amussab/Digital-Twin-Senior-Proj/AI-engine/DESIGN.md

# AI-engine — design contract

Owner: ICS (Jaddoua). Coordinator-authored 2026-10-04. This file is the interface that the
ml-engineer, data-engineer, backend-engineer and digital-twin-engineer agents build against.
Change it deliberately and note the change at the bottom.

`AI-test/` is the earlier synthetic-only testbench. Reuse its code freely (dsp, payload, models,
rul, export). `AI-engine/` is the production engine. It is trained on real public run-to-failure
and seeded-fault data, then fine-tuned on rig data once that exists.

## 1. What it must achieve (from `Project architecture/overview/Specifications.md`)

| Spec | Target | Model / part |
|---|---|---|
| S7 (ICS1) | RUL MAPE ≤15% on held-out degradation window | N-HiTS (+ TFT-selected threshold) |
| S8 (ICS2) | Classification <200 ms/window | TFT |
| IS1 | Sensor→classify+RUL→dashboard <500 ms (ICS leg measured here) | engine + backend |
| IS3 | macro-F1 ≥85% over {healthy, outer_race, inner_race, ball, cage}; stage error ≤1; fault caught by stage 3 | TFT + staging |
| IS2 | Physics-AI RUL residual ≤5% stage 1→3 | needs a physics RUL (digital twin) |
| C4 / C5 | Local only; no cloud | engine is offline; backend binds to LAN |

## 2. Package layout

```
AI-engine/
  aiengine/
    config.py          constants mirrored from team docs + spec targets
    dsp.py             COE Components 3–7 (from AI-test), plus bearing_features(x, y, rpm, cfg) → 16
    geometry.py        bearing geometries per dataset → characteristic orders
    datasets/          one adapter per dataset → window table (schema §3), cached to parquet
      xjtu_sy.py  ims.py  mafaulda.py  synthetic_rig.py  common.py
    features.py        per-bearing engineered inputs (C#-portable), baselines
    labels.py          onset detection, ground-truth health stages, observable class, RUL labels
    splits.py          frozen bearing-level train/val/test splits → splits.json
    models.py          N-HiTS, TFT builders
    train.py           pretrain + finetune entry points
    rul.py             HI forecast → RUL; class-conditioned thresholds
    evaluate.py        spec scoring → reports/*.json + *.md (provenance on the face)
    export.py          ONNX + model_contract.json + golden test vectors
    engine.py          HybridEngine: runtime inference on 32-feature rig windows (reference impl)
  app.py               CLI: data | train | finetune | evaluate | export | demo | selftest
  models/              committed ONNX + model_contract.json + golden vectors (small)
  reports/             tracked evidence reports
  notebooks/           PPR evidence notebook
  data/                gitignored (raw/ + cache/)
```

## 3. Window table schema (every dataset adapter returns exactly this)

One row = one 20-revolution window of ONE bearing.

| column | type | meaning |
|---|---|---|
| dataset | str | `xjtu_sy`, `ims`, `mafaulda`, `synthetic_rig`, `rig` |
| unit_id | str | globally unique sequence key = one bearing in one run/record, e.g. `xjtu_sy:Bearing2_3`, `ims:test1:B3`, `mafaulda:overhang/cage_fault/20g/41.5:overhang` |
| bearing_key | str | physical bearing identity used for splitting (several units can share one: all MaFaulDa records of one fault-type+position+severity share an identity group, see §5) |
| window_index | int | 0..n-1, consecutive within unit, time-ordered |
| t_hours | float | machine time of this window since run start (NaN for non-time-series records) |
| rpm | float | measured shaft speed for the window |
| fault_class | str | ground truth for the unit: healthy / outer_race / inner_race / ball / cage / mixed / unknown |
| run_to_failure | bool | true only for units that end in failure |
| life_hours | float | total life of the unit (NaN if not run-to-failure) |
| rul_hours | float | life_hours − t_hours (NaN if not run-to-failure) |
| severity | str | seeded-fault severity tag (MaFaulDa mass, etc.), else "" |
| x_bp_rms … x_bpfi_mag | float32 ×8 | COE C7 features of axis X (order: bp_rms, bp_kurtosis, bp_crest, env_rms, ftf_mag, bsf_mag, bpfo_mag, bpfi_mag) |
| y_bp_rms … y_bpfi_mag | float32 ×8 | same, axis Y |
| fs_hz | float | source sample rate |
| band_hz | str | band-pass actually used (e.g. "2000-8000") |
| orders | str | JSON of the FTF/BSF/BPFO/BPFI orders used for this bearing |

Mapping to the rig payload: bearing 1 = features[0:16] (X = 0–7, Y = 8–15), bearing 2 =
features[16:32].

Windowing: cut each raw record into consecutive non-overlapping 20-rev windows using the record's
rpm. For snapshot-style run-to-failure data (XJTU-SY, IMS), keep **the first 20-rev window of
each snapshot** (one window per time step, rig-equivalent). Seeded-fault records (MaFaulDa) keep
all their windows.

## 4. Engineered model inputs (per bearing, C#-portable)

Baseline = per-unit healthy reference:
- **Run-to-failure units:** median of the first 24 windows.
- **MaFaulDa:** median over the speed-matched `normal` record at the same bearing position
  (nearest rpm). This is the commissioning baseline of that machine at that speed.
- **Rig:** the commissioning capture (spec M5).

Inputs are those of AI-test's `features.py`, re-expressed per bearing. `plane_asymmetry` is
replaced by `axis_asymmetry` (X vs Y envelope ratio). The ml-engineer may add or remove inputs
if validation supports it, but every input must stay arithmetic on (window, baseline).

## 5. Splits (frozen before any test scoring)

- Run-to-failure bearings (XJTU-SY 15, IMS test1 B1–B4): split by bearing, stratified by
  operating condition. Test bearings are listed in `splits.json`. Because N is small, also run
  leave-one-bearing-out cross-validation on train+val bearings for model selection only.
- MaFaulDa: split by **(position, fault type, severity) groups × speed blocks**, so test speeds
  are never seen for that group. Records at neighbouring speeds are near-duplicates, so a random
  record split leaks.
- IMS test1 is also the **fine-tuning demonstration domain**: pretrain without it, fine-tune on
  its train portion, test on its held-out portion. This is the "new machine" rehearsal for the
  team's rig.

## 6. Labels

- **Onset** (first predicting time): HI exceeds μ+3·max(σ, 0.01) of the 24 onset-baseline windows
  (HI windows 6–29, i.e. after a 6-window run-in skip) for 12 consecutive windows; onset = the
  first window of that run. The detector runs causally, so the same rule works at runtime.
  (Was μ+3σ, σ floor 0.02, 3 consecutive, no skip; changed 2026-10-04, see change log.)
- **Ground-truth health stage (1–6) for run-to-failure units:** stage 1 before onset. The
  degradation interval [t_onset, T_fail] is split into 5 equal-time parts → stages 2–6.
  `[CLAUDE-SYNTHESIS]` A defined labelling, documented as such.
- **Observable class:** `healthy` until onset, then the unit's fault_class (same detectability
  policy as AI-test). `mixed` / `unknown` units are excluded from classification but kept for RUL.

## 7. S7 metric — pre-registered (written before any test result exists)

- **Degradation window** = [t_onset, T_fail − 0.1·(T_fail − t_onset)]. The last 10% is excluded
  because RUL_true → 0 makes per-window percentage error unbounded there.
- **MAPE** = mean over held-out test bearings of (mean over that bearing's degradation-window
  windows of |RUL_pred − RUL_true| / RUL_true). Hours. Bearing-averaged, so long-lived bearings
  don't dominate.
- Also reported, never substituted: RMSE (h), PHM-2012 score, percent-of-life error, and MAPE
  over the full degradation window.

## 8. Runtime contract (engine.py, mirrored by C# via ONNX)

Input per rig window: `rpm` (f32), `features[32]` (f32), `t20_ms`, plus the stored per-bearing
baselines. HybridEngine keeps a rolling buffer per bearing. TFT needs `tft_encoder_length`
windows; N-HiTS needs `nhits_encoder_length` RUL-cadence steps. Before the buffers fill, it
returns `warming_up`.

Output per window per bearing:
```json
{ "bearing": 1, "fault_class": "outer_race", "class_probs": {...}, "confidence": 0.93,
  "health_index": 0.41, "health_stage": 3, "rul_hours": 12.4, "rul_interval_hours": [9.1, 16.0],
  "top_features": [["bpfo_share", 0.31], ...], "latency_ms": {"features": .., "tft": .., "nhits": ..} }
```
The backend maps the worse of the two bearings onto `DashboardSnapshot`.

`model_contract.json` carries: input names/order, encoder lengths, class labels in
output-channel order, feature constants, thresholds, and golden input→output vectors for C#
parity tests.

## Change log
- 2026-10-04: initial contract (coordinator).
- 2026-10-04 (ml-engineer, coordinator decision 1): `splits.py::_split_xjtu` policy v2, frozen in
  `splits.json` before any real-data model was trained or scored. One test bearing per operating
  condition; outer_race, inner_race and cage each get ≥1 test AND ≥1 training bearing; mixed and
  <60-window bearings not test-eligible; seeded draw among all valid assignments. Result:
  test = Bearing1_4 (cage), Bearing2_5 (outer), Bearing3_4 (inner); val = 1_3, 2_2, 3_5;
  train = the other 9. IMS: B1/B2/B3 ft_train, B4 ft_test (unchanged).
- 2026-10-04 (ml-engineer, coordinator decision 3): §6 onset rule tuned on XJTU-SY **train+val
  bearings only** (12 bearings; test bearings and IMS never looked at for this). Grid: σ floor
  {0.01…0.08} × consecutive {3,5,8,12} × run-in skip {0,6,12} windows. Pre-declared selection rule:
  (1) fewest false onsets, a false onset being a bearing whose post-onset windows fall back under
  the threshold more than 10% of the time; (2) fewest bearings with no onset; (3) earliest mean
  onset (fraction of life). Winner: σ floor 0.01, 12 consecutive, 6-window skip (0 false onsets,
  mean onset at 0.64 of life, mean post-onset reversion 0.8%). The old rule (0.02 / 3 / 0) had 1
  false onset (Bearing3_2, 19% reversion). Applied unchanged to every dataset.
  **Effect on IMS (reported, not tuned):** IMS test1 onsets still fire at window ~170 (~171 h) on
  B3 and B4. The HI of all four IMS bearings, including the healthy B1, steps up to a new plateau
  around that point, so this is a machine-level level shift after the 24-window baseline, not a
  bearing-level run-in that a per-bearing σ floor or a few-window skip can remove. Next lever:
  take the baseline after the run-in/settling period (the rig's commissioning capture, spec M5,
  is exactly that), or recalibrate the onset rule on the new machine's own ft_train data as part
  of fine-tuning (not done here: coordinator decision 3 forbids per-dataset retuning).
- 2026-10-05 (ml-engineer): TFT selected on XJTU-SY VAL bearings (`select tft`, grid encoder {6,12} ×
  class-weight power {0.25,0.5}; the original run used encoder 6 / power 1.0): encoder 12, power 0.25,
  val macro-F1 0.773 (`reports/model_selection_tft_20261004T210533Z.json`). Val holds only outer_race +
  healthy, so this choice is weakly informed for cage/inner. Ball: its only bearing (IMS B4) is the IMS
  fine-tune test bearing, so no training data has ball and the TFT has 4 output channels (cage,
  healthy, inner_race, outer_race). IS3 primary macro-F1 = the classes with train AND test support;
  the 5-class figure (ball F1 = 0) is reported alongside. `train.tft_predict` maps target labels the
  model has no channel for to a placeholder (the target is not an input; truth is merged afterwards).
- 2026-10-05 (ml-engineer, IS3 v2 with MaFaulDa): **MaFaulDa splits frozen in `splits.json` (section
  `mafaulda`, created 2026-10-05T00:41:52Z) before any MaFaulDa model was trained or scored.** Policy =
  `splits.py::_split_mafaulda` unchanged: one identity group per (position, fault, severity) (26 groups:
  2 healthy positions + 3 faults × 4 severities × 2 positions); within a group the records are sorted by
  rpm and cut into 5 contiguous speed blocks; block `(g + offset) % 5` → test, block `+2` → val, the other
  three → train (seeded offset), so test speeds of a group are never seen for that group and every speed
  range appears in test across groups. Result: 701 train / 235 val / 233 test units (5,922 / 1,907 / 1,911
  windows). XJTU-SY and IMS sections byte-identical to before (checked; pre-change copy in
  `checkpoints/real_v2/splits_before_mafaulda.json`). Residual risk, stated: the same speed can appear in
  training for a *different severity* of the same fault/position (groups are per severity, per §5).
  Baselines: the speed-matched `normal` record at the same position (`features.make_mafaulda_provider`,
  verified in use via `default_provider`); normal records never baseline themselves.
- 2026-10-05 (ml-engineer, IS3 v2): **labels.** MaFaulDa seeded faults are observable from window 0
  (the defect is physically present for the whole record, no run-in): `observable_class = fault_class` on
  every window (labels.py non-RTF branch). **Training (v2):** one joint TFT on XJTU-SY train + IMS
  ft_train + MaFaulDa train (IMS ft_train joins pretraining here, so the IMS test bearing B4 is scored by
  this same model; no separate TFT fine-tune). Early stopping and selection on VALIDATION only (XJTU-SY
  val 1_3/2_2/3_5 + MaFaulDa val blocks). Grid encoder {4, 6} (min 2) × class-weight power {0, 0.25,
  0.5, 1}; pre-declared rule in `aiengine/v2.py`. Dataset identity is not an input. Inner race comes only
  from XJTU-SY/IMS and has no validation support, so per-source confusion matrices are reported. N-HiTS and
  the RUL calibration are reused unchanged from run `real`; S7 is re-reported because the TFT class picks
  the RUL threshold. **v2 is the second look at the XJTU-SY/IMS test bearings** (v1 reports kept).
- 2026-10-05 (ml-engineer, IS3 v2 outcome): grid winner on VALIDATION = encoder 4 (min 2), class-weight
  power 0.5, **plus the causal onset gate on run-to-failure (continuous-monitoring) units** (pooled val
  macro-F1 0.917 vs 0.875 flat; `reports/model_selection_tft_v2_20261005T011306Z.json`). The gate is a
  decision rule on a flat 5-class TFT, carried in the contract as `classes.decision.type =
  "rtf_onset_gate"` (engine.py + `train.tft_predict` via a `<ckpt>.decision.json` sidecar): before onset
  confirmation p(healthy)=1; after it, fault probabilities renormalised, p(healthy)=0. Short seeded-fault
  records use the plain softmax. (A first aggregation had a bug, `p_fault_gate` counted as a class; fixed
  and re-scored from the saved val predictions before any test scoring.) Test scored once as `real_v2`:
  IS3a 5-class 0.581 (MaFaulDa 0.848, XJTU-SY 0.450, IMS 0.679): FAIL. Main failure is a source shortcut
  validation could not see: IMS B4 ball → inner_race (IMS B3 inner race is the only IMS-domain fault in
  training). Next lever (needs a fresh, untouched test set to claim anything): domain-balanced training
  or per-dataset baseline normalisation of the order-band shares.
- 2026-10-24 (ml-engineer, UP2 contract v3, [SYNTHETIC]): `aiengine/synth_v3` generator (2 bearings x biaxial, payload
  level; magnitudes calibrated to XJTU-SY end-of-life envelope ratio; knobs narrowed on VALIDATION, first-draft ranges kept
  as the `synth_v3_hard` robustness set). Splits by run frozen in `splits.json` section `synth_v3` (155/35/50 runs) +
  480 training-only runs (`synth_v3_train2`). Deployed v3 heads = gradient-boosted trees behind an in-graph window
  aggregator (`up2_window.py`), exported into the existing TFT/N-HiTS ONNX slots (`models/model_contract_v3.json`,
  `rul.method = direct_v3`); TFT + N-HiTS retrained on the same runs (`models/model_contract_v3_nn.json`). S7 uses the
  section 7 pre-registered window (detected onset); the true-onset variant is reported alongside. Single test pass
  20261024T025531Z (GBM) / NN index in `reports/up2_preds/`. Re-score: `python -m aiengine.up2_eval`.
