amussab/Digital-Twin-Senior-Proj/AI-engine/reports/up2d_is2_20261024T225605Z.md

# IS2 wording v2 check -- [SYNTHETIC] synth_v3_test4 + [SIMULATION] FE twin

**Provenance: synthetic generator runs (aiengine/synth_v3) and a simulated FE twin with ASSUMED geometry; not a measurement of the team rig.**

- generated 2026-10-24T22:55:49+00:00, commit `355831c` (dirty=True), seed 20261004
- command: `python -m aiengine.up2d_eval`; predictions `up2d_is2_test4_20261024T225236Z.index.json` (made once, 2026-10-24T22:53:44+00:00)
- set: test4 (100 FRESH runs, hash `8fa18243ff54183b`), registered in splits.json before any IS2-v2 choice; thresholds frozen from validation in `reports/up2d_is2_select_20261024T225211Z.json` and committed before this set was scored

## Spec text

**v2 (verdict):** IS2 Physics-AI RUL agreement (wording v2). For the faulted bearing of every run-to-failure run, over every window in true health stages 1-3 after the AI warm-up, the disagreement e = |RUL_physics - RUL_AI| / L_ref between the FE-twin physics RUL and the deployed AI RUL, expressed as a fraction of the bearing's reference (rated) life L_ref at its duty speed, shall satisfy: (a) median over bearings of each bearing's median e <= 0.18 (18 % of L_ref), and (b) 95th percentile over bearings of each bearing's 95th-percentile e <= 0.63 (63 % of L_ref).

**v1 (kept, superseded):** "Physics-AI residual: max relative error between the FE-identified physics RUL and the AI RUL <=5%, health stage 1->3"

## Verdict

| reading | AI | value | target | verdict |
|---|---|---|---|---|
| IS2 v2 (a) median of bearing medians | v3b | 16.3 % of L_ref | <= 18.0 % | PASS |
| IS2 v2 (b) p95 of bearing p95s | v3b | 49.2 % of L_ref | <= 63.0 % | PASS |
| **IS2 v2 overall** | v3b (deployed) | | | **PASS** |
| IS2 v1 literal: max per-window rel. to RUL_AI | v3b | 233.4 % | <= 5 % | **FAIL** |
| IS2 v2 (a) median of bearing medians | v3c | 18.3 % of L_ref | <= 18.0 % | FAIL |
| IS2 v2 (b) p95 of bearing p95s | v3c | 47.8 % of L_ref | <= 63.0 % | PASS |
| **IS2 v2 overall** | v3c (research) | | | **FAIL** |
| IS2 v1 literal: max per-window rel. to RUL_AI | v3c | 216.1 % | <= 5 % | **FAIL** |

n = 15863 windows, 80 bearings; physics value = rated-life prior on 97.4 % of windows. Window-level e (v3b): median 15.8 %, p95 39.8 %, max 76.6 %; worst bearing p95 65.5 %.

Context, same pass (v3b): S7 12.39 %, macro-F1 0.9608, stage max 1, caught 80/80.

By stage (v3b): stage 1: median 16.1 %, p95 38.1 %, stage 2: median 13.0 %, p95 34.0 %, stage 3: median 18.5 %, p95 45.5 %

By rpm (v3b): 1750 rpm: 38 bearings, MED 13.7 %, P95 52.0 %, 3600 rpm: 42 bearings, MED 17.2 %, P95 45.2 %

## Why the thresholds (validation only)

| set | v3b MED | v3b P95 | perfect-AI floor MED | floor P95 | v3c MED | v3c P95 |
|---|---|---|---|---|---|---|
| val4 | 15.3 % | 47.7 % | 15.3 % | 45.7 % | 17.4 % | 49.4 % |
| val2 | 15.6 % | 53.6 % | 15.5 % | 57.1 % | 16.3 % | 52.8 % |

Rule: ceil to 0.01 of 1.1 x max over validation sets of max(v3b value, perfect-AI floor) -> T_MED = 0.18, T_P95 = 0.63. The perfect-AI floor is the disagreement the TRUE RUL itself has with the physics RUL on the same windows: on validation a tighter threshold would fail an exact AI, i.e. it would test the physics prior, not the AI.

## Negative controls (deliberately wrong AI RULs; all must FAIL)

| control | MED | P95 | verdict test4 |
|---|---|---|---|
| AI x 1.5 (optimistic bias) | 21.6 % | 91.2 % | FAIL |
| AI x 0.6 (pessimistic bias) | 29.4 % | 60.3 % | FAIL |
| AI + 0.3 L_ref | 23.0 % | 79.1 % | FAIL |
| AI time-reversed within bearing | 17.8 % | 66.2 % | FAIL |
| AI = 0.5 L_ref constant | 18.5 % | 42.7 % | FAIL |
| AI = truth x lognormal(0, 0.5) noise | 25.7 % | 172.4 % | FAIL |

Perfect-AI floor on this set (RUL_AI := RUL_true): MED 18.1 %, P95 48.5 % -> FAIL.
**Disclosure: an exact AI would FAIL clause (a) on this set.** The median clause therefore does not reward accuracy: it rewards agreement with the twin's (mostly prior) RUL, and its threshold sits inside the set-to-set variation of the physics floor (validation 15.3-15.5 %, this set 18.1 %). The deployed AI passes because its RUL is closer to the physics prior than the truth is, not because it is more accurate than truth. Clause (b) and the controls are the parts with discriminating power.

Residual as a flag of a bad AI estimate (|AI - truth| > 0.20 L_ref), v3b: AUROC 0.550 (share bad 35.2 %). Weak: in stages 1-3 the physics RUL carries little information beyond the rated life, so the residual catches gross bias/inversion (controls) better than ordinary AI error.

## Sweep (same windows, v3b; NOT the spec metric)

| normaliser | window max | window p95 | window median | bearing-median median | bearing-p95 p95 | worst bearing p95 |
|---|---|---|---|---|---|---|
| RUL_AI (v1) | 233.4 % | 78.7 % | 27.5 % | 30.5 % | 143.0 % | 209.5 % |
| L_ref (v2) | 76.6 % | 39.8 % | 15.8 % | 16.3 % | 49.2 % | 65.5 % |
| RUL_true | 242.3 % | 67.8 % | 23.1 % | n/a | n/a | n/a |

v1 literal history (up2c_spec_check_20261024T175404Z.json, synth_v3_test3): max v3b 244.6 %, v3c 245.6 %, ablation 243.4 %.

## Limitations (state alongside the number)

1. **Circularity.** The twin's stiffness trajectory K(t) = K0 (1 - 0.25 damage) is derived from the same synthetic damage that drives the accelerometer features and the RUL label; agreement here is agreement of two estimators of one latent variable on generated data, not evidence about real bearings.
2. **The physics value is mostly the prior.** In stages 1-3 K drops by <= ~5 % against ~6 % (1750 rpm) / ~25 % (3600 rpm) per-window identification noise, so the twin's RUL is the rated-life prior max(L_ref - age, 0.1 L_ref) on 97.4 % of windows. IS2 v2 therefore checks that the AI stays within the physically plausible envelope of the twin (no gross bias, no inverted trend), not that the twin independently confirms the AI's accuracy; accuracy is S7 / IS3.
3. **3600 rpm identification gate.** K is weakly observable above the bearing mode; the gate rejects most 3600 rpm windows, so at 3600 rpm the physics RUL is the prior almost everywhere.
4. **L_ref is synthetic.** L_ref = median TRAIN-run life per speed (72.9 h at 1750, 46.5 h at 3600 rpm); on the rig it becomes the ISO 281 L10 (or L50) at the duty point, and the thresholds must be re-derived on rig validation data.
5. **v3c is research.** It consumes RUL_physics as an input, so its residual measures consistency, not independent validation.
6. Thresholds were set from the deployed v3b on validation; the median clause separates v3b from an uninformative constant AI by a small margin (see controls).
