amussab/Digital-Twin-Senior-Proj/AI-engine/reports/up2_residual_20261024T173626Z.md

# IS2 physics-AI RUL residual  (2026-10-24T17:36:26+00:00)

**[SIMULATION] + [SYNTHETIC].**  Not a measurement on the rig.  Spec text (quoted): "Physics-AI residual: max relative error between the FE-identified physics RUL and the AI RUL <=5%, health stage 1->3"

## Verdict

| Reading | Value | Target | Verdict |
|---|---|---|---|
| IS2 literal: max per-window residual, stages 1-3, nominal, tuned filter | 302.1 % | <= 5 % | **FAIL** |
| p95 residual (alternative reading) | 90.8 % | <= 5 % | FAIL |
| median / mean residual | 39.0 % / 43.6 % | - | - |
| share of windows with residual <= 5 % | 5.3 % | - | - |
| physics coverage (stage 1-3 windows with a physics RUL) | 57.6 % | - | - |

Metric: `residual = |RUL_physics - RUL_AI| / RUL_AI` per window, hours, faulted bearing of each run-to-failure `test2` run, TRUE stage in {1,2,3}, windows where both RULs exist (n = 9478 windows, 40 runs).  AI predictions: `up2_v3b_gbm_20261024T114647Z.index.json` ([SYNTHETIC] synth_v3, predictions tag 20261024T114647Z).

### ALTERNATIVE reading (NOT the spec metric): accuracy of each estimator against the TRUE RUL

| Quantity (same windows) | median | mean | p95 | max |
|---|---|---|---|---|
| AI RUL vs TRUE RUL: |AI-truth|/truth | 15.9 % | 19.8 % | 51.2 % | 118.1 % |
| physics RUL vs TRUE RUL: |phys-truth|/truth (physics accuracy) | 44.6 % | 49.2 % | 99.5 % | 287.7 % |
| AI-vs-truth FLOOR on the residual: |truth-AI|/AI (residual if physics were perfect) | 16.7 % | 25.8 % | 94.4 % | 175.7 % |

Structural cause: the residual cannot be smaller than the AI's own error unless the physics RUL copies the AI. A <= 5 % physics-AI residual needs BOTH estimators within a few percent of the true RUL, much tighter than S7 (<= 15 % MAPE).

### Limitations to state alongside the number

1. **Circularity.** The stiffness trajectory K(t) fed to the FE twin is derived from the same synthetic damage curve that drives the generator's features and RUL label.  Agreement here is agreement of two estimators of one latent variable, not evidence about real bearings.
2. **Floor set by the AI.** The AI RUL has its own error vs truth, so even a perfect physics RUL gives a residual of 16.7 % median / 175.7 % max (row 'perfect physics' below).  A <= 5 % IS2 would need the AI to be within ~5 % of truth, which S7 (MAPE 15 %) does not require.
3. **Stage 1 has no trend.** Before onset K is constant; the trend-based physics RUL is (correctly) silent there.  Coverage by stage is in the JSON.
4. **3600 rpm.** K is weakly observable above the bearing mode (twin README); the identification gate drops most such windows, so 3600 rpm runs contribute little or no physics RUL (coverage by rpm below).
5. Identification and FE model are the twin's initial, replaceable version with ASSUMED geometry (`twin/params.py`).

## Sweep (test runs scored once per row; tuned filter unless stated)

| Setting | What changed | coverage | n | max | p95 | median | mean | <=5 % share | phys-vs-truth median |
|---|---|---|---|---|---|---|---|---|---|
| nominal | documented sensor model +/-5 % amp, +/-0.05 rad; exact FE plant; K drop linear in damage | 57.6 % | 9478 | 302.1 % | 90.8 % | 39.0 % | 43.6 % | 5.3 % | 44.6 % |
| nominal, STOCK filter | twin as committed (fit 200, no EMA, gate 0.15) | 15.5 % | 2552 | 2439.7 % | 1103.1 % | 444.6 % | 484.3 % | 0.1 % | 392.3 % |
| perfect physics (RUL_physics := truth) | lower bound of the residual given this AI | 100.0 % | 9478 | 175.7 % | 94.4 % | 16.7 % | 25.8 % | 16.8 % | 0 |

## Nominal, by stage and rpm (residual vs AI)

| group | n | max | p95 | median | mean | <=5 % share |
|---|---|---|---|---|---|---|
| stage 1 | 4320 | 116.2 % | 87.9 % | 45.0 % | 46.2 % | 4.1 % |
| stage 2 | 2586 | 201.3 % | 87.1 % | 34.6 % | 38.2 % | 5.6 % |
| stage 3 | 2572 | 302.1 % | 120.2 % | 35.1 % | 44.8 % | 6.9 % |
| 1750 rpm | 9478 | 302.1 % | 90.8 % | 39.0 % | 43.6 % | 5.3 % |

Coverage by rpm: 1750 rpm 99.2 %, 3600 rpm 0.0 %.  Coverage by stage: stage 1 49.1 %, stage 2 67.2 %, stage 3 67.4 %.

AI vs truth on the same windows: median 15.9 %, mean 19.8 %; physics vs truth: median 44.6 %, mean 49.2 %.

## Filter tuned on VALIDATION runs only (objective: physics vs TRUTH RUL, stages 2-3)

Chosen: {'fit_points': 200, 'ema_alpha': 0.3, 'max_rel_std': 0.15, 'model': 'law', 'weighted': True, 'sig_gate': False, 'law_a': 0.3, 'law_p': 3.0}.  Stock: {'fit_points': 200, 'ema_alpha': 1.0, 'max_rel_std': 0.15, 'model': 'exp', 'weighted': False, 'sig_gate': True, 'law_a': 0.3, 'law_p': 2.5}.  Best 8 of 80 grid points by mean APE (plus the stock row):

| fit_points | ema_alpha | gate | model(a,p) | weighted | sig_gate | coverage(st2-3) | mean APE vs truth | median APE vs truth |
|---|---|---|---|---|---|---|---|---|
| 200 | 0.3 | 0.15 | law(0.3,3.0) | True | False | 80.4 % | 40.3 % | 33.7 % |
| 200 | 1.0 | 0.15 | law(0.3,3.0) | True | False | 80.4 % | 41.8 % | 34.9 % |
| 120 | 0.3 | 0.15 | law(0.3,2.0) | True | False | 80.4 % | 42.0 % | 34.9 % |
| 200 | 0.3 | 0.15 | law(0.3,2.5) | True | False | 80.4 % | 42.3 % | 33.4 % |
| 120 | 0.3 | 0.15 | law(0.3,2.5) | True | False | 80.4 % | 42.9 % | 37.5 % |
| 120 | 1.0 | 0.15 | law(0.3,2.0) | True | False | 80.4 % | 43.6 % | 36.5 % |
| 200 | 1.0 | 0.15 | law(0.3,2.5) | True | False | 80.4 % | 43.9 % | 34.8 % |
| 120 | 0.3 | 0.15 | law(0.3,3.0) | True | False | 80.4 % | 44.4 % | 39.6 % |
| 200 | 1.0 | 0.15 | exp(0.3,2.5) | False | True | 30.8 % | 409.9 % | 325.2 % |

## C# port impact

Needed in `src/DigitalTwin.Twin` (identification and `fit_rul` unchanged): a new RUL estimator replacing `fit_rul`: degradation-law grid posterior `law_rul` in aiengine/up2_residual.py (assumed damage law D(u)=0.3u+0.7u^3.0, onset grid 24 x RUL grid 32 (0.25..300.0 h, geometric), Gaussian likelihood with the identifier's rel_std, posterior median; ~40 lines of C#, no new dependencies).  Identification, gating logic and golden K vectors unchanged; a causal RUL smoothing stage after `PhysicsTwin` output: when a raw RUL exists and state exists, `prior = max(ema - (t_h - t_prev), 0); ema = prior + 0.3*(raw - prior)`, else `ema = raw`; `t_prev = t_h` on every raw RUL; None stays None.  Identification, fit_rul, gating logic and the golden vectors are otherwise unchanged.  `twin_golden.json` stays valid for K identification; the RUL golden must be regenerated if constants change.

## Provenance

- command: `python -m aiengine.up2_residual --preds-index up2_v3b_gbm_20261024T114647Z.index.json`; commit b92acf8 (aiengine dirty: False); seed 20261004
- data: [SYNTHETIC] aiengine/synth_v3 generator (physics-informed, not measured), table_hash efa1da17b3c222cc; split `test2`: 80 faulted-bearing units
- predictions: `up2_v3b_gbm_20261024T114647Z.index.json` ([SYNTHETIC] synth_v3, predictions tag 20261024T114647Z); test predictions were made once by the ML agent, this script only reads them
- all numbers: [SIMULATION] physics twin driven by a [SYNTHETIC] damage-derived stiffness trajectory
