amussab/Digital-Twin-Senior-Proj/AI-engine/reports/coe_adapt_20261024T213622Z.md

# COE domain gap: deployed v3b classifier vs COE-adapted classifier

Generated 2026-10-24T21:36:40+00:00 | commit e7b04d1 (dirty) | seed 20261004 | command `python -m aiengine.coe_adapt_eval`

**ALL DATA [SIMULATION]/[SYNTHETIC].** Test windows = raw samples from the COE rig simulator (aiengine/coe_dataset.py DualFaultRigSource; invented amplitudes, not rig-calibrated) through the real causal CoePipeline (C1-C9). Training data = synth_v3 [SYNTHETIC] + COE-train [SIMULATION]. Nothing here validates anything on real hardware; it only shows the models now accept the features the COE pipeline produces.

Dataset synth_coe: 420 runs, 29400 rig windows (58800 bearing-windows), split BY RUN in splits.json section `synth_coe` (registered before any fit), test scored once (2026-10-24T21:33:07+00:00). Each run: 30 healthy (commissioning) windows then 40 with defect(s) on bearing 1, bearing 2, both or neither; severities [0.15, 0.3, 0.5, 0.75, 1.0]; rpm 1750/3600 + off-nominal 1738/3624 (+-1 % band) + 2400/3000 (range policy).

Selected on COE-val: **mix_w0.6** + cross-bearing gate (signal family, tau 0.6); COE-val macro-F1 0.8948, synth_v3-val macro-F1 0.9658.

## COE-test (scored once)

| Metric | v3b as deployed | base_plus_gate | selected_nogate | selected |
|---|---|---|---|---|
| macro-F1 (5 classes) | 0.5842 | 0.7250 | 0.7769 | 0.8745 |
| accuracy | 0.6547 | 0.8378 | 0.7928 | 0.8940 |
| bearing-2 false-fault rate (B2 healthy, B1 faulted) | 82.1 % | 4.4 % | 53.0 % | 0.6 % |
| bearing-1 false-fault rate (B1 healthy, B2 faulted) | 74.7 % | 2.6 % | 39.5 % | 0.0 % |
| false-fault rate, both bearings healthy | 0.1 % | 0.0 % | 0.0 % | 0.0 % |
| missed-fault rate (faulted -> healthy) | 2.2 % | 13.9 % | 15.4 % | 22.8 % |
| wrong fault class (faulted -> other fault) | 28.6 % | 19.5 % | 3.8 % | 0.2 % |
| F1 healthy | 0.7592 | 0.9361 | 0.8167 | 0.9114 |
| F1 outer_race | 0.7199 | 0.8968 | 0.7568 | 0.8160 |
| F1 inner_race | 0.6874 | 0.8682 | 0.7563 | 0.9094 |
| F1 ball | 0.5130 | 0.6779 | 0.7629 | 0.9079 |
| F1 cage | 0.2417 | 0.2457 | 0.7920 | 0.8280 |

Columns: `base_plus_gate` = deployed trees + the selected gate; `selected_nogate` = selected candidate before the gate (ablation). Rates are per bearing-window; the transition window of each run is excluded.

## Per-bearing role confusion (COE-test)

**base**

| bearing | role | pred healthy | pred correct fault | pred other fault |
|---|---|---|---|---|
| B1 | faulted | 31 | 1428 | 608 |
| B1 | healthy_partner_faulted | 346 | 0 | 1019 |
| B1 | healthy_partner_healthy | 1337 | 0 | 1 |
| B2 | faulted | 64 | 1595 | 642 |
| B2 | healthy_partner_faulted | 203 | 0 | 928 |
| B2 | healthy_partner_healthy | 1337 | 0 | 1 |

**selected**

| bearing | role | pred healthy | pred correct fault | pred other fault |
|---|---|---|---|---|
| B1 | faulted | 495 | 1567 | 5 |
| B1 | healthy_partner_faulted | 1365 | 0 | 0 |
| B1 | healthy_partner_healthy | 1338 | 0 | 0 |
| B2 | faulted | 502 | 1797 | 2 |
| B2 | healthy_partner_faulted | 1124 | 0 | 7 |
| B2 | healthy_partner_healthy | 1338 | 0 | 0 |

## Slices (COE-test)

| slice | v3b | selected |
|---|---|---|
| macro-F1 @ 1738.0 rpm | 0.6683 | 0.8061 |
| macro-F1 @ 1750.0 rpm | 0.5545 | 0.8907 |
| macro-F1 @ 2400.0 rpm | 0.5757 | 0.7855 |
| macro-F1 @ 3000.0 rpm | 0.5075 | 0.7594 |
| macro-F1 @ 3600.0 rpm | 0.5677 | 0.8998 |
| macro-F1 @ 3624.0 rpm | 0.4006 | 0.7156 |
| fault recall @ severity (-0.001, 0.1] | 0.467 | 0.011 |
| fault recall @ severity (0.1, 0.2] | 0.836 | 0.474 |
| fault recall @ severity (0.2, 0.4] | 0.711 | 0.679 |
| fault recall @ severity (0.4, 0.6] | 0.628 | 0.937 |
| fault recall @ severity (0.6, 0.85] | 0.659 | 0.914 |
| fault recall @ severity (0.85, 1.0] | 0.636 | 1.000 |

## RUL / stage heads (unchanged v3b N-HiTS slot) on COE windows: diagnostic only

- raw_features: healthy-bearing raw stage >= 2 rate 100.0 % (5172 windows); faulted-bearing raw stage histogram {'2': 350, '3': 817, '4': 1154, '5': 1376, '6': 671}.
- COE runs are constant/ramp severity over 40 contiguous windows, not run-to-failure: there is no RUL or stage truth, so only the healthy-bearing false-stage rate is a meaningful check. RUL hours additionally depend on the window cadence (see aiengine/coe/README.md, 'COE time base').

## Validation grid (COE-val; selection only)

| candidate | gate | synth_v3-val F1 | eligible | COE-val F1 | COE-val B2 false-fault |
|---|---|---|---|---|---|
| base | off | 0.9633 | True | 0.5659 | 87.5 % |
| base | family tau 0.3 | 0.9701 | True | 0.6789 | 36.0 % |
| base | family tau 0.45 | 0.9687 | True | 0.7364 | 1.8 % |
| base | family tau 0.6 | 0.9666 | True | 0.7395 | 1.4 % |
| base | family tau 0.75 | 0.9646 | True | 0.7404 | 1.1 % |
| base | env tau 0.3 | 0.9701 | True | 0.7159 | 9.7 % |
| base | env tau 0.45 | 0.9691 | True | 0.7353 | 0.0 % |
| base | env tau 0.6 | 0.9672 | True | 0.7169 | 0.0 % |
| base | env tau 0.75 | 0.9653 | True | 0.7127 | 0.0 % |
| affine | off | 0.7494 | False | 0.6159 | 85.5 % |
| affine | family tau 0.3 | 0.7865 | False | 0.734 | 37.3 % |
| affine | family tau 0.45 | 0.7914 | False | 0.7886 | 3.2 % |
| affine | family tau 0.6 | 0.7954 | False | 0.7913 | 2.7 % |
| affine | family tau 0.75 | 0.7989 | False | 0.7891 | 2.4 % |
| affine | env tau 0.3 | 0.7851 | False | 0.7749 | 9.7 % |
| affine | env tau 0.45 | 0.7892 | False | 0.7891 | 0.0 % |
| affine | env tau 0.6 | 0.7928 | False | 0.7776 | 0.0 % |
| affine | env tau 0.75 | 0.7958 | False | 0.7726 | 0.0 % |
| quantile | off | 0.7711 | False | 0.6778 | 75.0 % |
| quantile | family tau 0.3 | 0.7713 | False | 0.7851 | 32.6 % |
| quantile | family tau 0.45 | 0.7713 | False | 0.8345 | 0.9 % |
| quantile | family tau 0.6 | 0.7713 | False | 0.8363 | 0.2 % |
| quantile | family tau 0.75 | 0.7713 | False | 0.8336 | 0.2 % |
| quantile | env tau 0.3 | 0.7709 | False | 0.8133 | 9.5 % |
| quantile | env tau 0.45 | 0.7709 | False | 0.8315 | 0.0 % |
| quantile | env tau 0.6 | 0.7707 | False | 0.8122 | 0.0 % |
| quantile | env tau 0.75 | 0.7709 | False | 0.7996 | 0.0 % |
| mix_w0.3 | off | 0.9608 | True | 0.7646 | 61.5 % |
| mix_w0.3 | family tau 0.3 | 0.9707 | True | 0.8424 | 29.1 % |
| mix_w0.3 | family tau 0.45 | 0.9693 | True | 0.8921 | 0.2 % |
| mix_w0.3 | family tau 0.6 | 0.9673 | True | 0.8906 | 0.0 % |
| mix_w0.3 | family tau 0.75 | 0.9654 | True | 0.8877 | 0.0 % |
| mix_w0.3 | env tau 0.3 | 0.9706 | True | 0.8698 | 9.4 % |
| mix_w0.3 | env tau 0.45 | 0.9694 | True | 0.8842 | 0.0 % |
| mix_w0.3 | env tau 0.6 | 0.9676 | True | 0.8605 | 0.0 % |
| mix_w0.3 | env tau 0.75 | 0.966 | True | 0.8369 | 0.0 % |
| mix_w0.6 | off | 0.9579 | True | 0.7691 | 63.2 % |
| mix_w0.6 | family tau 0.3 | 0.9692 | True | 0.8484 | 27.6 % |
| mix_w0.6 | family tau 0.45 | 0.9678 | True | 0.8954 | 0.3 % |
| mix_w0.6 | family tau 0.6 | 0.9658 | True | 0.8948 | 0.2 % |
| mix_w0.6 | family tau 0.75 | 0.964 | True | 0.8918 | 0.0 % |
| mix_w0.6 | env tau 0.3 | 0.9693 | True | 0.8728 | 9.5 % |
| mix_w0.6 | env tau 0.45 | 0.9681 | True | 0.8848 | 0.0 % |
| mix_w0.6 | env tau 0.6 | 0.9666 | True | 0.8616 | 0.0 % |
| mix_w0.6 | env tau 0.75 | 0.9651 | True | 0.8392 | 0.0 % |

## Deployed artefact

```
{
 "candidate": "mix_w0.6",
 "tensor_names_unchanged": true,
 "host_side_change": "cross_bearing_gate (see block)"
}
```

## Caveats

- [SIMULATION] the simulator's transmission (off-plane gain 0.25-0.45 of the partner's impacts), resonance, noise and amplitudes are invented; the real rig's transmission path and noise floor are unknown until hardware data exists. Re-fit the calibration / gate threshold on commissioning + seeded-fault data from the rig.
- A per-bearing classifier cannot separate 'small own defect' from 'partner defect transmitted' from its own 16 features; the gate uses the partner bearing of the same window for that.
- RUL/stage heads were not re-fitted: COE simulator runs are not run-to-failure (no truth for RUL). The diagnostic above shows the unchanged v3b stage head is NOT usable on COE-pipeline features: healthy COE bearings get raw z around -0.1 (synth_v3 healthy target -0.2, stage cut -0.25), i.e. stage >= 2 on every healthy window. Fix = COE run-to-failure trajectories (simulator severity driven by the synth_v3 damage curve) and a COE-refitted z/RUL head, or a z_cut recalibrated on commissioning data; not done here.
- Missed faults rise with the gate (22.8 % on test): mostly the lowest severities (ramp starts, severity <= 0.2), where the defect is weaker than the threshold and, in both-faulted runs, the weaker of two same-family defects is suppressed by design.
