amussab/Digital-Twin-Senior-Proj/AI-engine/reports/up2c_spec_check_20261024T175404Z.md

# UP2 v3c (physics-informed RUL) spec check -- [SYNTHETIC] synth_v3_test3 + [SIMULATION] FE twin

**Provenance: synthetic generator runs (aiengine/synth_v3) and a simulated FE twin with ASSUMED geometry; not a measurement of the team rig.** Displacements come from the twin with K(t) tied to the generator damage, so physics and accelerometer features share one latent damage variable (circularity: the physics benefit is an upper bound until rig data exists).

- generated 2026-10-24T17:53:00+00:00, commit `b71f165` (dirty=True), seed 20261004
- command: `python -m aiengine.up2c_eval`; predictions `up2_v3c_gbm_20261024T174757Z.index.json` (made once, 2026-10-24T17:50:03+00:00)
- test3: 100 FRESH runs, 77198 bearing-windows, hash `e22c12ff3405fbc8`; registered in splits.json before any v3c fit; selection on synth_v3_val2 only

## Spec table

| spec | model | target | measured | verdict | provenance |
|---|---|---|---|---|---|
| S7 / ICS1 | v3c physics-informed (candidate) | <= 15.00 | 10.51 % | **PASS** | [SYNTHETIC] synth_v3_test3 FRESH (1st look) |
| IS3a | v3c physics-informed (candidate) | >= 0.85 | 0.9615  | **PASS** | [SYNTHETIC] synth_v3_test3 FRESH (1st look) |
| IS3b | v3c physics-informed (candidate) | <= 1 | 1 stages | **PASS** | [SYNTHETIC] synth_v3_test3 FRESH (1st look) |
| IS3c | v3c physics-informed (candidate) | == 80 | 80 /80 | **PASS** | [SYNTHETIC] synth_v3_test3 FRESH (1st look) |
| IS2 literal max | v3c physics-informed (candidate) [CONSISTENCY: AI consumes physics] | <= 0.05 | 2.46 (fraction) | **FAIL** | [SYNTHETIC] synth_v3_test3 FRESH (1st look) + [SIMULATION] twin |
| S7 / ICS1 | v3c without physics (ablation) | <= 15.00 | 10.88 % | **PASS** | [SYNTHETIC] synth_v3_test3 FRESH (1st look) |
| IS3a | v3c without physics (ablation) | >= 0.85 | 0.9615  | **PASS** | [SYNTHETIC] synth_v3_test3 FRESH (1st look) |
| IS3b | v3c without physics (ablation) | <= 1 | 1 stages | **PASS** | [SYNTHETIC] synth_v3_test3 FRESH (1st look) |
| IS3c | v3c without physics (ablation) | == 80 | 80 /80 | **PASS** | [SYNTHETIC] synth_v3_test3 FRESH (1st look) |
| IS2 literal max | v3c without physics (ablation) [INDEPENDENT] | <= 0.05 | 2.43 (fraction) | **FAIL** | [SYNTHETIC] synth_v3_test3 FRESH (1st look) + [SIMULATION] twin |
| S7 / ICS1 | v3b frozen (deployed) | <= 15.00 | 10.75 % | **PASS** | [SYNTHETIC] synth_v3_test3 FRESH (1st look) |
| IS3a | v3b frozen (deployed) | >= 0.85 | 0.9615  | **PASS** | [SYNTHETIC] synth_v3_test3 FRESH (1st look) |
| IS3b | v3b frozen (deployed) | <= 1 | 1 stages | **PASS** | [SYNTHETIC] synth_v3_test3 FRESH (1st look) |
| IS3c | v3b frozen (deployed) | == 80 | 80 /80 | **PASS** | [SYNTHETIC] synth_v3_test3 FRESH (1st look) |
| IS2 literal max | v3b frozen (deployed) [INDEPENDENT] | <= 0.05 | 2.45 (fraction) | **FAIL** | [SYNTHETIC] synth_v3_test3 FRESH (1st look) + [SIMULATION] twin |
| IS2 ablation (Sept-3 reading) | v3c vs ablation | >= 0.15 | 0.03433 (relative S7 gain) | **FAIL** | [SYNTHETIC] synth_v3_test3 FRESH (1st look) + [SIMULATION] twin |
| S8 / ICS2 | v3c_cls_onnx (= v3b classifier) | < 200.00 | 0.3366 ms p95 | **PASS** | [MEASURED] live on this host (synthetic inputs) |
| RUL head | v3c_rul_onnx | < 200.00 | 1.11 ms p95 | **PASS** | [MEASURED] live on this host (synthetic inputs) |
| IS1 (ICS leg) | v3c_engine_rig_window | < 500.00 | 305.68 ms p95 | **PASS** | [MEASURED] live on this host (synthetic inputs) |

## IS2

Spec text: "Physics-AI residual: max relative error between the FE-identified physics RUL and the AI RUL <=5%, health stage 1->3"

Definition: |RUL_phys - RUL_AI| / RUL_AI per window; faulted bearings of test3 run-to-failure runs; true stage 1..3; window_index >= 24; RUL_true > 0.

| AI | reading | max (verdict) | p95 | median | mean | share <= 5 % | coverage | physics = prior | n |
|---|---|---|---|---|---|---|---|---|---|
| v3c | consistency (AI consumes physics) | 245.6 % (FAIL) | 77.9 % | 33.4 % | 35.8 % | 9.0 % | 100.0 % | 96.7 % | 16505 |
| ablation | independent | 243.4 % (FAIL) | 79.3 % | 29.5 % | 33.5 % | 9.5 % | 100.0 % | 96.7 % | 16505 |
| v3b | independent | 244.6 % (FAIL) | 78.5 % | 29.3 % | 33.4 % | 9.7 % | 100.0 % | 96.7 % | 16505 |
| v3 GBM (history) | independent, trend-only twin, old test | 143.2 % (FAIL) | 79.0 % | 49.6 % | - | - | 5.8 % | 0 % | - |

By stage / physics source (v3c):

```
{
 "by_stage": {
  "1": {
   "n": 8836,
   "max": 1.205539084979457,
   "p95": 0.7695384582024233,
   "median": 0.3500913033956065,
   "mean": 0.3598579988168416,
   "share_le_5pct": 0.10129017655047533
  },
  "2": {
   "n": 3849,
   "max": 1.2267127161917,
   "p95": 0.6183965201937182,
   "median": 0.23840804315463207,
   "mean": 0.26834055819615976,
   "share_le_5pct": 0.11431540659911665
  },
  "3": {
   "n": 3820,
   "max": 2.455952490551631,
   "p95": 0.8869173295215761,
   "median": 0.4166098677266207,
   "mean": 0.44206330873520344,
   "share_le_5pct": 0.039790575916230364
  }
 },
 "by_source": {
  "trend": {
   "n": 549,
   "max": 0.9228811052519615,
   "p95": 0.8603989468226323,
   "median": 0.5005409642372217,
   "mean": 0.498784606051697,
   "share_le_5pct": 0.023679417122040074
  },
  "prior": {
   "n": 15956,
   "max": 2.455952490551631,
   "p95": 0.7715709493610725,
   "median": 0.3265754976286095,
   "mean": 0.3526821995919232,
   "share_le_5pct": 0.0923790423665079
  }
 },
 "by_rpm": {
  "1750": {
   "n": 9716,
   "max": 2.455952490551631,
   "p95": 0.7630950883403033,
   "median": 0.2924230869049601,
   "mean": 0.33027473647530453,
   "share_le_5pct": 0.10601070399341293
  },
  "3600": {
   "n": 6789,
   "max": 1.8948371060671232,
   "p95": 0.8046591214660579,
   "median": 0.390368383450766,
   "mean": 0.3965651179580277,
   "share_le_5pct": 0.0673147738989542
  }
 }
}
```

Physics RUL vs truth (same windows): median 27.6 %; AI (v3c) vs truth: median 22.2 %.

**What each reading means for the safety argument.** The independent reading (ablation/v3b vs physics) is a genuine cross-check: two estimators built from different sensors (accelerometers vs proximity probes) must agree, so a large residual flags a problem in one of them. With the physics-informed AI (v3c) the residual measures how closely an AI that READS the physics RUL tracks it: a small value shows consistency, not independent validation, and cannot catch an error shared by both (e.g. a wrong stiffness model). The literal number is reported for both; neither is substituted for the other.

## Ablation (report 2026-09-03 framing)

```
{
 "S7_v3c": 10.50749449692432,
 "S7_ablation": 10.881049909291399,
 "S7_v3b": 10.752683577531048,
 "relative_improvement_vs_ablation": 0.03433082427533922,
 "relative_improvement_vs_v3b": 0.02280259423973739,
 "verdict": "FAIL",
 "target": ">= 15 % relative MAPE improvement"
}
```

## v3b history (fresh test2, scored earlier)

```
{
 "S7": 12.643877995038089,
 "F1": 0.958726372837725,
 "stage_max": 1,
 "caught": "80/80",
 "source": "up2_spec_check_20261024T114947Z.json"
}
```

## Per-model detail

- **v3c**: S7 10.51 % (80 bearings), true-onset 13.16 %, %-of-life 5.54 pts, per rpm {'1750': 10.181075755529468, '3600': 10.817990372885275}; macro-F1 0.9615; stage max 1 (within1 1.0000); caught 80/80
- **ablation**: S7 10.88 % (80 bearings), true-onset 13.36 %, %-of-life 5.57 pts, per rpm {'1750': 11.140376281174497, '3600': 10.634373604329427}; macro-F1 0.9615; stage max 1 (within1 1.0000); caught 80/80
- **v3b**: S7 10.75 % (80 bearings), true-onset 13.30 %, %-of-life 5.53 pts, per rpm {'1750': 10.9999476003322, '3600': 10.51748121437873}; macro-F1 0.9615; stage max 1 (within1 1.0000); caught 80/80

## Latency (live, this host, 1 thread)

```
{
 "v3c_cls_onnx (= v3b classifier)": {
  "p50_ms": 0.23270000019692816,
  "p95_ms": 0.3366249948157929,
  "max_ms": 0.694800000928808,
  "n": 300,
  "threads": 1,
  "batch": 1
 },
 "v3c_rul_onnx": {
  "p50_ms": 0.73079999856418,
  "p95_ms": 1.1144150066684233,
  "max_ms": 2.847499999916181,
  "n": 300,
  "threads": 1,
  "batch": 1
 },
 "v3c_engine_rig_window": {
  "p50_ms": 248.56780000118306,
  "p95_ms": 305.6836499963538,
  "max_ms": 324.5099999985541,
  "n": 131,
  "note": "one RIG window = physics update (stock twin identify; reference replay is O(n), C# keeps incremental state) + both bearings' features+cls+RUL+post-process"
 }
}
```
