amussab/Digital-Twin-Senior-Proj/AI-engine/reports/up2_spec_check_20261024T114947Z.md

# UP2 spec check (contracts v3b deployed, v3 history) -- [SYNTHETIC] synth_v3 data

**Provenance: every synth_v3 number below is [SYNTHETIC]: physics-informed generated data (aiengine/synth_v3), NOT a measurement of the team rig or of any public dataset.** The public-data (PPR v2) rows are [MEASURED on XJTU-SY / IMS / MaFaulDa], carried from their stored report.

- generated: 2026-10-24T11:49:27+00:00  commit `de29ad0` (dirty=False)  seed 20261004
- command: `python -m aiengine.up2_train `
- data: 240 runs, table hash `66031b7aa779ee8c`, split by run (splits.json section synth_v3): {'test': 50, 'train': 635, 'val': 35}
- predictions re-scored from: up2_v3_gbm_20261024T025531Z.index.json (deployed GBM heads), up2_v3_nn_20261024T074314Z.index.json (TFT + N-HiTS)
- scored windows: window_index >= 24 (every head warm: classifier needs its encoder history)

## Spec table

| spec | what | target | measured | verdict | model | provenance |
|---|---|---|---|---|---|---|
| S7 / ICS1 | RUL MAPE, absolute hours (spec metric, DESIGN.md s7 pre-registered window) | <= 15.00 | 12.64 % | **PASS** | v3b (deployed) | [SYNTHETIC] synth_v3_test2 FRESH runs (1st look) |
| S7-strict | STRICTER variant (synthetic only): same MAPE from the TRUE onset | <= 15.00 | 14.72 % | **PASS** | v3b (deployed) | [SYNTHETIC] synth_v3_test2 FRESH runs (1st look) |
| S7-alt | ALTERNATIVE (not the spec metric): percent-of-life error | <= 15.00 | 5.81 pts | **PASS** | v3b (deployed) | [SYNTHETIC] synth_v3_test2 FRESH runs (1st look) |
| IS3a | macro-F1 over {healthy, OD, ID, BD, CF} | >= 0.85 | 0.9587  | **PASS** | v3b (deployed) | [SYNTHETIC] synth_v3_test2 FRESH runs (1st look) |
| IS3b | health-stage error, literal max over all scored windows | <= 1 | 1 stages | **PASS** | v3b (deployed) | [SYNTHETIC] synth_v3_test2 FRESH runs (1st look) |
| IS3c | every injected fault caught by stage 3 (bearings) | == 80 | 80 /80 | **PASS** | v3b (deployed) | [SYNTHETIC] synth_v3_test2 FRESH runs (1st look) |
| S7 / ICS1 | RUL MAPE, absolute hours (spec metric, DESIGN.md s7 pre-registered window) | <= 15.00 | 14.73 % | **PASS** | v3b (deployed) | [SYNTHETIC] synth_v3 old test runs (2nd look) |
| S7-strict | STRICTER variant (synthetic only): same MAPE from the TRUE onset | <= 15.00 | 17.44 % | **FAIL** | v3b (deployed) | [SYNTHETIC] synth_v3 old test runs (2nd look) |
| S7-alt | ALTERNATIVE (not the spec metric): percent-of-life error | <= 15.00 | 5.85 pts | **PASS** | v3b (deployed) | [SYNTHETIC] synth_v3 old test runs (2nd look) |
| IS3a | macro-F1 over {healthy, OD, ID, BD, CF} | >= 0.85 | 0.9613  | **PASS** | v3b (deployed) | [SYNTHETIC] synth_v3 old test runs (2nd look) |
| IS3b | health-stage error, literal max over all scored windows | <= 1 | 1 stages | **PASS** | v3b (deployed) | [SYNTHETIC] synth_v3 old test runs (2nd look) |
| IS3c | every injected fault caught by stage 3 (bearings) | == 40 | 40 /40 | **PASS** | v3b (deployed) | [SYNTHETIC] synth_v3 old test runs (2nd look) |
| S7 / ICS1 | RUL MAPE, absolute hours (spec metric, DESIGN.md s7 pre-registered window) | <= 15.00 | 15.53 % | **FAIL** | v3 GBM (history, superseded) | [SYNTHETIC] synth_v3 test runs |
| S7-strict | STRICTER variant (synthetic only): same MAPE from the TRUE onset | <= 15.00 | 18.18 % | **FAIL** | v3 GBM (history, superseded) | [SYNTHETIC] synth_v3 test runs |
| S7-alt | ALTERNATIVE (not the spec metric): percent-of-life error | <= 15.00 | 6.18 pts | **PASS** | v3 GBM (history, superseded) | [SYNTHETIC] synth_v3 test runs |
| IS3a | macro-F1 over {healthy, OD, ID, BD, CF} | >= 0.85 | 0.9613  | **PASS** | v3 GBM (history, superseded) | [SYNTHETIC] synth_v3 test runs |
| IS3b | health-stage error, literal max over all scored windows | <= 1 | 2 stages | **FAIL** | v3 GBM (history, superseded) | [SYNTHETIC] synth_v3 test runs |
| IS3c | every injected fault caught by stage 3 (bearings) | == 40 | 40 /40 | **PASS** | v3 GBM (history, superseded) | [SYNTHETIC] synth_v3 test runs |
| S7 / ICS1 | RUL MAPE, absolute hours (spec metric, DESIGN.md s7 pre-registered window) | <= 15.00 | 46.94 % | **FAIL** | TFT + N-HiTS (synth_v3) | [SYNTHETIC] synth_v3 test runs |
| S7-strict | STRICTER variant (synthetic only): same MAPE from the TRUE onset | <= 15.00 | 60.34 % | **FAIL** | TFT + N-HiTS (synth_v3) | [SYNTHETIC] synth_v3 test runs |
| S7-alt | ALTERNATIVE (not the spec metric): percent-of-life error | <= 15.00 | 20.20 pts | **FAIL** | TFT + N-HiTS (synth_v3) | [SYNTHETIC] synth_v3 test runs |
| IS3a | macro-F1 over {healthy, OD, ID, BD, CF} | >= 0.85 | 0.9241  | **PASS** | TFT + N-HiTS (synth_v3) | [SYNTHETIC] synth_v3 test runs |
| IS3b | health-stage error, literal max over all scored windows | <= 1 | 3 stages | **FAIL** | TFT + N-HiTS (synth_v3) | [SYNTHETIC] synth_v3 test runs |
| IS3c | every injected fault caught by stage 3 (bearings) | == 40 | 40 /40 | **PASS** | TFT + N-HiTS (synth_v3) | [SYNTHETIC] synth_v3 test runs |
| S8 / ICS2 | classification latency per window, p95 (1 thread, batch 1) | < 200.00 | 0.04022 ms | **PASS** | v3b classifier ONNX (deployed) | [MEASURED] live on this host (synthetic inputs) |
| S8 / ICS2 | classification latency per window, p95 (1 thread, batch 1) | < 200.00 | 0.04041 ms | **PASS** | v3 GBM classifier ONNX | [MEASURED] live on this host (synthetic inputs) |
| S8 / ICS2 | classification latency per window, p95 (1 thread, batch 1) | < 200.00 | 1.54 ms | **PASS** | TFT ONNX (synth_v3) | [MEASURED] live on this host (synthetic inputs) |
| IS1 (ICS leg) | ICS host leg per bearing-window, p95 | < 500.00 | 0.549 ms | **PASS (leg only)** | v3b engine step (features+cls+RUL+post-process, deployed) | [MEASURED] live on this host |
| IS1 (ICS leg) | ICS host leg per bearing-window, p95 | < 500.00 | 0.478 ms | **PASS (leg only)** | v3 engine step (features+cls+RUL) | [MEASURED] live on this host |
| IS1 (ICS leg) | ICS host leg per bearing-window, p95 | < 500.00 | 2.11 ms | **PASS (leg only)** | TFT+N-HiTS engine step | [MEASURED] live on this host |

## Metric definitions

```
UP2 spec metrics (pure functions over prediction frames). Definitions are stated in every report.

S7 / ICS1 (spec metric, absolute hours) = the DESIGN.md section 7 PRE-REGISTERED definition (2026-10-04, also
  used for the PPR v2 public-data number): degradation window = [t_onset, T_fail - 0.1 (T_fail - t_onset)], t_onset =
  the CAUSAL detected onset (labels.detect_onset on the HI: the first predicting time), and
    MAPE = mean over test run-to-failure bearings of [mean over that bearing's degradation-window windows of
           |RUL_pred_h - RUL_true_h| / RUL_true_h] * 100      (bearing-averaged)
  Alternatives, reported alongside, never substituted:
    STRICTER, synthetic-only: same formula with the generator's TRUE onset (includes the first ~15 % of the
      degradation interval where the defect is not yet detectable, so the life prior dominates)
    percent-of-life error = mean |RUL_pred_h - RUL_true_h| / life_h * 100 (points), true-onset window
    MAPE over the full detected degradation interval (no 10 % tail exclusion)
  Disclosure: the first v3 code used the true-onset variant as primary; after the validation run it was set back to
  the pre-registered section 7 definition (before any test score), and both are reported.
IS3a macro-F1 over {healthy, outer_race, inner_race, ball, cage}, every scored window of every test bearing.
IS3b stage error = |stage_pred - stage_true| over every scored window of the test run-to-failure bearings
     (stage_true = generator truth); literal max reported, plus fraction within +/-1.
IS3c caught by stage 3: first window where the predicted class equals the bearing's fault for 3
     consecutive windows; caught_by_stage3 = true stage at that window <= 3.
```

## Test sets (v3b)

v3b (DEPLOYED) = v3 classifier unchanged + v3b RUL/z heads + causal post-process, all chosen on validation runs only. `test2` = synth_v3_test2, 100 FRESH runs (new seed, same generator), registered in splits.json before any v3b fit and predicted exactly once (up2_v3b_gbm_20261024T114647Z.index.json); this command only re-scores those saved predictions. `test` = the 50 synth_v3 test runs: already scored once for v3, so the v3b number on it is a SECOND LOOK (disclosed); test2 is the primary verdict.

## Test detail: DEPLOYED v3b on FRESH synth_v3_test2 (100 runs, first and only look) -- primary verdict

Per-class F1: healthy 0.984, outer_race 0.963, inner_race 0.958, ball 0.956, cage 0.932; accuracy 0.976; windows 73476 on 200 bearings

Confusion (rows true, cols pred; order healthy, outer_race, inner_race, ball, cage):

```
  53754      79     129     159     196
    177    3786       7       0       0
    247      24    4609       0       0
    317       0       0    5198       0
    438       0       0       0    4356
```

Stage error histogram {'0': 17208, '1': 10747} (n=27955); within +/-1 1.0000; MAE 0.384; windows with error >= 2: 0 on 0 bearings
Caught by stage 3: 80/80; caught-at-stage histogram {'1': 1, '2': 79}; per class {'ball': '20/20', 'cage': '20/20', 'inner_race': '20/20', 'outer_race': '20/20'}; never caught 0
RUL: S7 12.64 % over 80 bearings / 17216 windows; per-bearing median 11.19, p90 19.47, max 26.43, share of bearings <= 15 %: 0.75; RMSE 8.54 h; full-interval MAPE 14.36 %; true-onset (stricter) MAPE 14.72 %; per rpm {'1750': 12.403106348698719, '3600': 12.884649641377456}; per class {'ball': 12.086842834804267, 'cage': 11.563432480741639, 'inner_race': 12.827122641134746, 'outer_race': 14.098114023471695}

RUL error vs true elapsed fraction of the degradation interval:

| u | MAPE % | median APE % | bias % | n |
|---|---|---|---|---|
| 0.0-0.1 | 25.39 | 20.23 | -3.66 | 1943 |
| 0.1-0.2 | 18.26 | 15.97 | -1.06 | 1903 |
| 0.2-0.3 | 12.53 | 10.69 | -4.13 | 1919 |
| 0.3-0.4 | 10.57 | 9.89 | -3.80 | 1899 |
| 0.4-0.5 | 12.06 | 11.06 | -3.12 | 1898 |
| 0.5-0.6 | 11.18 | 9.69 | -3.63 | 1933 |
| 0.6-0.7 | 11.44 | 10.13 | -3.91 | 1905 |
| 0.7-0.8 | 15.42 | 14.25 | -2.01 | 1901 |
| 0.8-0.9 | 15.67 | 13.77 | +2.89 | 1909 |

## Test detail: DEPLOYED v3b on the old synth_v3 test (50 runs, SECOND look, disclosed)

Per-class F1: healthy 0.985, outer_race 0.973, inner_race 0.964, ball 0.954, cage 0.931; accuracy 0.977; windows 39892 on 100 bearings

Confusion (rows true, cols pred; order healthy, outer_race, inner_race, ball, cage):

```
  29519      38      29      87     124
    102    2513       1       0       0
    142       1    2298       0       0
    111       0       0    2057       0
    263       0       0       0    2607
```

Stage error histogram {'0': 8975, '1': 5813} (n=14788); within +/-1 1.0000; MAE 0.393; windows with error >= 2: 0 on 0 bearings
Caught by stage 3: 40/40; caught-at-stage histogram {'2': 40}; per class {'ball': '10/10', 'cage': '10/10', 'inner_race': '10/10', 'outer_race': '10/10'}; never caught 0
RUL: S7 14.73 % over 40 bearings / 9073 windows; per-bearing median 11.88, p90 22.26, max 49.62, share of bearings <= 15 %: 0.72; RMSE 8.52 h; full-interval MAPE 17.27 %; true-onset (stricter) MAPE 17.44 %; per rpm {'1750': 12.162501872162517, '3600': 18.57211042682853}; per class {'ball': 17.891346201786767, 'cage': 14.185455361170767, 'inner_race': 14.49790676452642, 'outer_race': 12.330672848631725}

RUL error vs true elapsed fraction of the degradation interval:

| u | MAPE % | median APE % | bias % | n |
|---|---|---|---|---|
| 0.0-0.1 | 28.23 | 23.40 | -1.37 | 1022 |
| 0.1-0.2 | 18.38 | 12.71 | +0.43 | 1005 |
| 0.2-0.3 | 11.53 | 9.46 | -2.38 | 1009 |
| 0.3-0.4 | 11.57 | 10.07 | -3.03 | 1005 |
| 0.4-0.5 | 10.76 | 10.09 | -3.82 | 995 |
| 0.5-0.6 | 10.91 | 9.28 | -3.38 | 1018 |
| 0.6-0.7 | 12.96 | 11.98 | -2.04 | 1008 |
| 0.7-0.8 | 17.25 | 15.40 | -3.04 | 1000 |
| 0.8-0.9 | 19.07 | 15.79 | +1.50 | 1008 |

## Test detail: DEPLOYED v3 heads: xgb classifier + lgbm RUL/lgbm stage (gradient-boosted trees)

Per-class F1: healthy 0.985, outer_race 0.973, inner_race 0.964, ball 0.954, cage 0.931; accuracy 0.977; windows 39892 on 100 bearings

Confusion (rows true, cols pred; order healthy, outer_race, inner_race, ball, cage):

```
  29519      38      29      87     124
    102    2513       1       0       0
    142       1    2298       0       0
    111       0       0    2057       0
    263       0       0       0    2607
```

Stage error histogram {'0': 12588, '1': 2182, '2': 18} (n=14788); within +/-1 0.9988; MAE 0.150; windows with error >= 2: 18 on 2 bearings
Caught by stage 3: 40/40; caught-at-stage histogram {'2': 40}; per class {'ball': '10/10', 'cage': '10/10', 'inner_race': '10/10', 'outer_race': '10/10'}; never caught 0
RUL: S7 15.53 % over 40 bearings / 9073 windows; per-bearing median 11.94, p90 24.23, max 52.57, share of bearings <= 15 %: 0.65; RMSE 9.35 h; full-interval MAPE 17.95 %; true-onset (stricter) MAPE 18.18 %; per rpm {'1750': 13.75161172090471, '3600': 18.18993013824578}; per class {'ball': 15.804550288952623, 'cage': 16.299557824770073, 'inner_race': 15.368053635289021, 'outer_race': 14.635594602352839}

RUL error vs true elapsed fraction of the degradation interval:

| u | MAPE % | median APE % | bias % | n |
|---|---|---|---|---|
| 0.0-0.1 | 28.84 | 23.78 | -5.36 | 1022 |
| 0.1-0.2 | 19.57 | 14.69 | -2.46 | 1005 |
| 0.2-0.3 | 12.06 | 8.94 | -2.13 | 1009 |
| 0.3-0.4 | 12.14 | 10.81 | -1.93 | 1005 |
| 0.4-0.5 | 11.92 | 10.50 | -1.91 | 995 |
| 0.5-0.6 | 11.62 | 9.53 | -1.23 | 1018 |
| 0.6-0.7 | 13.94 | 12.56 | -0.05 | 1008 |
| 0.7-0.8 | 18.01 | 15.94 | -2.12 | 1000 |
| 0.8-0.9 | 19.63 | 16.31 | +4.29 | 1008 |

## Test detail: TFT (class) + N-HiTS (HI forecast -> RUL, rul.py) -- spec-named models, trained on the same runs

Per-class F1: healthy 0.975, outer_race 0.945, inner_race 0.907, ball 0.893, cage 0.900; accuracy 0.959; windows 39892 on 100 bearings

Confusion (rows true, cols pred; order healthy, outer_race, inner_race, ball, cage):

```
  28949      91     151     293     313
     94    2510       3       0       9
    153      89    2158      30      11
    147       0       0    2014       7
    232       5       4       5    2624
```

Stage error histogram {'0': 9024, '1': 5302, '2': 458, '3': 4} (n=14788); within +/-1 0.9688; MAE 0.421; windows with error >= 2: 462 on 31 bearings
Caught by stage 3: 40/40; caught-at-stage histogram {'1': 3, '2': 35, '3': 2}; per class {'ball': '10/10', 'cage': '10/10', 'inner_race': '10/10', 'outer_race': '10/10'}; never caught 0
RUL: S7 46.94 % over 40 bearings / 9073 windows; per-bearing median 45.71, p90 56.67, max 63.38, share of bearings <= 15 %: 0.00; RMSE 26.95 h; full-interval MAPE 64.43 %; true-onset (stricter) MAPE 60.34 %; per rpm {'1750': 48.16177334391015, '3600': 45.09531947674816}; per class {'ball': 49.51660410262322, 'cage': 46.853132515956275, 'inner_race': 47.70141910688077, 'outer_race': 43.669611462721164}

RUL error vs true elapsed fraction of the degradation interval:

| u | MAPE % | median APE % | bias % | n |
|---|---|---|---|---|
| 0.0-0.1 | 119.77 | 56.64 | +79.13 | 1022 |
| 0.1-0.2 | 53.36 | 53.08 | -35.80 | 1005 |
| 0.2-0.3 | 47.86 | 50.12 | -45.27 | 1009 |
| 0.3-0.4 | 39.29 | 40.55 | -37.17 | 1005 |
| 0.4-0.5 | 29.01 | 29.17 | -24.78 | 995 |
| 0.5-0.6 | 20.41 | 16.90 | -4.80 | 1018 |
| 0.6-0.7 | 27.90 | 18.51 | +20.93 | 1008 |
| 0.7-0.8 | 55.29 | 44.90 | +54.57 | 1000 |
| 0.8-0.9 | 95.50 | 89.63 | +95.36 | 1008 |

## Robustness (fresh runs never used for fitting or selection; informational, no verdict)

| set | knobs changed | model | macro-F1 | stage max | within+/-1 | caught by st.3 | S7 MAPE % | %-of-life pts |
|---|---|---|---|---|---|---|---|---|
| synth_v3_noise15 | {'noise_scale': 1.5} | gbm | 0.803 | 2 | 0.9985 | 48/48 | 14.34 | 7.37 |
| synth_v3_noise15 | {'noise_scale': 1.5} | nn | 0.773 | 3 | 0.9045 | 48/48 | 49.33 | 23.23 |
| synth_v3_noise15 | {'noise_scale': 1.5} | v3b | 0.803 | 1 | 1.0000 | 48/48 | 14.26 | 7.02 |
| synth_v3_rpm3000 | {'rpm_modes': (3000.0,)} | gbm | 0.958 | 2 | 0.9994 | 48/48 | 13.10 | 5.72 |
| synth_v3_rpm3000 | {'rpm_modes': (3000.0,)} | nn | 0.920 | 2 | 0.9668 | 48/48 | 48.09 | 20.57 |
| synth_v3_rpm3000 | {'rpm_modes': (3000.0,)} | v3b | 0.958 | 1 | 1.0000 | 48/48 | 12.49 | 5.77 |
| synth_v3_hard | {'signature': 0.75, 'life_sigma': 0.45, 'transmission': (0.08, 0.16), 'shape_a': (0.25, 0.35), 'shape_p': (2.0, 3.0), 'eol_sev': (0.75, 1.25)} | gbm | 0.948 | 2 | 0.9988 | 48/48 | 24.15 | 9.65 |
| synth_v3_hard | {'signature': 0.75, 'life_sigma': 0.45, 'transmission': (0.08, 0.16), 'shape_a': (0.25, 0.35), 'shape_p': (2.0, 3.0), 'eol_sev': (0.75, 1.25)} | nn | 0.898 | 3 | 0.9588 | 48/48 | 48.79 | 22.18 |
| synth_v3_hard | {'signature': 0.75, 'life_sigma': 0.45, 'transmission': (0.08, 0.16), 'shape_a': (0.25, 0.35), 'shape_p': (2.0, 3.0), 'eol_sev': (0.75, 1.25)} | v3b | 0.948 | 1 | 1.0000 | 48/48 | 21.06 | 8.91 |

## Latency (live, this host, ONNX Runtime, 1 thread, batch 1)

```
{
 "v3_cls_onnx": {
  "p50_ms": 0.03480000304989517,
  "p95_ms": 0.040409995199297555,
  "max_ms": 0.05860000237589702,
  "n": 300,
  "threads": 1,
  "batch": 1
 },
 "v3_rul_onnx": {
  "p50_ms": 0.08494999929098412,
  "p95_ms": 0.09680500224931166,
  "max_ms": 0.14340000052470714,
  "n": 300,
  "threads": 1,
  "batch": 1
 },
 "v3_engine_step": {
  "p50_ms": 0.447,
  "p95_ms": 0.478,
  "max_ms": 0.591,
  "mean_ms": 0.4493194444444445,
  "n": 216,
  "note": "per bearing-window, features+TFT+N-HiTS+RUL via ONNX Runtime"
 },
 "v3b_cls_onnx": {
  "p50_ms": 0.034150001738453284,
  "p95_ms": 0.040220000300905674,
  "max_ms": 0.06240000220714137,
  "n": 300,
  "threads": 1,
  "batch": 1
 },
 "v3b_rul_onnx": {
  "p50_ms": 0.15350000103353523,
  "p95_ms": 0.1646199951210292,
  "max_ms": 0.19109999993816018,
  "n": 300,
  "threads": 1,
  "batch": 1
 },
 "v3b_engine_step": {
  "p50_ms": 0.508,
  "p95_ms": 0.549,
  "max_ms": 0.896,
  "mean_ms": 0.5159675925925926,
  "n": 216,
  "note": "per bearing-window, features+TFT+N-HiTS+RUL via ONNX Runtime"
 },
 "v3_nn_tft_onnx": {
  "p50_ms": 1.5000000021245796,
  "p95_ms": 1.5409449970320566,
  "max_ms": 1.975800005311612,
  "n": 300,
  "threads": 1,
  "batch": 1
 },
 "v3_nn_engine_step": {
  "p50_ms": 2.035,
  "p95_ms": 2.1058,
  "max_ms": 2.25,
  "mean_ms": 2.0422488479262673,
  "n": 217,
  "note": "per bearing-window, features+TFT+N-HiTS+RUL via ONNX Runtime"
 },
 "host": "Intel64 Family 6 Model 183 Stepping 1, GenuineIntel / Windows 10",
 "unit": "synth_v3:run0171:B1"
}
```

## Previous public-data results (PPR v2) -- [MEASURED on XJTU-SY / IMS / MaFaulDa], stored report

```
{
 "source": "spec_check_20261005T012112Z_real_v2.json",
 "provenance": "[MEASURED on XJTU-SY / IMS / MaFaulDa public bearing data]",
 "verdicts": [
  {
   "spec": "S7",
   "requirement": "RUL MAPE on held-out degradation window (N-HiTS)",
   "op": "<=",
   "target": 15.0,
   "measured": 281.8054261284695,
   "unit": "%",
   "status": "FAIL"
  },
  {
   "spec": "S8",
   "requirement": "TFT classification latency per window, p95 single-window",
   "op": "<",
   "target": 200.0,
   "measured": 11.142779999954655,
   "unit": "ms",
   "status": "PASS"
  },
  {
   "spec": "IS3a",
   "requirement": "macro-F1 over the testable classes (train AND test support; primary)",
   "op": ">=",
   "target": 0.85,
   "measured": 0.5811592376693763,
   "unit": "",
   "status": "FAIL"
  },
  {
   "spec": "IS3a-5",
   "requirement": "macro-F1 over all 5 classes (a class with no output channel scores F1 0)",
   "op": ">=",
   "target": 0.85,
   "measured": 0.5811592376693763,
   "unit": "",
   "status": "FAIL"
  },
  {
   "spec": "IS3b",
   "requirement": "stage error <= 1, literal reading: MAX abs stage error over test windows",
   "op": "<=",
   "target": 1,
   "measured": 4.0,
   "unit": "",
   "status": "FAIL"
  },
  {
   "spec": "IS3c",
   "requirement": "run-to-failure faults caught (3 consecutive correct) by stage 3",
   "op": ">=",
   "target": 1.0,
   "measured": 0.25,
   "unit": "",
   "status": "FAIL"
  },
  {
   "spec": "IS1 (ICS leg)",
   "requirement": "features + TFT + N-HiTS + RUL per window, p95",
   "op": "<",
   "target": 500.0,
   "measured": 14.4168,
   "unit": "ms",
   "status": "PASS"
  }
 ]
}
```

## Generator difficulty knobs

```
{
 "noise_scale": 1.0,
 "life_ref_h": 50.0,
 "life_sigma": 0.35,
 "life_clip_windows": [
  80,
  720
 ],
 "healthy_windows": [
  60,
  200
 ],
 "healthy_run_windows": [
  250,
  700
 ],
 "shape_a": [
  0.28,
  0.32
 ],
 "shape_p": [
  2.3,
  2.7
 ],
 "eol_sev": [
  0.85,
  1.15
 ],
 "transmission": [
  0.04,
  0.1
 ],
 "leak": 0.12,
 "signature": 1.0,
 "drift_sigma": 0.04,
 "transient_rate": 0.004,
 "rpm_modes": [
  1750.0,
  3600.0
 ],
 "rpm_jitter": 0.002
}
```
