amussab/Digital-Twin-Senior-Proj/AI-engine/reports/up2_residual_20261024T072601Z.md

# IS2 physics-AI RUL residual  (2026-10-24T07:26:01+00:00)

**[SIMULATION] + [SYNTHETIC].**  Not a measurement on the rig.  Spec text (quoted): "Physics-AI residual: max relative error between the FE-identified physics RUL and the AI RUL <=5%, health stage 1->3"

## Verdict

| Reading | Value | Target | Verdict |
|---|---|---|---|
| IS2 literal: max per-window residual, stages 1-3, nominal, tuned filter | 143.2 % | <= 5 % | **FAIL** |
| p95 residual (alternative reading) | 79.0 % | <= 5 % | FAIL |
| median / mean residual | 49.6 % / 48.4 % | - | - |
| share of windows with residual <= 5 % | 1.4 % | - | - |
| physics coverage (stage 1-3 windows with a physics RUL) | 5.8 % | - | - |

Metric: `residual = |RUL_physics - RUL_AI| / RUL_AI` per window, hours, faulted bearing of each run-to-failure `test` run, TRUE stage in {1,2,3}, windows where both RULs exist (n = 508 windows, 24 runs).  AI predictions: `up2_v3_gbm_20261024T025531Z.index.json` ([SYNTHETIC] synth_v3, predictions tag 20261024T025531Z).

### Limitations to state alongside the number

1. **Circularity.** The stiffness trajectory K(t) fed to the FE twin is derived from the same synthetic damage curve that drives the generator's features and RUL label.  Agreement here is agreement of two estimators of one latent variable, not evidence about real bearings.
2. **Floor set by the AI.** The AI RUL has its own error vs truth, so even a perfect physics RUL gives a residual of 15.0 % median / 130.7 % max (row 'perfect physics' below).  A <= 5 % IS2 would need the AI to be within ~5 % of truth, which S7 (MAPE 15 %) does not require.
3. **Stage 1 has no trend.** Before onset K is constant; the trend-based physics RUL is (correctly) silent there.  Coverage by stage is in the JSON.
4. **3600 rpm.** K is weakly observable above the bearing mode (twin README); the identification gate drops most such windows, so 3600 rpm runs contribute little or no physics RUL (coverage by rpm below).
5. Identification and FE model are the twin's initial, replaceable version with ASSUMED geometry (`twin/params.py`).

## Sweep (test runs scored once per row; tuned filter unless stated)

| Setting | What changed | coverage | n | max | p95 | median | mean | <=5 % share | phys-vs-truth median |
|---|---|---|---|---|---|---|---|---|---|
| nominal | documented sensor model +/-5 % amp, +/-0.05 rad; exact FE plant; K drop linear in damage | 5.8 % | 508 | 143.2 % | 79.0 % | 49.6 % | 48.4 % | 1.4 % | 55.3 % |
| noise10 | identification input noise doubled (+/-10 % amp, +/-0.10 rad) | 4.8 % | 415 | 98.2 % | 91.6 % | 78.7 % | 76.5 % | 0.0 % | 80.8 % |
| noise15 | identification input noise tripled (+/-15 % amp, +/-0.15 rad) | 4.3 % | 377 | 99.2 % | 96.3 % | 88.7 % | 86.7 % | 0.0 % | 89.9 % |
| curve_m0.7 | stiffness curve mismatch: K drop = 0.25*d^0.7 (earlier, faster drop) | 7.6 % | 665 | 138.5 % | 80.2 % | 50.2 % | 48.7 % | 1.4 % | 53.0 % |
| curve_m1.5 | stiffness curve mismatch: K drop = 0.25*d^1.5 (later, steeper drop) | 4.6 % | 405 | 195.7 % | 77.8 % | 50.7 % | 49.0 % | 3.0 % | 55.2 % |
| plant_mismatch | plant shaft E +5 % and disk mass +5 % vs the twin's assumed values (FE model-form error) | 5.9 % | 519 | 154.5 % | 79.2 % | 49.7 % | 48.4 % | 1.7 % | 55.5 % |
| hard_combo | noise10 + curve_m1.5 + plant_mismatch together | 4.2 % | 369 | 98.2 % | 91.2 % | 79.5 % | 77.0 % | 0.0 % | 81.6 % |
| nominal, STOCK filter | twin as committed (fit 200, no EMA, gate 0.15) | 14.7 % | 1280 | 4124.4 % | 1159.0 % | 485.9 % | 546.9 % | 0.7 % | 445.8 % |
| perfect physics (RUL_physics := truth) | lower bound of the residual given this AI | 100.0 % | 508 | 130.7 % | 78.5 % | 15.0 % | 24.0 % | 19.3 % | 0 |

## Nominal, by stage and rpm (residual vs AI)

| group | n | max | p95 | median | mean | <=5 % share |
|---|---|---|---|---|---|---|
| stage 1 | 180 | 95.3 % | 88.9 % | 61.7 % | 56.5 % | 0.0 % |
| stage 2 | 105 | 79.8 % | 77.7 % | 49.5 % | 48.2 % | 0.0 % |
| stage 3 | 223 | 143.2 % | 75.9 % | 42.9 % | 42.0 % | 3.1 % |
| 1750 rpm | 508 | 143.2 % | 79.0 % | 49.6 % | 48.4 % | 1.4 % |

Coverage by rpm: 1750 rpm 8.2 %, 3600 rpm 0.0 %.  Coverage by stage: stage 1 3.8 %, stage 2 5.2 %, stage 3 11.1 %.

AI vs truth on the same windows: median 14.0 %, mean 19.2 %; physics vs truth: median 55.3 %, mean 52.7 %.

## Filter tuned on VALIDATION runs only (objective: physics vs TRUTH RUL, stages 2-3)

Chosen: fit_points=32, ema_alpha=1.0, max_rel_std=0.15.  Stock: fit_points=200, ema_alpha=1.0, max_rel_std=0.15.  Best 8 of 30 grid points:

| fit_points | ema_alpha | gate | coverage(st2-3) | mean APE vs truth | median APE vs truth |
|---|---|---|---|---|---|
| 32 | 1.0 | 0.15 | 4.4 % | 47.9 % | 53.6 % |
| 32 | 0.3 | 0.15 | 4.4 % | 53.7 % | 55.5 % |
| 32 | 1.0 | 0.3 | 7.1 % | 59.5 % | 66.7 % |
| 32 | 0.3 | 0.3 | 7.1 % | 65.0 % | 71.1 % |
| 32 | 0.1 | 0.15 | 4.4 % | 66.6 % | 69.6 % |
| 32 | 0.1 | 0.3 | 7.1 % | 74.3 % | 77.5 % |
| 64 | 0.3 | 0.3 | 10.9 % | 77.7 % | 60.5 % |
| 64 | 0.1 | 0.3 | 10.9 % | 77.9 % | 57.1 % |

## C# port impact

Needed in `src/DigitalTwin.Twin` (identification and `fit_rul` unchanged): `RotorParams.rul_fit_points` 200 -> 32 (one constant).  `twin_golden.json` stays valid for K identification; the RUL golden must be regenerated if constants change.

## Provenance

- command: `python -m aiengine.up2_residual`; commit 1e85b84 (aiengine dirty: True); seed 20261004
- data: [SYNTHETIC] aiengine/synth_v3 generator (physics-informed, not measured), table_hash 66031b7aa779ee8c; split `test`: 40 faulted-bearing units
- predictions: `up2_v3_gbm_20261024T025531Z.index.json` ([SYNTHETIC] synth_v3, predictions tag 20261024T025531Z); test predictions were made once by the ML agent, this script only reads them
- all numbers: [SIMULATION] physics twin driven by a [SYNTHETIC] damage-derived stiffness trajectory
