amussab/Digital-Twin-Senior-Proj/AI-engine/reports/up2_spec_check_20261024T074451Z.md

# UP2 spec check (contracts v3b deployed, v3 history) -- [SYNTHETIC] synth_v3 data

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

- generated: 2026-10-24T07:44:38+00:00  commit `1e85b84` (dirty=True)  seed 20261004
- command: `python -m aiengine.up2_train `
- data: 240 runs, table hash `66031b7aa779ee8c`, split by run (splits.json section synth_v3): {'test': 50, 'train': 635, 'val': 35}
- predictions re-scored from: up2_v3_gbm_20261024T025531Z.index.json (deployed GBM heads), up2_v3_nn_20261024T074314Z.index.json (TFT + N-HiTS)
- scored windows: window_index >= 24 (every head warm: classifier needs its encoder history)

## Spec table

| spec | what | target | measured | verdict | model | provenance |
|---|---|---|---|---|---|---|
| S7 / ICS1 | RUL MAPE, absolute hours (spec metric, DESIGN.md s7 pre-registered window) | <= 15.00 | 15.53 % | **FAIL** | v3 GBM (history, superseded) | [SYNTHETIC] synth_v3 test runs |
| S7-strict | STRICTER variant (synthetic only): same MAPE from the TRUE onset | <= 15.00 | 18.18 % | **FAIL** | v3 GBM (history, superseded) | [SYNTHETIC] synth_v3 test runs |
| S7-alt | ALTERNATIVE (not the spec metric): percent-of-life error | <= 15.00 | 6.18 pts | **PASS** | v3 GBM (history, superseded) | [SYNTHETIC] synth_v3 test runs |
| IS3a | macro-F1 over {healthy, OD, ID, BD, CF} | >= 0.85 | 0.9613  | **PASS** | v3 GBM (history, superseded) | [SYNTHETIC] synth_v3 test runs |
| IS3b | health-stage error, literal max over all scored windows | <= 1 | 2 stages | **FAIL** | v3 GBM (history, superseded) | [SYNTHETIC] synth_v3 test runs |
| IS3c | every injected fault caught by stage 3 (bearings) | == 40 | 40 /40 | **PASS** | v3 GBM (history, superseded) | [SYNTHETIC] synth_v3 test runs |
| S7 / ICS1 | RUL MAPE, absolute hours (spec metric, DESIGN.md s7 pre-registered window) | <= 15.00 | 46.94 % | **FAIL** | TFT + N-HiTS (synth_v3) | [SYNTHETIC] synth_v3 test runs |
| S7-strict | STRICTER variant (synthetic only): same MAPE from the TRUE onset | <= 15.00 | 60.34 % | **FAIL** | TFT + N-HiTS (synth_v3) | [SYNTHETIC] synth_v3 test runs |
| S7-alt | ALTERNATIVE (not the spec metric): percent-of-life error | <= 15.00 | 20.20 pts | **FAIL** | TFT + N-HiTS (synth_v3) | [SYNTHETIC] synth_v3 test runs |
| IS3a | macro-F1 over {healthy, OD, ID, BD, CF} | >= 0.85 | 0.9241  | **PASS** | TFT + N-HiTS (synth_v3) | [SYNTHETIC] synth_v3 test runs |
| IS3b | health-stage error, literal max over all scored windows | <= 1 | 3 stages | **FAIL** | TFT + N-HiTS (synth_v3) | [SYNTHETIC] synth_v3 test runs |
| IS3c | every injected fault caught by stage 3 (bearings) | == 40 | 40 /40 | **PASS** | TFT + N-HiTS (synth_v3) | [SYNTHETIC] synth_v3 test runs |
| S8 / ICS2 | classification latency per window, p95 (1 thread, batch 1) | < 200.00 | 0.03902 ms | **PASS** | v3 GBM classifier ONNX | [MEASURED] live on this host (synthetic inputs) |
| S8 / ICS2 | classification latency per window, p95 (1 thread, batch 1) | < 200.00 | 1.58 ms | **PASS** | TFT ONNX (synth_v3) | [MEASURED] live on this host (synthetic inputs) |
| IS1 (ICS leg) | ICS host leg per bearing-window, p95 | < 500.00 | 0.466 ms | **PASS (leg only)** | v3 engine step (features+cls+RUL) | [MEASURED] live on this host |
| IS1 (ICS leg) | ICS host leg per bearing-window, p95 | < 500.00 | 2.05 ms | **PASS (leg only)** | TFT+N-HiTS engine step | [MEASURED] live on this host |

## Metric definitions

```
UP2 spec metrics (pure functions over prediction frames). Definitions are stated in every report.

S7 / ICS1 (spec metric, absolute hours) = the DESIGN.md section 7 PRE-REGISTERED definition (2026-10-04, also
  used for the PPR v2 public-data number): degradation window = [t_onset, T_fail - 0.1 (T_fail - t_onset)], t_onset =
  the CAUSAL detected onset (labels.detect_onset on the HI: the first predicting time), and
    MAPE = mean over test run-to-failure bearings of [mean over that bearing's degradation-window windows of
           |RUL_pred_h - RUL_true_h| / RUL_true_h] * 100      (bearing-averaged)
  Alternatives, reported alongside, never substituted:
    STRICTER, synthetic-only: same formula with the generator's TRUE onset (includes the first ~15 % of the
      degradation interval where the defect is not yet detectable, so the life prior dominates)
    percent-of-life error = mean |RUL_pred_h - RUL_true_h| / life_h * 100 (points), true-onset window
    MAPE over the full detected degradation interval (no 10 % tail exclusion)
  Disclosure: the first v3 code used the true-onset variant as primary; after the validation run it was set back to
  the pre-registered section 7 definition (before any test score), and both are reported.
IS3a macro-F1 over {healthy, outer_race, inner_race, ball, cage}, every scored window of every test bearing.
IS3b stage error = |stage_pred - stage_true| over every scored window of the test run-to-failure bearings
     (stage_true = generator truth); literal max reported, plus fraction within +/-1.
IS3c caught by stage 3: first window where the predicted class equals the bearing's fault for 3
     consecutive windows; caught_by_stage3 = true stage at that window <= 3.
```

## Test detail: DEPLOYED v3 heads: xgb classifier + lgbm RUL/lgbm stage (gradient-boosted trees)

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

Confusion (rows true, cols pred; order healthy, outer_race, inner_race, ball, cage):

```
  29519      38      29      87     124
    102    2513       1       0       0
    142       1    2298       0       0
    111       0       0    2057       0
    263       0       0       0    2607
```

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

RUL error vs true elapsed fraction of the degradation interval:

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

Confusion (rows true, cols pred; order healthy, outer_race, inner_race, ball, cage):

```
  28949      91     151     293     313
     94    2510       3       0       9
    153      89    2158      30      11
    147       0       0    2014       7
    232       5       4       5    2624
```

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

RUL error vs true elapsed fraction of the degradation interval:

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

## Robustness (fresh runs never used for fitting or selection; informational, no verdict)

| set | knobs changed | model | macro-F1 | stage max | within+/-1 | caught by st.3 | S7 MAPE % | %-of-life pts |
|---|---|---|---|---|---|---|---|---|
| synth_v3_noise15 | {'noise_scale': 1.5} | gbm | 0.803 | 2 | 0.9985 | 48/48 | 14.34 | 7.37 |
| synth_v3_noise15 | {'noise_scale': 1.5} | nn | 0.773 | 3 | 0.9045 | 48/48 | 49.33 | 23.23 |
| synth_v3_rpm3000 | {'rpm_modes': (3000.0,)} | gbm | 0.958 | 2 | 0.9994 | 48/48 | 13.10 | 5.72 |
| synth_v3_rpm3000 | {'rpm_modes': (3000.0,)} | nn | 0.920 | 2 | 0.9668 | 48/48 | 48.09 | 20.57 |
| synth_v3_hard | {'signature': 0.75, 'life_sigma': 0.45, 'transmission': (0.08, 0.16), 'shape_a': (0.25, 0.35), 'shape_p': (2.0, 3.0), 'eol_sev': (0.75, 1.25)} | gbm | 0.948 | 2 | 0.9988 | 48/48 | 24.15 | 9.65 |
| synth_v3_hard | {'signature': 0.75, 'life_sigma': 0.45, 'transmission': (0.08, 0.16), 'shape_a': (0.25, 0.35), 'shape_p': (2.0, 3.0), 'eol_sev': (0.75, 1.25)} | nn | 0.898 | 3 | 0.9588 | 48/48 | 48.79 | 22.18 |

## Latency (live, this host, ONNX Runtime, 1 thread, batch 1)

```
{
 "v3_cls_onnx": {
  "p50_ms": 0.033799999073380604,
  "p95_ms": 0.03902499884134159,
  "max_ms": 0.06470000153058209,
  "n": 300,
  "threads": 1,
  "batch": 1
 },
 "v3_rul_onnx": {
  "p50_ms": 0.08454999988316558,
  "p95_ms": 0.0989999973171507,
  "max_ms": 0.11819999781437218,
  "n": 300,
  "threads": 1,
  "batch": 1
 },
 "v3_engine_step": {
  "p50_ms": 0.438,
  "p95_ms": 0.466,
  "max_ms": 0.764,
  "mean_ms": 0.44196296296296295,
  "n": 216,
  "note": "per bearing-window, features+TFT+N-HiTS+RUL via ONNX Runtime"
 },
 "v3_nn_tft_onnx": {
  "p50_ms": 1.4866500005155103,
  "p95_ms": 1.578199997493357,
  "max_ms": 1.8409999975119717,
  "n": 300,
  "threads": 1,
  "batch": 1
 },
 "v3_nn_engine_step": {
  "p50_ms": 1.995,
  "p95_ms": 2.0496,
  "max_ms": 2.454,
  "mean_ms": 2.0051382488479264,
  "n": 217,
  "note": "per bearing-window, features+TFT+N-HiTS+RUL via ONNX Runtime"
 },
 "host": "Intel64 Family 6 Model 183 Stepping 1, GenuineIntel / Windows 10",
 "unit": "synth_v3:run0171:B1"
}
```

## Previous public-data results (PPR v2) -- [MEASURED on XJTU-SY / IMS / MaFaulDa], stored report

```
{
 "source": "spec_check_20261005T012112Z_real_v2.json",
 "provenance": "[MEASURED on XJTU-SY / IMS / MaFaulDa public bearing data]",
 "verdicts": [
  {
   "spec": "S7",
   "requirement": "RUL MAPE on held-out degradation window (N-HiTS)",
   "op": "<=",
   "target": 15.0,
   "measured": 281.8054261284695,
   "unit": "%",
   "status": "FAIL"
  },
  {
   "spec": "S8",
   "requirement": "TFT classification latency per window, p95 single-window",
   "op": "<",
   "target": 200.0,
   "measured": 11.142779999954655,
   "unit": "ms",
   "status": "PASS"
  },
  {
   "spec": "IS3a",
   "requirement": "macro-F1 over the testable classes (train AND test support; primary)",
   "op": ">=",
   "target": 0.85,
   "measured": 0.5811592376693763,
   "unit": "",
   "status": "FAIL"
  },
  {
   "spec": "IS3a-5",
   "requirement": "macro-F1 over all 5 classes (a class with no output channel scores F1 0)",
   "op": ">=",
   "target": 0.85,
   "measured": 0.5811592376693763,
   "unit": "",
   "status": "FAIL"
  },
  {
   "spec": "IS3b",
   "requirement": "stage error <= 1, literal reading: MAX abs stage error over test windows",
   "op": "<=",
   "target": 1,
   "measured": 4.0,
   "unit": "",
   "status": "FAIL"
  },
  {
   "spec": "IS3c",
   "requirement": "run-to-failure faults caught (3 consecutive correct) by stage 3",
   "op": ">=",
   "target": 1.0,
   "measured": 0.25,
   "unit": "",
   "status": "FAIL"
  },
  {
   "spec": "IS1 (ICS leg)",
   "requirement": "features + TFT + N-HiTS + RUL per window, p95",
   "op": "<",
   "target": 500.0,
   "measured": 14.4168,
   "unit": "ms",
   "status": "PASS"
  }
 ]
}
```

## Generator difficulty knobs

```
{
 "noise_scale": 1.0,
 "life_ref_h": 50.0,
 "life_sigma": 0.35,
 "life_clip_windows": [
  80,
  720
 ],
 "healthy_windows": [
  60,
  200
 ],
 "healthy_run_windows": [
  250,
  700
 ],
 "shape_a": [
  0.28,
  0.32
 ],
 "shape_p": [
  2.3,
  2.7
 ],
 "eol_sev": [
  0.85,
  1.15
 ],
 "transmission": [
  0.04,
  0.1
 ],
 "leak": 0.12,
 "signature": 1.0,
 "drift_sigma": 0.04,
 "transient_rate": 0.004,
 "rpm_modes": [
  1750.0,
  3600.0
 ],
 "rpm_jitter": 0.002
}
```
