amussab/Digital-Twin-Senior-Proj/AI-engine/reports/up2_spec_check_20261024T060741Z.md

# UP2 spec check (contract v3) -- [SYNTHETIC] synth_v3 data

**Provenance: every synth_v3 number below is [SYNTHETIC]: physics-informed generated data (aiengine/synth_v3), NOT a measurement of the team rig or of any public dataset.** The public-data (PPR v2) rows are [MEASURED on XJTU-SY / IMS / MaFaulDa], carried from their stored report.

- generated: 2026-10-24T06:06:22+00:00  commit `e8cff82` (dirty=True)  seed 20261004
- command: `python -m aiengine.up2_train `
- data: 240 runs, table hash `66031b7aa779ee8c`, split by run (splits.json section synth_v3): {'test': 50, 'train': 635, 'val': 35}
- predictions re-scored from: up2_v3_gbm_20261024T025531Z.index.json (deployed GBM heads), up2_v3_nn_20261024T055648Z.index.json (TFT + N-HiTS)
- scored windows: window_index >= 24 (every head warm: classifier needs its encoder history)

## Spec table

| spec | what | target | measured | verdict | model | provenance |
|---|---|---|---|---|---|---|
| S7 / ICS1 | RUL MAPE, absolute hours (spec metric, DESIGN.md s7 pre-registered window) | <= 15.00 | 15.53 % | **FAIL** | v3 GBM (deployed) | [SYNTHETIC] synth_v3 test runs |
| S7-strict | STRICTER variant (synthetic only): same MAPE from the TRUE onset | <= 15.00 | 18.18 % | **FAIL** | v3 GBM (deployed) | [SYNTHETIC] synth_v3 test runs |
| S7-alt | ALTERNATIVE (not the spec metric): percent-of-life error | <= 15.00 | 6.18 pts | **PASS** | v3 GBM (deployed) | [SYNTHETIC] synth_v3 test runs |
| IS3a | macro-F1 over {healthy, OD, ID, BD, CF} | >= 0.85 | 0.9613  | **PASS** | v3 GBM (deployed) | [SYNTHETIC] synth_v3 test runs |
| IS3b | health-stage error, literal max over all scored windows | <= 1 | 2 stages | **FAIL** | v3 GBM (deployed) | [SYNTHETIC] synth_v3 test runs |
| IS3c | every injected fault caught by stage 3 (bearings) | == 40 | 40 /40 | **PASS** | v3 GBM (deployed) | [SYNTHETIC] synth_v3 test runs |
| S7 / ICS1 | RUL MAPE, absolute hours (spec metric, DESIGN.md s7 pre-registered window) | <= 15.00 | 54.59 % | **FAIL** | TFT + N-HiTS (synth_v3) | [SYNTHETIC] synth_v3 test runs |
| S7-strict | STRICTER variant (synthetic only): same MAPE from the TRUE onset | <= 15.00 | 52.04 % | **FAIL** | TFT + N-HiTS (synth_v3) | [SYNTHETIC] synth_v3 test runs |
| S7-alt | ALTERNATIVE (not the spec metric): percent-of-life error | <= 15.00 | 17.56 pts | **FAIL** | TFT + N-HiTS (synth_v3) | [SYNTHETIC] synth_v3 test runs |
| IS3a | macro-F1 over {healthy, OD, ID, BD, CF} | >= 0.85 | 0.928  | **PASS** | TFT + N-HiTS (synth_v3) | [SYNTHETIC] synth_v3 test runs |
| IS3b | health-stage error, literal max over all scored windows | <= 1 | 4 stages | **FAIL** | TFT + N-HiTS (synth_v3) | [SYNTHETIC] synth_v3 test runs |
| IS3c | every injected fault caught by stage 3 (bearings) | == 40 | 40 /40 | **PASS** | TFT + N-HiTS (synth_v3) | [SYNTHETIC] synth_v3 test runs |
| S8 / ICS2 | classification latency per window, p95 (1 thread, batch 1) | < 200.00 | 0.3442 ms | **PASS** | v3 GBM classifier ONNX (deployed) | [MEASURED] live on this host (synthetic inputs) |
| S8 / ICS2 | classification latency per window, p95 (1 thread, batch 1) | < 200.00 | 10.81 ms | **PASS** | TFT ONNX (synth_v3) | [MEASURED] live on this host (synthetic inputs) |
| IS1 (ICS leg) | ICS host leg per bearing-window, p95 | < 500.00 | 3.44 ms | **PASS (leg only)** | v3 engine step (features+cls+RUL) | [MEASURED] live on this host |
| IS1 (ICS leg) | ICS host leg per bearing-window, p95 | < 500.00 | 14.03 ms | **PASS (leg only)** | TFT+N-HiTS engine step | [MEASURED] live on this host |

## Metric definitions

```
UP2 spec metrics (pure functions over prediction frames). Definitions are stated in every report.

S7 / ICS1 (spec metric, absolute hours) = the DESIGN.md section 7 PRE-REGISTERED definition (2026-10-04, also
  used for the PPR v2 public-data number): degradation window = [t_onset, T_fail - 0.1 (T_fail - t_onset)], t_onset =
  the CAUSAL detected onset (labels.detect_onset on the HI: the first predicting time), and
    MAPE = mean over test run-to-failure bearings of [mean over that bearing's degradation-window windows of
           |RUL_pred_h - RUL_true_h| / RUL_true_h] * 100      (bearing-averaged)
  Alternatives, reported alongside, never substituted:
    STRICTER, synthetic-only: same formula with the generator's TRUE onset (includes the first ~15 % of the
      degradation interval where the defect is not yet detectable, so the life prior dominates)
    percent-of-life error = mean |RUL_pred_h - RUL_true_h| / life_h * 100 (points), true-onset window
    MAPE over the full detected degradation interval (no 10 % tail exclusion)
  Disclosure: the first v3 code used the true-onset variant as primary; after the validation run it was set back to
  the pre-registered section 7 definition (before any test score), and both are reported.
IS3a macro-F1 over {healthy, outer_race, inner_race, ball, cage}, every scored window of every test bearing.
IS3b stage error = |stage_pred - stage_true| over every scored window of the test run-to-failure bearings
     (stage_true = generator truth); literal max reported, plus fraction within +/-1.
IS3c caught by stage 3: first window where the predicted class equals the bearing's fault for 3
     consecutive windows; caught_by_stage3 = true stage at that window <= 3.
```

## Test detail: DEPLOYED v3 heads: xgb classifier + lgbm RUL/lgbm stage (gradient-boosted trees)

Per-class F1: healthy 0.985, outer_race 0.973, inner_race 0.964, ball 0.954, cage 0.931; accuracy 0.977; windows 39892 on 100 bearings

Confusion (rows true, cols pred; order healthy, outer_race, inner_race, ball, cage):

```
  29519      38      29      87     124
    102    2513       1       0       0
    142       1    2298       0       0
    111       0       0    2057       0
    263       0       0       0    2607
```

Stage error histogram {'0': 12588, '1': 2182, '2': 18} (n=14788); within +/-1 0.9988; MAE 0.150; windows with error >= 2: 18 on 2 bearings
Caught by stage 3: 40/40; caught-at-stage histogram {'2': 40}; per class {'ball': '10/10', 'cage': '10/10', 'inner_race': '10/10', 'outer_race': '10/10'}; never caught 0
RUL: S7 15.53 % over 40 bearings / 9073 windows; per-bearing median 11.94, p90 24.23, max 52.57, share of bearings <= 15 %: 0.65; RMSE 9.35 h; full-interval MAPE 17.95 %; true-onset (stricter) MAPE 18.18 %; per rpm {'1750': 13.75161172090471, '3600': 18.18993013824578}; per class {'ball': 15.804550288952623, 'cage': 16.299557824770073, 'inner_race': 15.368053635289021, 'outer_race': 14.635594602352839}

RUL error vs true elapsed fraction of the degradation interval:

| u | MAPE % | median APE % | bias % | n |
|---|---|---|---|---|
| 0.0-0.1 | 28.84 | 23.78 | -5.36 | 1022 |
| 0.1-0.2 | 19.57 | 14.69 | -2.46 | 1005 |
| 0.2-0.3 | 12.06 | 8.94 | -2.13 | 1009 |
| 0.3-0.4 | 12.14 | 10.81 | -1.93 | 1005 |
| 0.4-0.5 | 11.92 | 10.50 | -1.91 | 995 |
| 0.5-0.6 | 11.62 | 9.53 | -1.23 | 1018 |
| 0.6-0.7 | 13.94 | 12.56 | -0.05 | 1008 |
| 0.7-0.8 | 18.01 | 15.94 | -2.12 | 1000 |
| 0.8-0.9 | 19.63 | 16.31 | +4.29 | 1008 |

## Test detail: TFT (class) + N-HiTS (HI forecast -> RUL, rul.py) -- spec-named models, trained on the same runs

Per-class F1: healthy 0.973, outer_race 0.922, inner_race 0.912, ball 0.919, cage 0.914; accuracy 0.959; windows 39892 on 100 bearings

Confusion (rows true, cols pred; order healthy, outer_race, inner_race, ball, cage):

```
  28865     236     277     209     210
    149    2466       1       0       0
    118      29    2294       0       0
    132       2       2    2021      11
    257       0      14       0    2599
```

Stage error histogram {'0': 9069, '1': 5090, '2': 604, '3': 22, '4': 3} (n=14788); within +/-1 0.9575; MAE 0.431; windows with error >= 2: 629 on 37 bearings
Caught by stage 3: 40/40; caught-at-stage histogram {'1': 3, '2': 35, '3': 2}; per class {'ball': '10/10', 'cage': '10/10', 'inner_race': '10/10', 'outer_race': '10/10'}; never caught 0
RUL: S7 54.59 % over 40 bearings / 9073 windows; per-bearing median 49.70, p90 83.67, max 124.80, share of bearings <= 15 %: 0.00; RMSE 32.54 h; full-interval MAPE 54.61 %; true-onset (stricter) MAPE 52.04 %; per rpm {'1750': 49.251888336813465, '3600': 62.59454438698726}; per class {'ball': 71.6461516909379, 'cage': 57.775490786600855, 'inner_race': 51.198902110706484, 'outer_race': 37.7352584392867}

RUL error vs true elapsed fraction of the degradation interval:

| u | MAPE % | median APE % | bias % | n |
|---|---|---|---|---|
| 0.0-0.1 | 50.52 | 50.03 | -32.31 | 1022 |
| 0.1-0.2 | 46.38 | 48.92 | -38.85 | 1005 |
| 0.2-0.3 | 42.09 | 41.74 | -31.09 | 1009 |
| 0.3-0.4 | 39.80 | 36.51 | -21.07 | 1005 |
| 0.4-0.5 | 41.49 | 31.04 | -6.22 | 995 |
| 0.5-0.6 | 42.17 | 27.82 | +10.46 | 1018 |
| 0.6-0.7 | 53.65 | 26.89 | +35.30 | 1008 |
| 0.7-0.8 | 70.87 | 37.91 | +58.01 | 1000 |
| 0.8-0.9 | 71.60 | 39.44 | +60.74 | 1008 |

## Robustness (fresh runs never used for fitting or selection; informational, no verdict)

| set | knobs changed | model | macro-F1 | stage max | within+/-1 | caught by st.3 | S7 MAPE % | %-of-life pts |
|---|---|---|---|---|---|---|---|---|
| synth_v3_noise15 | {'noise_scale': 1.5} | gbm | 0.803 | 2 | 0.9985 | 48/48 | 14.34 | 7.37 |
| synth_v3_noise15 | {'noise_scale': 1.5} | nn | 0.809 | 4 | 0.8859 | 48/48 | 79.52 | 22.75 |
| synth_v3_rpm3000 | {'rpm_modes': (3000.0,)} | gbm | 0.958 | 2 | 0.9994 | 48/48 | 13.10 | 5.72 |
| synth_v3_rpm3000 | {'rpm_modes': (3000.0,)} | nn | 0.921 | 3 | 0.9518 | 48/48 | 53.18 | 13.46 |
| synth_v3_hard | {'signature': 0.75, 'life_sigma': 0.45, 'transmission': (0.08, 0.16), 'shape_a': (0.25, 0.35), 'shape_p': (2.0, 3.0), 'eol_sev': (0.75, 1.25)} | gbm | 0.948 | 2 | 0.9988 | 48/48 | 24.15 | 9.65 |
| synth_v3_hard | {'signature': 0.75, 'life_sigma': 0.45, 'transmission': (0.08, 0.16), 'shape_a': (0.25, 0.35), 'shape_p': (2.0, 3.0), 'eol_sev': (0.75, 1.25)} | nn | 0.906 | 3 | 0.9504 | 48/48 | 60.25 | 19.92 |

## Latency (live, this host, ONNX Runtime, 1 thread, batch 1)

```
{
 "v3_cls_onnx": {
  "p50_ms": 0.22615000125369988,
  "p95_ms": 0.3441799985012042,
  "max_ms": 0.9083000004466157,
  "n": 300,
  "threads": 1,
  "batch": 1
 },
 "v3_rul_onnx": {
  "p50_ms": 0.4652499992516823,
  "p95_ms": 0.6072099993616576,
  "max_ms": 1.135200000135228,
  "n": 300,
  "threads": 1,
  "batch": 1
 },
 "v3_engine_step": {
  "p50_ms": 2.8945,
  "p95_ms": 3.438,
  "max_ms": 5.828,
  "mean_ms": 2.9677777777777776,
  "n": 216,
  "note": "per bearing-window, features+TFT+N-HiTS+RUL via ONNX Runtime"
 },
 "v3_nn_tft_onnx": {
  "p50_ms": 9.83894999990298,
  "p95_ms": 10.813499999312626,
  "max_ms": 12.614099996426376,
  "n": 300,
  "threads": 1,
  "batch": 1
 },
 "v3_nn_engine_step": {
  "p50_ms": 12.998,
  "p95_ms": 14.0266,
  "max_ms": 15.29,
  "mean_ms": 13.07978341013825,
  "n": 217,
  "note": "per bearing-window, features+TFT+N-HiTS+RUL via ONNX Runtime"
 },
 "host": "Intel64 Family 6 Model 183 Stepping 1, GenuineIntel / Windows 10",
 "unit": "synth_v3:run0171:B1"
}
```

## Previous public-data results (PPR v2) -- [MEASURED on XJTU-SY / IMS / MaFaulDa], stored report

```
{
 "source": "spec_check_20261005T012112Z_real_v2.json",
 "provenance": "[MEASURED on XJTU-SY / IMS / MaFaulDa public bearing data]",
 "verdicts": [
  {
   "spec": "S7",
   "requirement": "RUL MAPE on held-out degradation window (N-HiTS)",
   "op": "<=",
   "target": 15.0,
   "measured": 281.8054261284695,
   "unit": "%",
   "status": "FAIL"
  },
  {
   "spec": "S8",
   "requirement": "TFT classification latency per window, p95 single-window",
   "op": "<",
   "target": 200.0,
   "measured": 11.142779999954655,
   "unit": "ms",
   "status": "PASS"
  },
  {
   "spec": "IS3a",
   "requirement": "macro-F1 over the testable classes (train AND test support; primary)",
   "op": ">=",
   "target": 0.85,
   "measured": 0.5811592376693763,
   "unit": "",
   "status": "FAIL"
  },
  {
   "spec": "IS3a-5",
   "requirement": "macro-F1 over all 5 classes (a class with no output channel scores F1 0)",
   "op": ">=",
   "target": 0.85,
   "measured": 0.5811592376693763,
   "unit": "",
   "status": "FAIL"
  },
  {
   "spec": "IS3b",
   "requirement": "stage error <= 1, literal reading: MAX abs stage error over test windows",
   "op": "<=",
   "target": 1,
   "measured": 4.0,
   "unit": "",
   "status": "FAIL"
  },
  {
   "spec": "IS3c",
   "requirement": "run-to-failure faults caught (3 consecutive correct) by stage 3",
   "op": ">=",
   "target": 1.0,
   "measured": 0.25,
   "unit": "",
   "status": "FAIL"
  },
  {
   "spec": "IS1 (ICS leg)",
   "requirement": "features + TFT + N-HiTS + RUL per window, p95",
   "op": "<",
   "target": 500.0,
   "measured": 14.4168,
   "unit": "ms",
   "status": "PASS"
  }
 ]
}
```

## Generator difficulty knobs

```
{
 "noise_scale": 1.0,
 "life_ref_h": 50.0,
 "life_sigma": 0.35,
 "life_clip_windows": [
  80,
  720
 ],
 "healthy_windows": [
  60,
  200
 ],
 "healthy_run_windows": [
  250,
  700
 ],
 "shape_a": [
  0.28,
  0.32
 ],
 "shape_p": [
  2.3,
  2.7
 ],
 "eol_sev": [
  0.85,
  1.15
 ],
 "transmission": [
  0.04,
  0.1
 ],
 "leak": 0.12,
 "signature": 1.0,
 "drift_sigma": 0.04,
 "transient_rate": 0.004,
 "rpm_modes": [
  1750.0,
  3600.0
 ],
 "rpm_jitter": 0.002
}
```
