amussab/Digital-Twin-Senior-Proj/Project architecture/ME/FE-model-ppr-demo.html

# Bearing stiffness from shaft displacement

Finite-element digital twin of the Bently Nevada RK4 rotor with one 810 g disk at mid-span. The model is given only the two probe readings and has to find the bearing stiffness K. Specification 2: within 10% of a known reference stiffness.

## Formulation

Method

Finite element method (FEM), 1D beam model of the shaft

Element type

Euler–Bernoulli beam elements (bending only, shear ignored)

Mesh

20 elements, 21 nodes, 2 degrees of freedom per node (deflection and slope), 42 in total

Shaft

Steel, E = 200 GPa, ρ = 7850 kg/m³, diameter 10 mm, bearing span 400 mm

Bearings

Linear springs of stiffness K at both ends of the span (same K for both)

Disk

Point mass of 810 g at the middle node

Load

Unbalance force at the disk: F = m·e·ω²

Equation solved

[K − ω²M]·x = F (stiffness minus mass effect at running speed, times displacement, equals force)

Identification

Try 1,200 values of K, predict the probe readings for each, keep the K with the smallest mismatch

Check

Rigid bearings + 10 N at mid-span reproduces the textbook deflection PL³/48EI

## Assumptions

1. Bearings are linear springs, no damping.
2. The unbalance (test mass × radius) is known.
3. Symmetric rotor, so one K for both bearings.
4. Probe readings are the steady once-per-revolution (1×) response, with phase from the Keyphasor.
5. Shaft overhang beyond the bearings and the motor coupling are left out.
6. Probes are calibrated on the shaft (datasheet scale factor 7.87 V/mm, unit-to-unit error +12.5% / −20%).
7. Reference bearing stiffness K = 10 MN/m, from a Hertz contact calculation for a 6200 carrying 5.5 N (range 10–15 MN/m). A calculation, not a measurement; see hand calculation B.
8. Probe noise 0.2 µm per window. Conservative: published eddy-current sensors resolve 0.065–3 µm (Nabavi & Nihtianov, IEEE J. Solid-State Circuits, 2013; Sensors (MDPI), 2022), and even 3 µm gives only 0.03 µm per window; see hand calculation C.

## Test setup

Reference bearing stiffness K The "known case". 10 MN/m is a Hertz-contact estimate for a 6200 carrying about 5 N (a calculation, not a measurement). The model does not see this number.

Shaft speed

Probe distance from bearing Report model: probes at quarter span (100 mm).

Probe noise per window Conservative upper bound, see the note at the bottom. To be measured on the rig.

Windows averaged Each window is 20 shaft revolutions.

Take a measurement Run 2000 measurements

## Result

– –

Probe reading, measured (both probes, averaged) | –
Same reading at the Proximitor output (200 mV/mil) | –
K identified by the model | –
K reference (known case) | –
Probe change if K drops 10% | –
Noise left after averaging | –
2000 repeated measurements Pass = 99% of trials within 10% | not run
Model's first critical speed at this K | –

## How the model finds K

It tries 1,200 stiffness values. For each one it predicts the probe readings, compares them with the measurement, and keeps the value with the smallest mismatch.

## Hand calculations

### A. FE model checked by hand

A1. Shaft section properties (d = 10 mm, E = 200 GPa, \rho = 7850 kg/m³)

I = \frac{\pi d^4}{64} = \frac{\pi(0.010)^4}{64} = 4.909\times10^{-10}\ \text{m}^4

EI = (200\times10^{9})(4.909\times10^{-10}) = 98.17\ \text{N·m}^2

A = \frac{\pi d^2}{4} = 7.854\times10^{-5}\ \text{m}^2,\qquad \rho A = 0.6165\ \text{kg/m}

A2. One beam element (l_e = L/20 = 0.020 m). These are the grids k and mm in the code; 20 of them are added into the 42×42 Ks and Ms.

k_e = \frac{EI}{l_e^3}\begin{bmatrix}12 & 6l_e & -12 & 6l_e\\ 6l_e & 4l_e^2 & -6l_e & 2l_e^2\\ -12 & -6l_e & 12 & -6l_e\\ 6l_e & 2l_e^2 & -6l_e & 4l_e^2\end{bmatrix},\qquad \frac{EI}{l_e^3} = \frac{98.17}{(0.020)^3} = 1.227\times10^{7}\ \text{N/m}

m_e = \frac{\rho A l_e}{420}\begin{bmatrix}156 & 22l_e & 54 & -13l_e\\ 22l_e & 4l_e^2 & 13l_e & -3l_e^2\\ 54 & 13l_e & 156 & -22l_e\\ -13l_e & -3l_e^2 & -22l_e & 4l_e^2\end{bmatrix},\qquad \frac{\rho A l_e}{420} = 2.936\times10^{-5}\ \text{kg}

\left[\mathbf{K} - \omega^2\mathbf{M}\right]\mathbf{x} = \mathbf{F}

A3. Validation: rigid bearings, 10 N at mid-span, no rotation

\delta = \frac{PL^3}{48EI} = \frac{(10)(0.400)^3}{48(98.17)} = 1.358\times10^{-4}\ \text{m} = 135.8\ \mu\text{m}\qquad(\text{FE: }135.81\ \mu\text{m})

A4. Critical speed, one-mass approximation (shaft and both bearings as springs in series; 17/35 is Rayleigh's equivalent share of the shaft's mass)

k_s = \frac{48EI}{L^3} = \frac{48(98.17)}{(0.400)^3} = 73{,}630\ \text{N/m}

k_{eq} = \left(\frac{1}{k_s} + \frac{1}{2K}\right)^{-1} = \left(\frac{1}{73{,}630} + \frac{1}{2(10\times10^{6})}\right)^{-1} = 73{,}360\ \text{N/m}

m_{eq} = m_d + \tfrac{17}{35}\rho A L = 0.810 + \tfrac{17}{35}(0.2466) = 0.930\ \text{kg}

\omega_n = \sqrt{\frac{k_{eq}}{m_{eq}}} = \sqrt{\frac{73{,}360}{0.930}} = 280.9\ \text{rad/s} = 2682\ \text{rpm}\qquad(\text{FE: }2682\ \text{rpm})

A5. Response at 1750 rpm with the 5 g test mass at 30.5 mm

\omega = \frac{2\pi(1750)}{60} = 183.3\ \text{rad/s},\qquad F = me\omega^2 = (0.005)(0.0305)(183.3)^2 = 5.12\ \text{N}

X = \frac{F}{k_{eq} - m_{eq}\omega^2} = \frac{5.12}{73{,}360 - 0.930(33{,}584)} = 1.216\times10^{-4}\ \text{m} = 121.6\ \mu\text{m}\qquad(\text{FE: }121.6\ \mu\text{m at the disk})

X_{L/4} \approx \tfrac{11}{16}X = 83.6\ \mu\text{m}\qquad(\text{FE: }83.9\ \mu\text{m at the probes})

The 11/16 comes from the beam deflection curve \delta(x) = Px(3L^2-4x^2)/48EI evaluated at x = L/4.

### B. Bearing stiffness by Hertz contact theory

Inputs for a 6200: Z = 8 balls, ball diameter D_w = 4.762 mm, pitch diameter d_m = 20 mm, groove radius r_g = 0.52D_w = 2.476 mm, steel E = 206 GPa, \nu = 0.3. Check Z and D_w on the delivered bearings.

B1. Load per bearing (disk + 0.5 m of shaft, shared by two bearings)

W = \frac{(m_d + m_{shaft})\,g}{2} = \frac{(0.810 + 0.308)(9.81)}{2} = 5.49\ \text{N}

B2. Effective modulus (steel on steel)

E' = \frac{E}{1-\nu^2} = \frac{206\times10^{9}}{1-0.3^2} = 226.4\ \text{GPa}

B3. Contact radii (x = rolling direction, y = across the groove)

r_b = \tfrac{D_w}{2} = 2.381,\quad r_i = \tfrac{d_m - D_w}{2} = 7.619,\quad r_o = \tfrac{d_m + D_w}{2} = 12.381\ \text{mm}

\text{Inner: } R_x = \left(\tfrac{1}{r_b} + \tfrac{1}{r_i}\right)^{-1} = 1.814\ \text{mm},\qquad R_y = \left(\tfrac{1}{r_b} - \tfrac{1}{r_g}\right)^{-1} = 61.9\ \text{mm}

\text{Outer: } R_x = \left(\tfrac{1}{r_b} - \tfrac{1}{r_o}\right)^{-1} = 2.948\ \text{mm},\qquad R_y = 61.9\ \text{mm}

B4. Contact constant for each contact (Hamrock & Brewe, 1983), so that Q = K_c\,\delta^{3/2}. Here k is the contact ellipticity and \varepsilon, \varphi are elliptic-integral factors.

\alpha = \frac{R_y}{R_x},\quad k = 1.0339\,\alpha^{0.636},\quad \varepsilon = 1.0003 + \frac{0.5968}{\alpha},\quad \varphi = 1.5277 + 0.6023\ln\alpha,\quad R' = \left(\tfrac{1}{R_x} + \tfrac{1}{R_y}\right)^{-1}

K_c = \pi k E' \sqrt{\frac{2\varepsilon R'}{9}}\;\varphi^{-3/2}

\text{Inner: } \alpha = 34.1,\ k = 9.76,\ \varepsilon = 1.018,\ \varphi = 3.654,\ R' = 1.762\ \text{mm} \;\Rightarrow\; K_i = 1.98\times10^{10}\ \text{N/m}^{1.5}

\text{Outer: } \alpha = 21.0,\ k = 7.17,\ \varepsilon = 1.029,\ \varphi = 3.361,\ R' = 2.814\ \text{mm} \;\Rightarrow\; K_o = 2.10\times10^{10}\ \text{N/m}^{1.5}

B5. Inner and outer contact in series (one ball between two races)

K_n = \left(K_i^{-2/3} + K_o^{-2/3}\right)^{-3/2} = 7.21\times10^{9}\ \text{N/m}^{1.5}

B6. At this light load with normal clearance, the bottom ball carries the load

\delta = \left(\frac{W}{K_n}\right)^{2/3} = \left(\frac{5.49}{7.21\times10^{9}}\right)^{2/3} = 0.833\ \mu\text{m}

K = \frac{dQ}{d\delta} = \tfrac{3}{2}K_n\delta^{1/2} = \frac{1.5\,W}{\delta} = \frac{1.5(5.49)}{0.833\times10^{-6}} = 9.9\times10^{6}\ \text{N/m} \approx 10\ \text{MN/m}

With zero clearance, several balls share the load and the same method gives about 15 MN/m. So K = 10–15 MN/m. This is a calculation, not a measurement, and it leaves out the housing's own flexibility.

### C. Probe noise

Worst published eddy-current sensor resolution: 3 µm (Sensors, MDPI, 2022). Samples in one 20-revolution window at 1750 rpm and 25 kS/s:

N = f_s\,t_{window} = 25{,}000 \times \frac{20 \times 60}{1750} = 17{,}143

\sigma_{1\times} = \sigma_{raw}\sqrt{\frac{2}{N}} = 3\ \mu\text{m}\times\sqrt{\frac{2}{17{,}143}} = 0.032\ \mu\text{m}

The demo uses 0.2 µm per window, about 6 times larger, then averages 50 windows and 2 probes:

\sigma_{avg} = \frac{0.2\ \mu\text{m}}{\sqrt{50 \times 2}} = 0.020\ \mu\text{m}

Rig parameters

Shaft diameter is from the RK4 datasheet. Span and disk mass are from a published RK4 test; check them on our rig. The unbalance is a known test mass screwed into a disk balance slot; weigh the screw you use.

Shaft diameter, mm (datasheet) Bearing span, mm (measure) Disk mass, g (weigh) Test mass in balance slot, g (weigh) Balance slot radius, mm

Sources: Bently Nevada RK4 Rotor Kit datasheet 141592 Rev. P (10 mm shaft, Proximitor output 200 mV/mil). NASA/TM NTRS 20060047685, RK4 test rig with one 810 g disk, 400 mm bearing span, balance slots at 30.5 mm radius, first critical speed about 2000 rpm on the stock journal bearings.
