amussab/Digital-Twin-Senior-Proj/Project architecture/overview/252-Specifications-TEAM M001.xlsx

TEAM M001
 |  | #REF! | 3
Constraints and Specifications Number | Constraints and Specifications (Value/Metric) | Off-the- Shelf | Project Specific (Not Off- the-Shelf) | COE |  |  | ICS |  |  | ME
 |  |  |  | Assigned to Dept | Approval | Comments | Assigned to Dept | Approval | Comments | Assigned to Dept | Approval | Comments
Constraint 1 | OH-2 (API 610) pumps — Goulds 3196 STi+MTi class: drivers ≤40 HP (STi) / ≈122 HP (MTi); 60 Hz grid → 1750 or 3500 rpm; housing envelope ≤10 mm/s RMS |  | Yes |  |  |  |  |  |  | Yes | Yes
Constraint 2 | Mains-powered node; SELV (≤50V DC) IEPE sensor excitation: 24V/4mA through the coax, AC-coupled to ADC range |  | Yes | Yes | Yes
Constraint 3 | Node BOM ≤4,000 SAR (placeholder, pending quotes); target sell price ≤8,000 SAR/node |  | Yes |  |  |  | Yes | No | Constraint not related to CS
Constraint 4 | All real-time data acquisition and signal processing shall execute entirely on local hardware without reliance on cloud-based computation |  | Yes | Yes | Yes
Constraint 5 | Dashboard accessible only on the local network; no external/cloud exposure of vibration data |  | Yes |  |  |  | Yes | Yes
Constraint 6 | The enclosure must be fabricated from a UV-stabilized, weather-resistant polymer (e.g., ABS/PETG) to protect internal electronics from dust, moisture, and UV/thermal degradation during continuous operation. |  | Yes |  |  |  |  |  |  | Yes | Yes
Constraint 7
Constraint 8
Specification 1 | 2× biaxial (X,Y) IEPE sets, one per radial bearing housing = 4 channels: 100 mV/g, ±50g, flat 2-10 kHz; dual-mode input. No thrust bearing/axial load in the rig, so no Z-axis channel. | Yes |  |  |  |  |  |  |  | Yes | Yes
Specification 2 | Finite-element digital twin: 1D beam model identifies bearing stiffness K from measured shaft displacement with ≤10% error against a known-stiffness reference case |  | Yes |  |  |  |  |  |  | Yes | Yes
Specification 3 | The enclosure shall maintain an IP54 dust/moisture ingress rating (per IEC 60529) while sustaining continuous operation with no material or seal degradation at ambient temperatures up to 85 °C under direct UV exposure. |  | Yes |  |  |  |  |  |  | Yes | No | doublication with const. 6
Specification 4 | The COE acquisition subsystem shall have a sample rate of ≥25 kSamples/s per channel (4 channels total: 2 radial bearings × X,Y) |  | Yes | Yes | Yes
Specification 5 | After acquisition of a 20-revolution window is complete, the COE subsystem shall process the window and make the output payload available within 333 ms |  | Yes | Yes | Yes
Specification 6 | The COE subsystem shall transform each 20-revolution vibration window into an AI-ready representation with fixed dimensionality and defined ordering, independent of shaft speed over the 1000 - 3600 RPM operating range. |  | Yes | Yes | Yes
Specification 7 | Pump-bearing RUL: MAPE≤15% on held-out degradation window (=≥85% mean accuracy) — pretrained NHiTS, fine-tun2d |  | Yes |  |  |  | Yes | Yes
Specification 8 | Fault-classification inference <200 ms/window — pretrained TFT, fine-tuned |  | Yes |  |  |  | Yes | Yes | The system shall generate audit results for each transaction within 200 ms per transaction after receiving a complete transaction batch.
Specification 9 | Dashboard & digital-twin presentation: UI refresh ≥10 Hz; physics RUL + AI RUL + fault ID updated together within N1's budget |  | Yes |  |  |  | Yes | No | The auditing dashboard shall update within 2 seconds after receiving a new transaction or audit result
Specification 10
Specification 11
Specification 12
Integrated Specification 1 | Sensor → classify+RUL → dashboard <500 ms |  | Yes | Yes | No | not clear | Yes | No | Not clear . Specification should be specif and clear | Yes | No | reflect the integrtion , how this is governed by all departments
Integrated Specification 2 | Physics-AI residual: max relative error between the FE-identified physics RUL and the AI RUL ≤5%, health stage 1→3 |  | Yes | Yes | No | not clear | Yes | No |  | Yes | Yes
Integrated Specification 3 | Classification & stage performance: macro-F1≥85% over {Healthy, OD, ID, BD, CF}; stage error ≤1; any injected fault caught by stage 3 at the latest |  | Yes | Yes | No | not clear | Yes | No |  | Yes | Yes
Integrated Specification 4
Integrated Specification 5
Integrated Specification 6
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
