amussab/Digital-Twin-Senior-Proj/evidence/dashboard_live_20261005.png

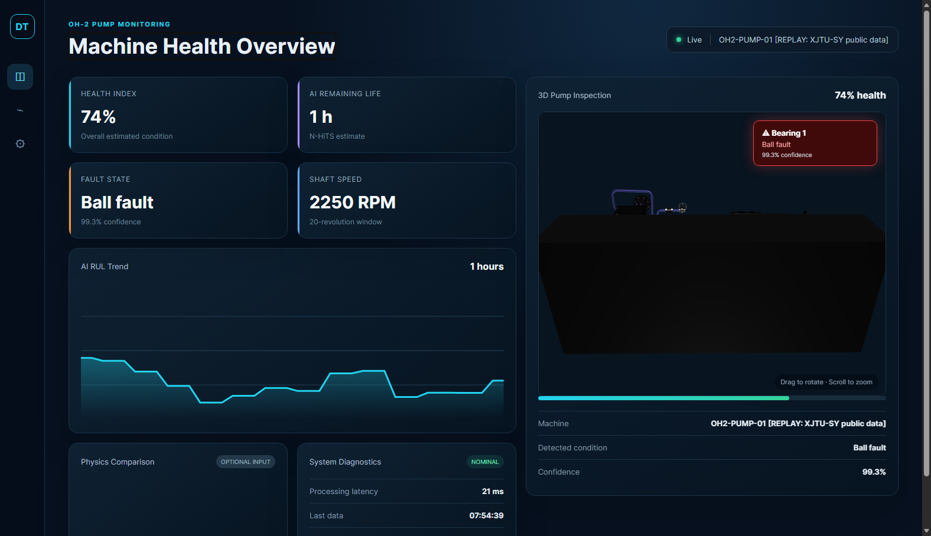
evidence/dashboard_live_20261005.png
