amussab/Digital-Twin-Senior-Proj/evidence/dashboard_up2_20261024.png

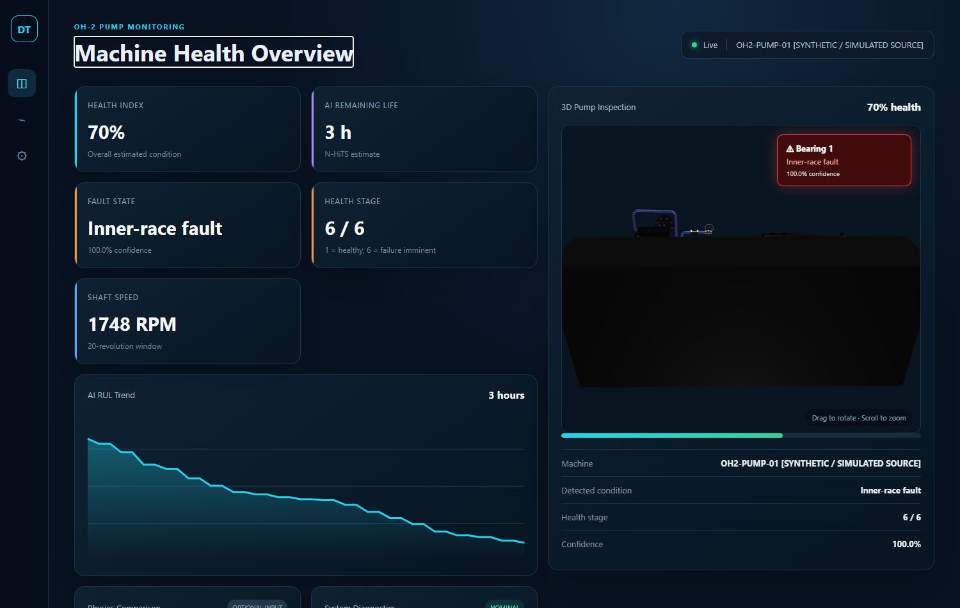
evidence/dashboard_up2_20261024.png
