amussab/Digital-Twin-Senior-Proj/evidence/dashboard_up2_replay_20261025.png

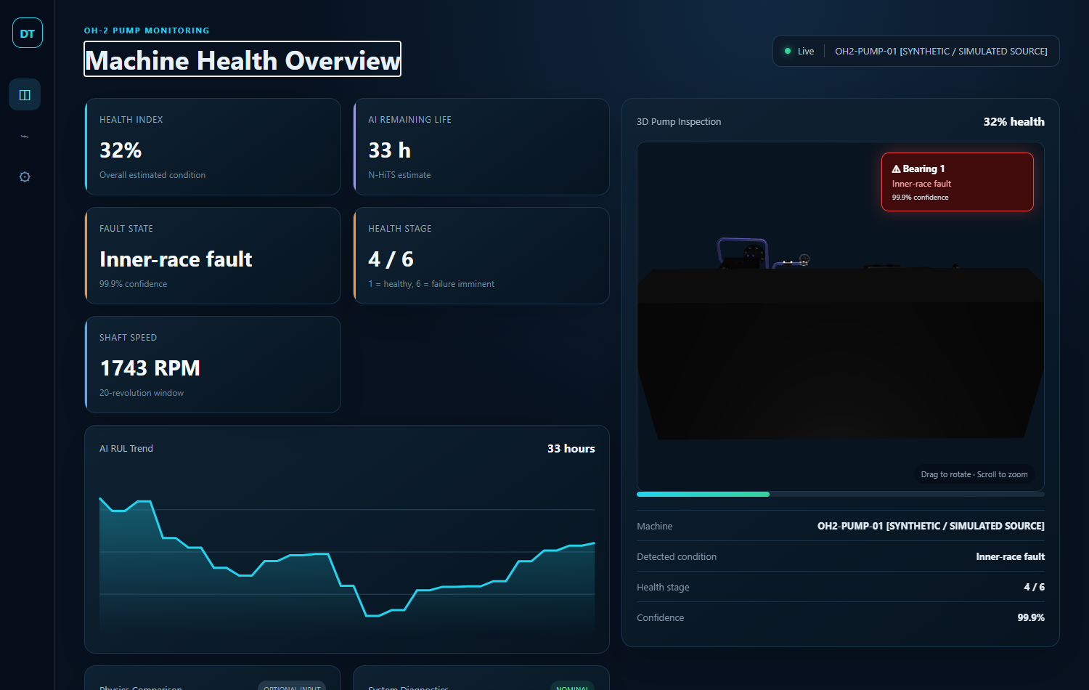
evidence/dashboard_up2_replay_20261025.png
