amussab/Digital-Twin-Senior-Proj/evidence/up2_figures/c4_checks.png

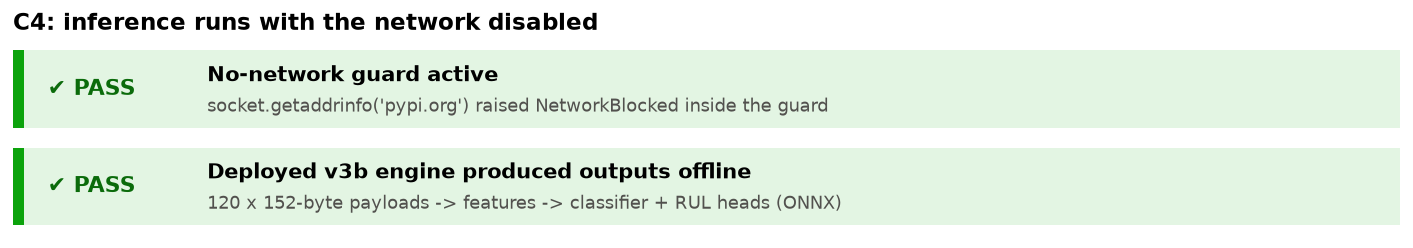
evidence/up2_figures/c4_checks.png
