amussab/Digital-Twin-Senior-Proj/evidence/up2_figures/c5_checks.png

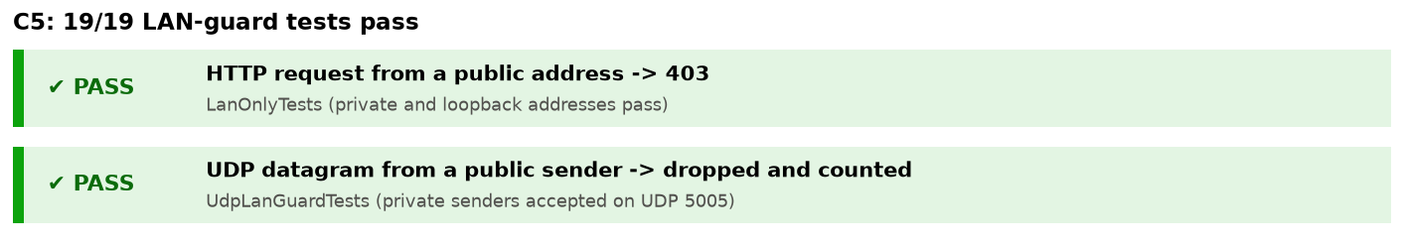
evidence/up2_figures/c5_checks.png
