amussab/Digital-Twin-Senior-Proj/evidence/up2_figures/coe_adapt.png

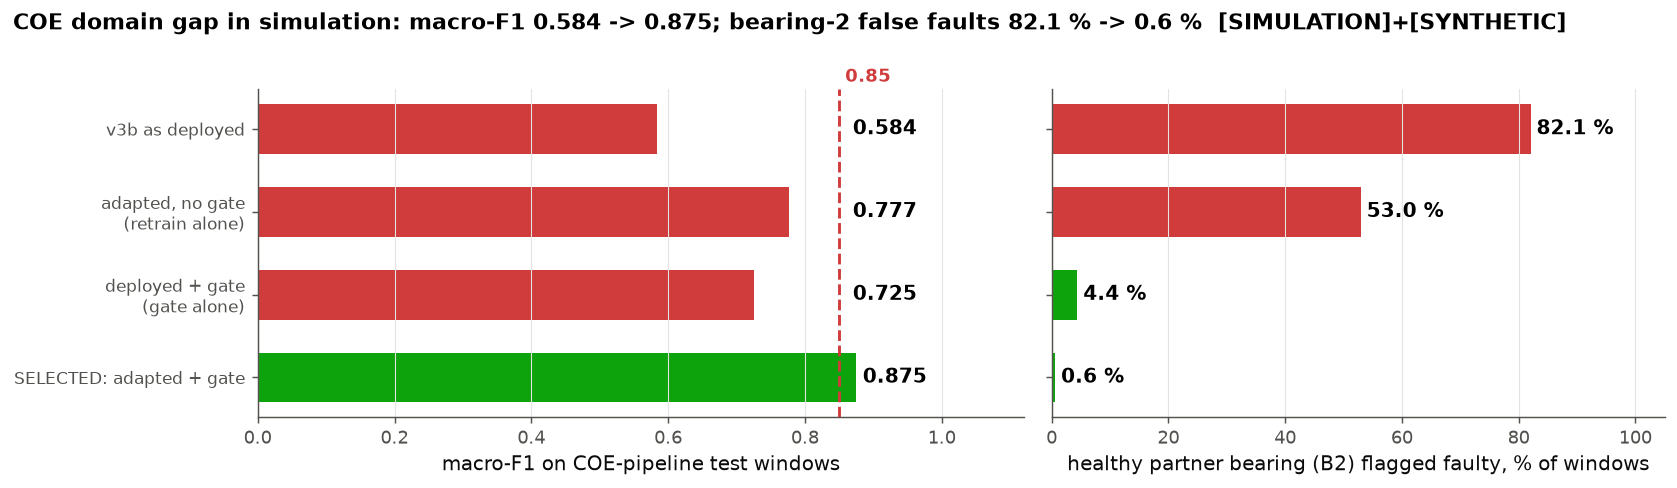
evidence/up2_figures/coe_adapt.png
