amussab/Digital-Twin-Senior-Proj/evidence/up2_figures/coe_pipeline_stages.png

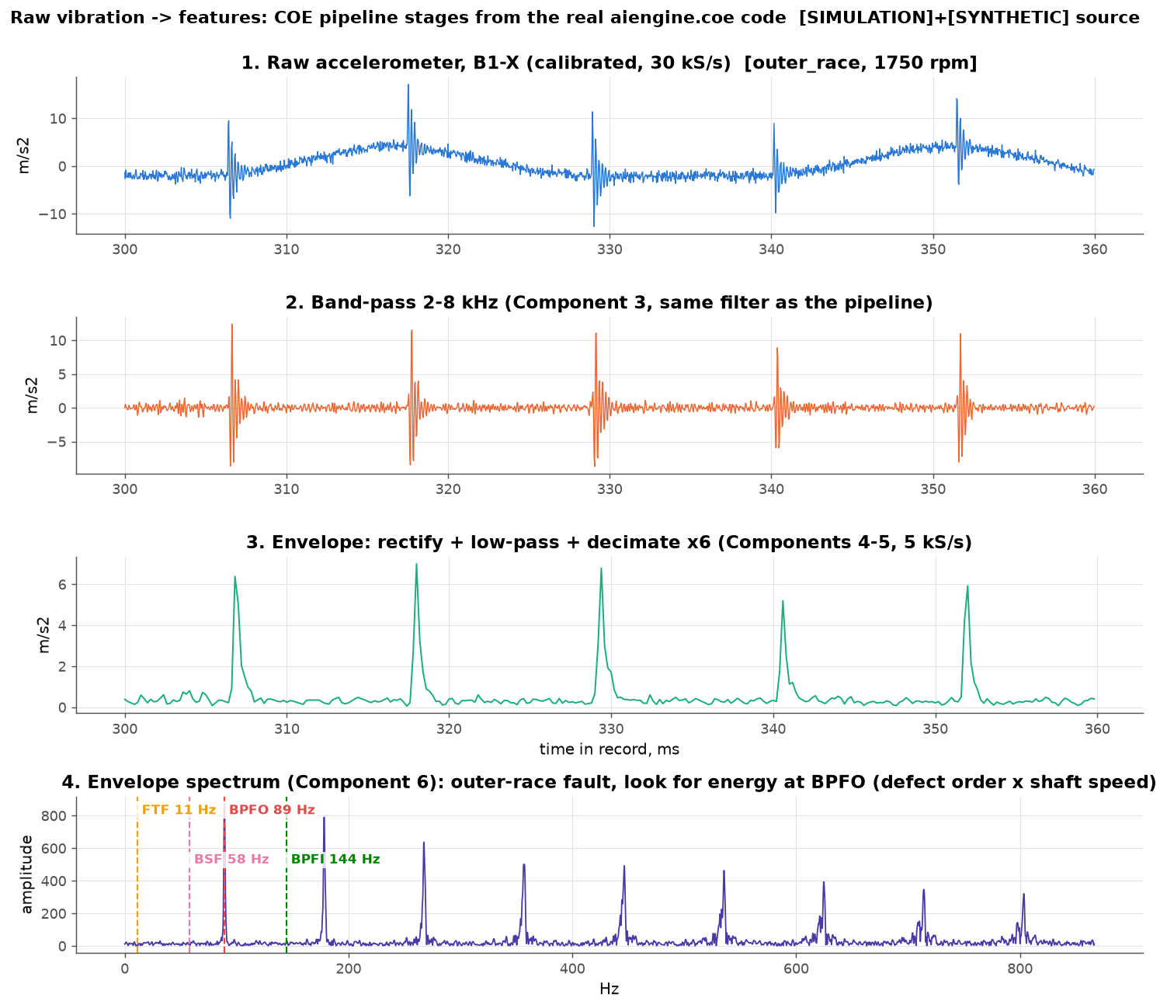
evidence/up2_figures/coe_pipeline_stages.png
