amussab/Digital-Twin-Senior-Proj/evidence/up2_figures/coe_s4_s5_s6.png

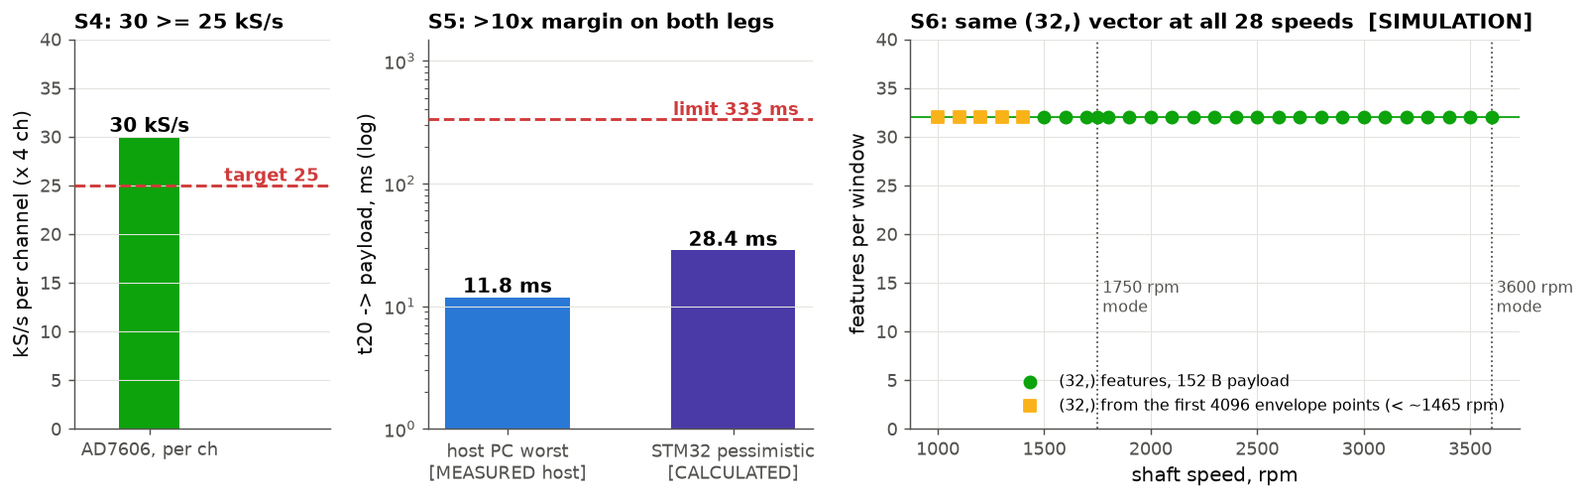
evidence/up2_figures/coe_s4_s5_s6.png
