amussab/Digital-Twin-Senior-Proj/evidence/up2_figures/data_basis.png

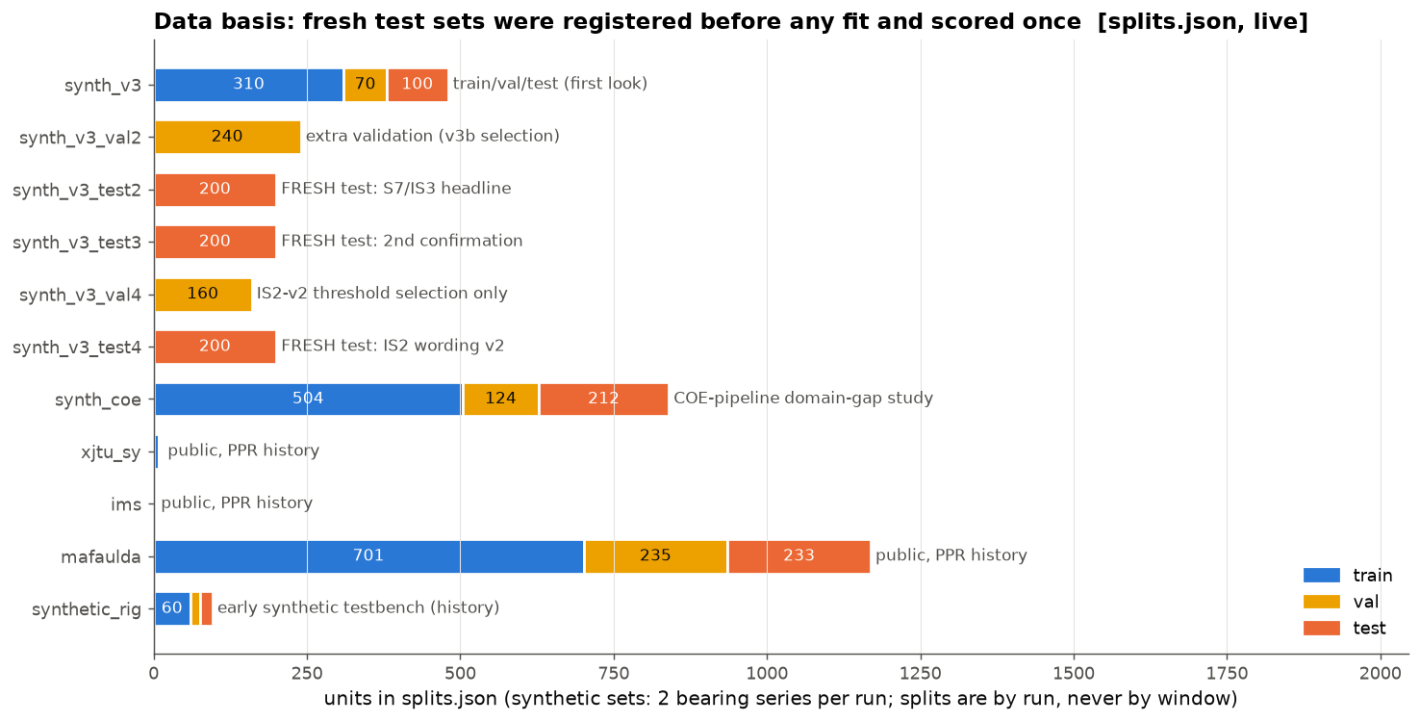
evidence/up2_figures/data_basis.png
