amussab/Digital-Twin-Senior-Proj/evidence/up2_figures/is1_budget.png

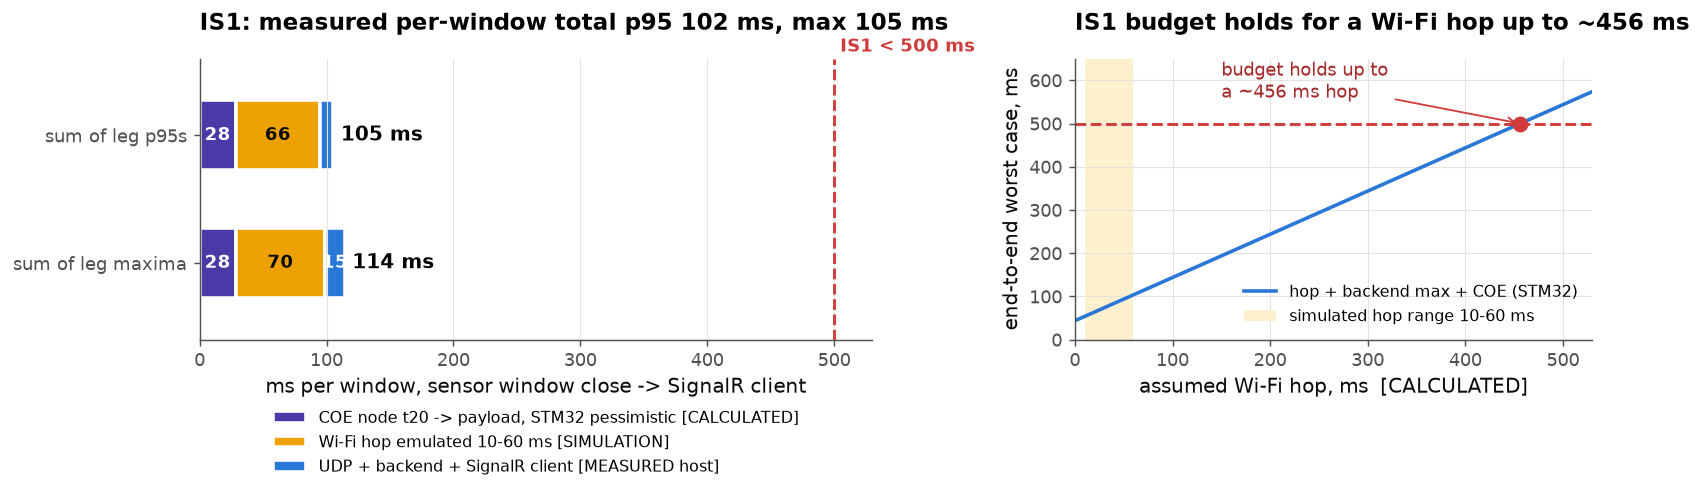
evidence/up2_figures/is1_budget.png
