amussab/Digital-Twin-Senior-Proj/evidence/up2_figures/is2_v1_vs_v2.png

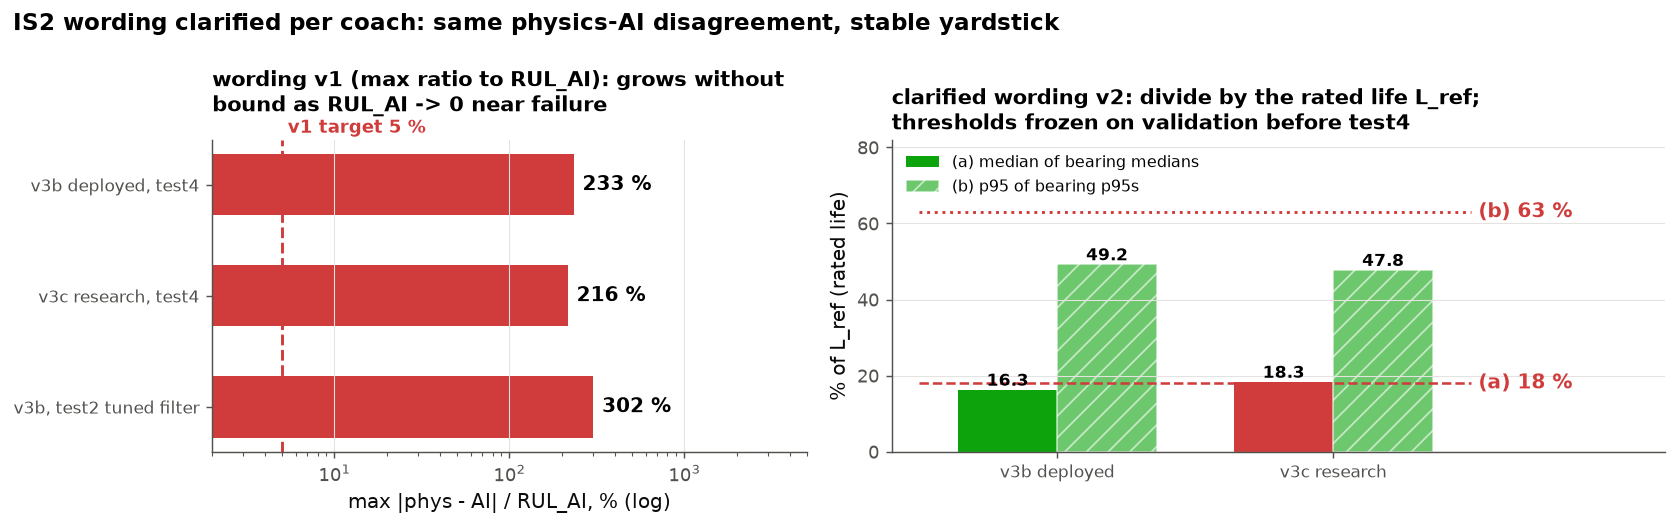
evidence/up2_figures/is2_v1_vs_v2.png
