amussab/Digital-Twin-Senior-Proj/evidence/up2_figures/is2_v2_scatter.png

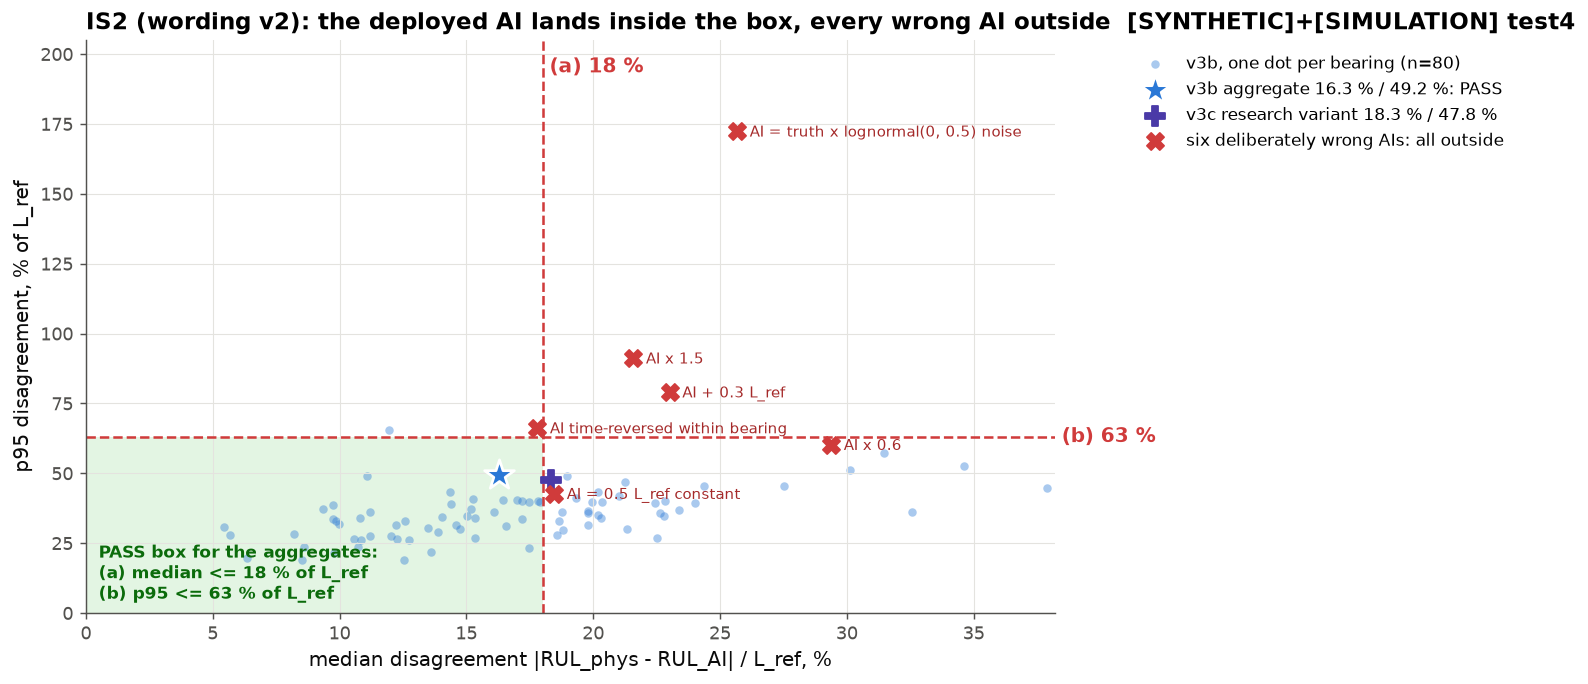
evidence/up2_figures/is2_v2_scatter.png
