amussab/Digital-Twin-Senior-Proj/evidence/up2_figures/is3_confusion_f1.png

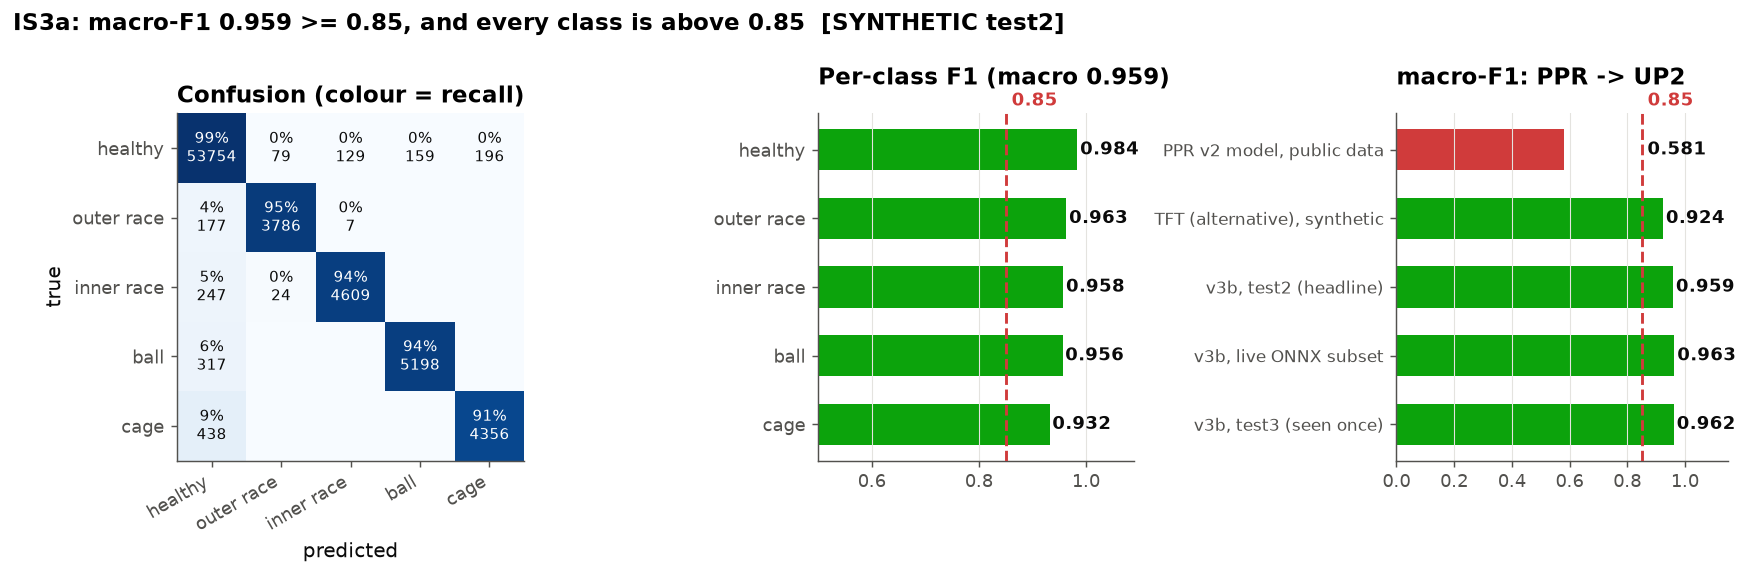
evidence/up2_figures/is3_confusion_f1.png
