amussab/Digital-Twin-Senior-Proj/evidence/up2_figures/is3_stage_and_catch.png

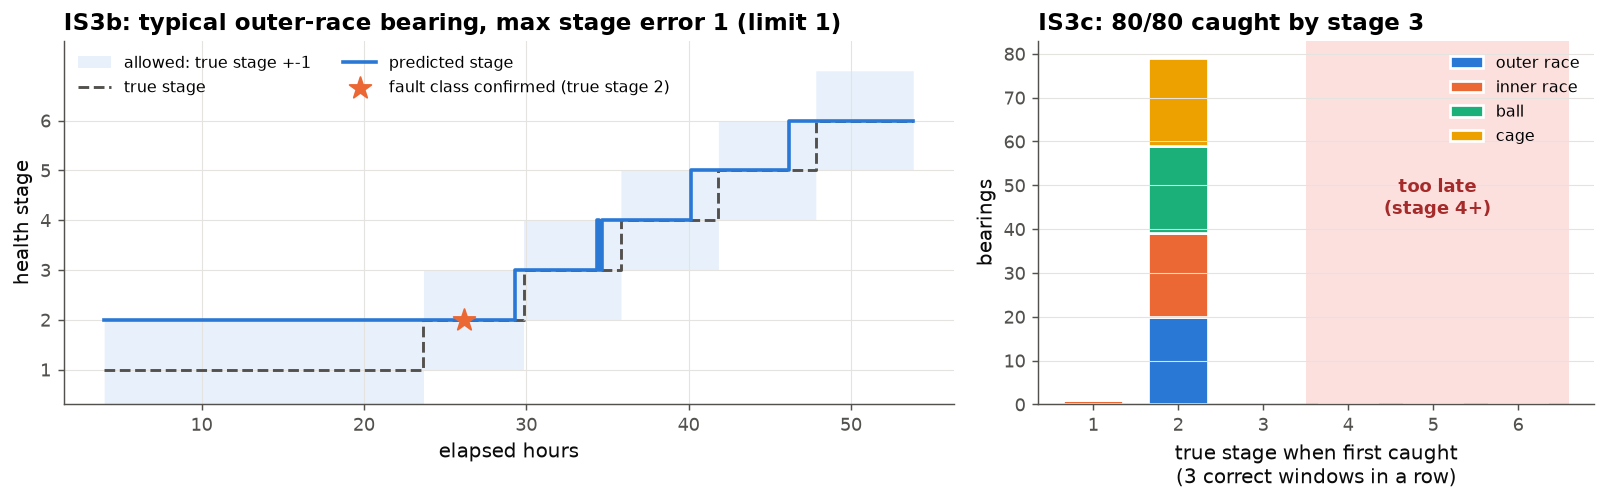
evidence/up2_figures/is3_stage_and_catch.png
