amussab/Digital-Twin-Senior-Proj/evidence/up2_figures/s7_per_bearing_mape.png

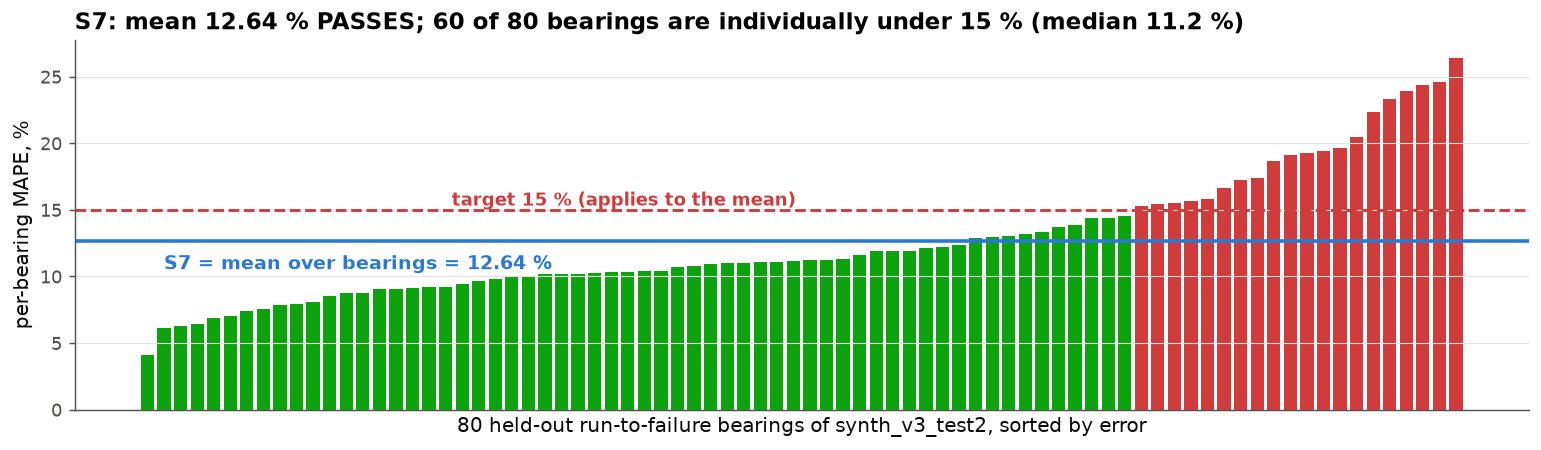
evidence/up2_figures/s7_per_bearing_mape.png
