amussab/Digital-Twin-Senior-Proj/evidence/up2_figures/s7_ppr_vs_up2.png

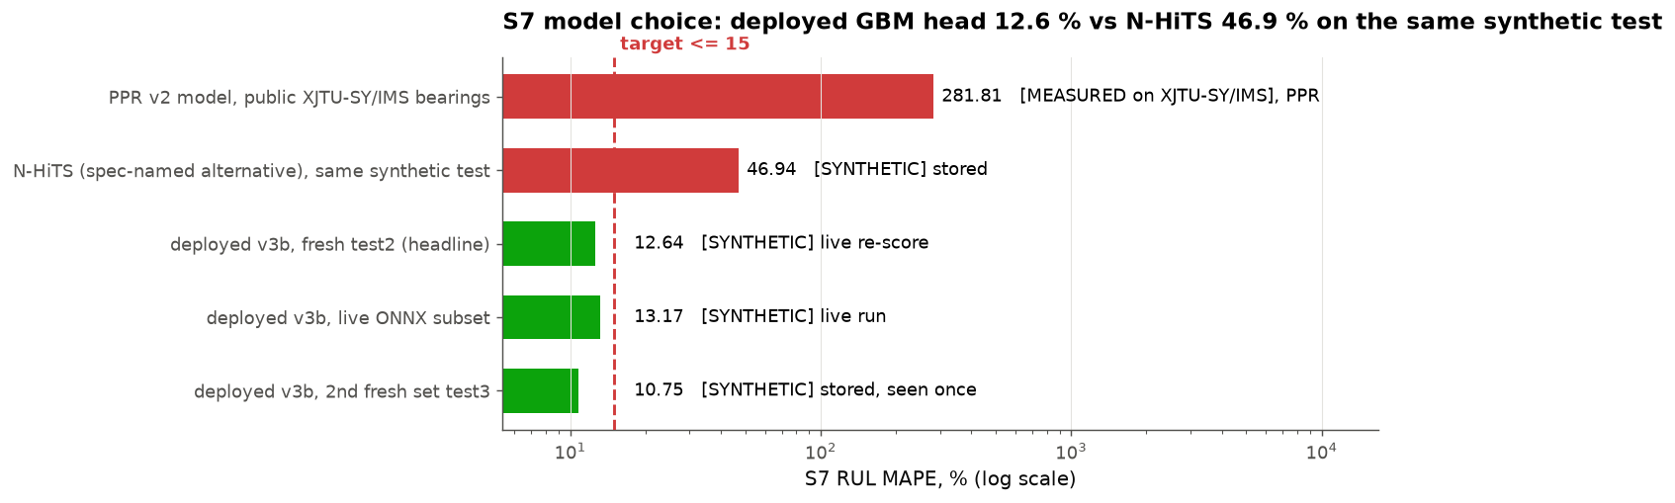
evidence/up2_figures/s7_ppr_vs_up2.png
