amussab/Digital-Twin-Senior-Proj/evidence/up2_figures/s7_rul_curves.png

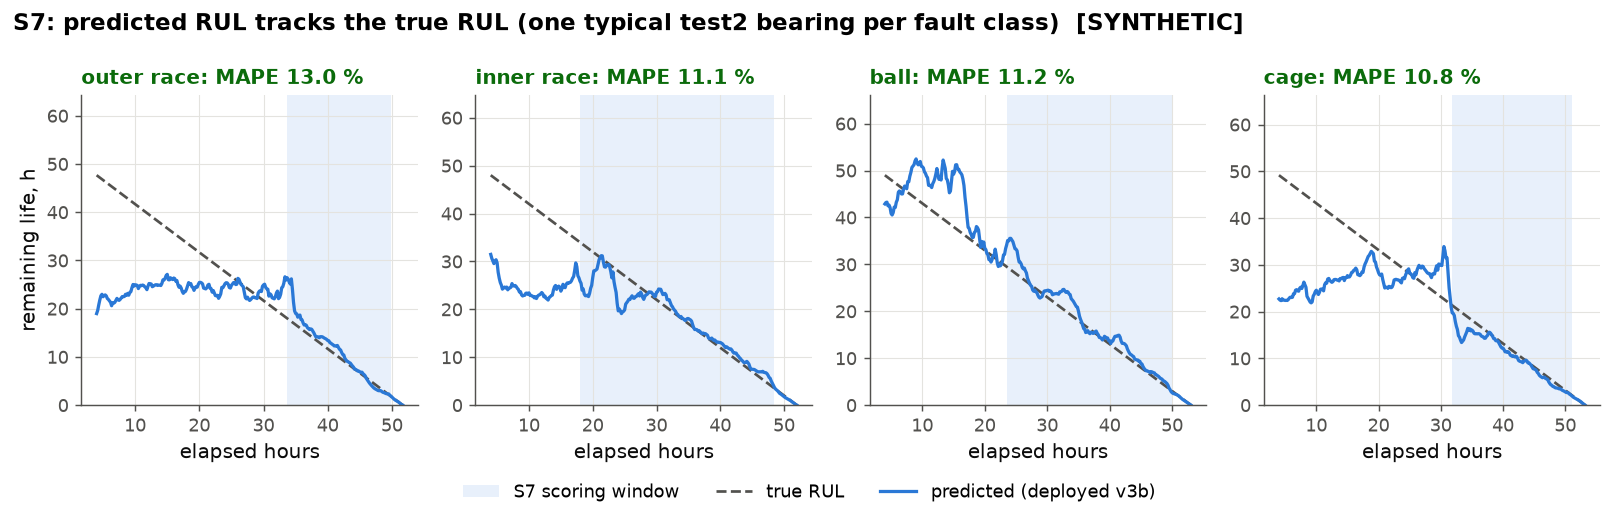
evidence/up2_figures/s7_rul_curves.png
