amussab/Digital-Twin-Senior-Proj/evidence/up2_figures/s8_latency.png

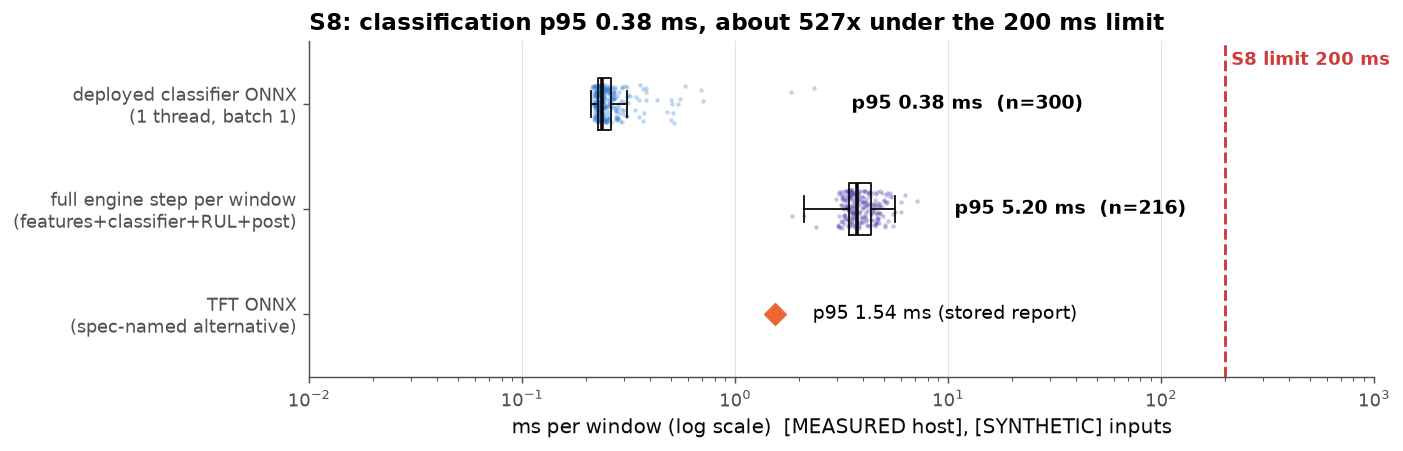
evidence/up2_figures/s8_latency.png
