amussab/Digital-Twin-Senior-Proj/evidence/up2_figures/s9_rate.png

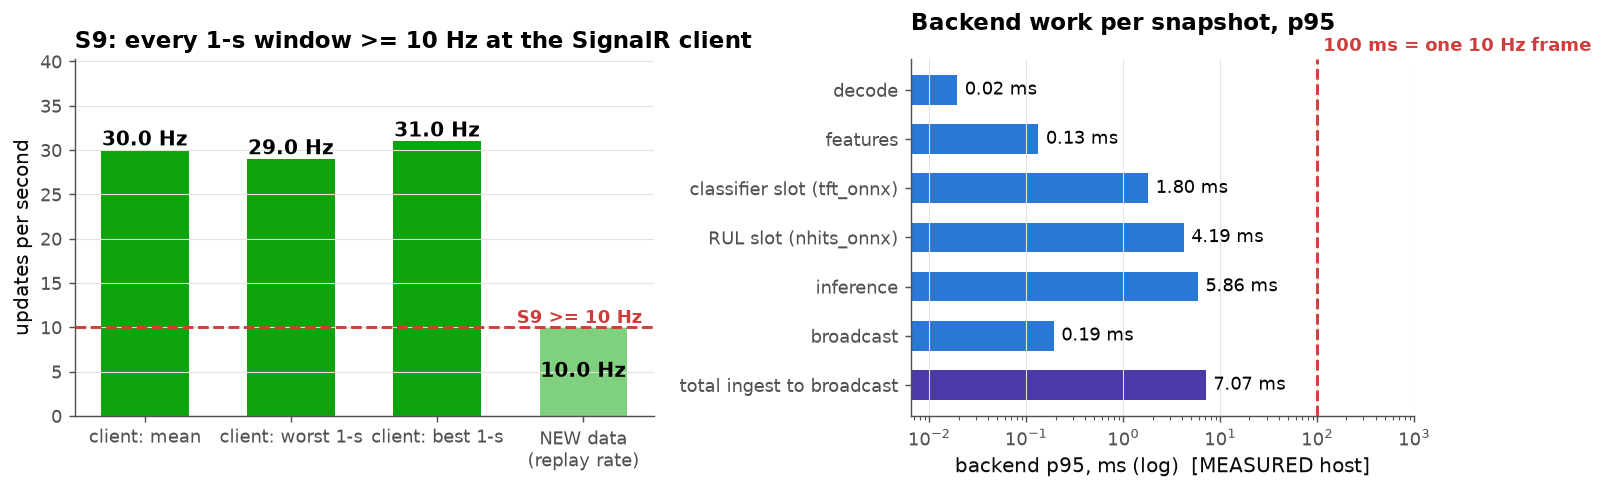
evidence/up2_figures/s9_rate.png
