amussab/Digital-Twin-Senior-Proj/evidence/up2_figures/up2_demo_timeline.png

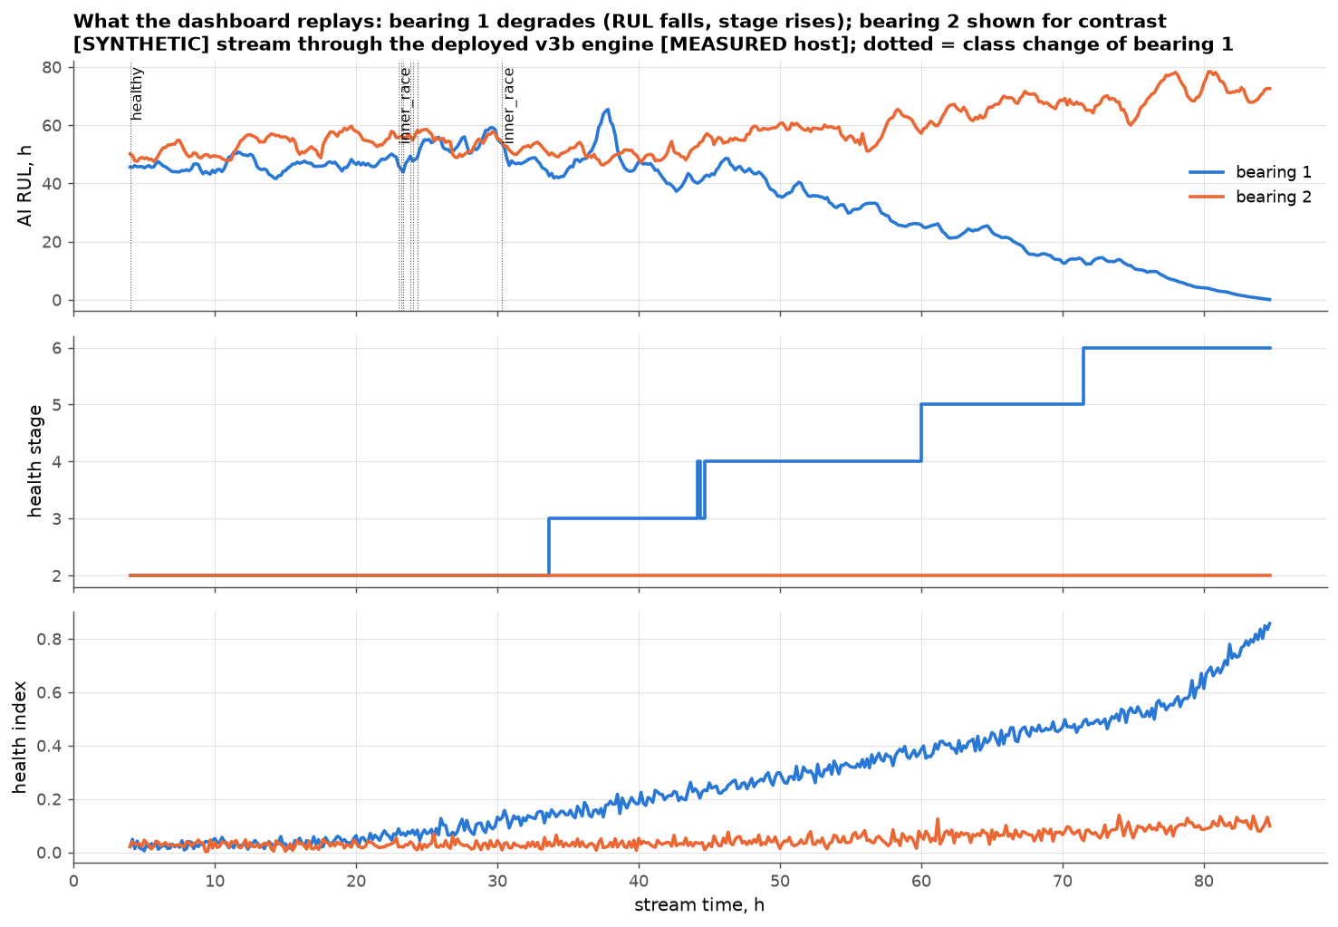
evidence/up2_figures/up2_demo_timeline.png
