amussab/Digital-Twin-Senior-Proj/evidence/up2_figures/up2_status_summary.png

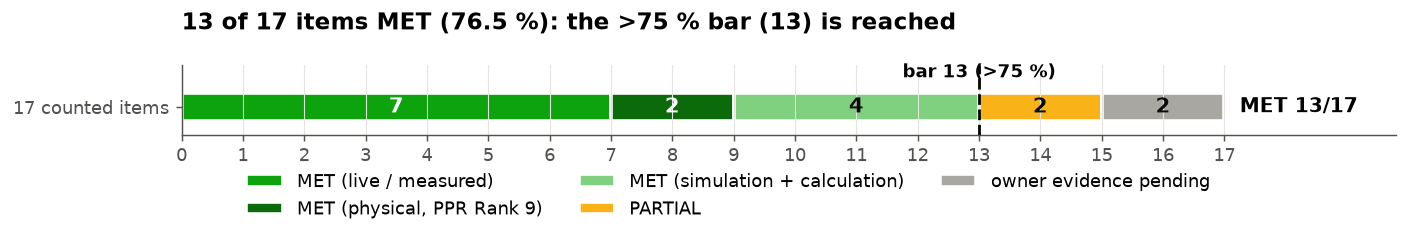
evidence/up2_figures/up2_status_summary.png
