amussab/Digital-Twin-Senior-Proj/Project architecture/ME/Enclosure CAD/out/preview.png

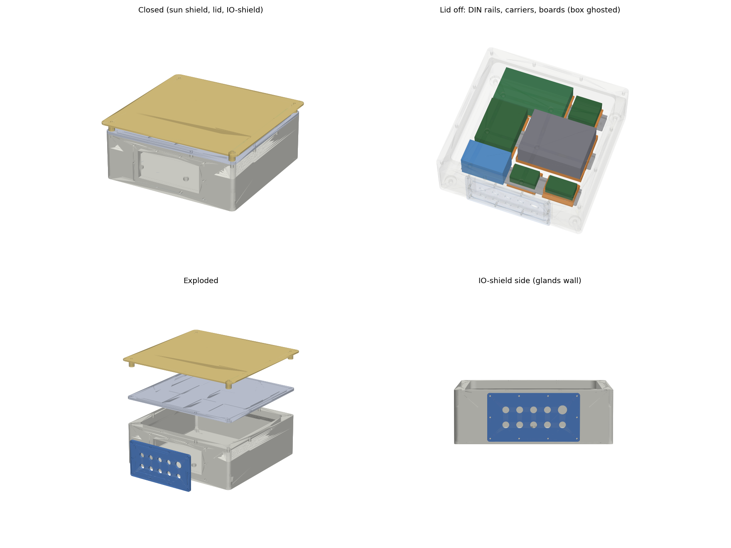
Project architecture/ME/Enclosure CAD/out/preview.png
