amussab/Digital-Twin-Senior-Proj/evidence/up2_figures/up2_master_table.csv

ID | Item | Owner dept | PPR status (old) | UP2 status | Tier | Measured | Target | Verdict / note | Model actually deployed | Alternative model (N-HiTS/TFT), same data | Firm? | Rank achieved | Rank achievable | Step that raises it | Provenance | Source
C1 | OH-2 (API 610) pumps, Goulds 3196 STi+MTi class: drivers <=40/~122 HP, 1750/3500 rpm, housing <=10 mm/s RMS | ME | NOT EVIDENCED | OWNER EVIDENCE PENDING (ME) | - | - | see Specifications.md | Goulds 3196 STi/MTi datasheet table (HP and rpm limits), sensor-mounting CAD on the housing, housing envelope <= 10 mm/s RMS. | - | - | no | 0 | 3-9 depending on the owner's artifact | Goulds 3196 STi/MTi datasheet table (HP and rpm limits), sensor-mounting CAD on the housing, housing envelope <= 10 mm/s RMS. | - | -
C2 | Mains-powered node; SELV (<=50 V DC) IEPE excitation 24 V/4 mA over coax, AC-coupled to ADC range | COE | NOT EVIDENCED | OWNER EVIDENCE PENDING (COE) | - | - | see Specifications.md | Power tree: mains adapter -> SELV <= 50 V DC; IEPE 24 V / 4 mA constant-current source over coax, AC-coupled into the AD7606 range. | - | - | no | 0 | 3-9 depending on the owner's artifact | Power tree: mains adapter -> SELV <= 50 V DC; IEPE 24 V / 4 mA constant-current source over coax, AC-coupled into the AD7606 range. | - | -
C4 | All real-time DAQ and signal processing run on local hardware, no cloud reliance | COE (counted for ICS) | MET | MET [MEASURED host] | MET (live / measured) | 120 windows classified + RUL with all network calls blocked (DNS lookup raised) | no cloud reliance | COE-assigned in the sheet; counted for ICS by team decision 2026-10-05. Acquisition + DSP run locally in the COE pipeline (S4-S6) | - | - | yes | 7 | 9 | Repeat with the node on hardware day | [MEASURED host] (network-denied Python run) | live: up2_helpers.c4_no_network_live
C5 | Dashboard accessible only on the local network; no external/cloud exposure of vibration data | ICS | MET | MET [MEASURED host] | MET (live / measured) | 19/19 LanOnlyTests+UdpLanGuardTests pass (public HTTP clients 403, public UDP senders dropped) | LAN only | LAN guard unit tests (public HTTP clients 403, public UDP senders dropped) + Kestrel LAN bind | - | - | yes | 9 | 9 | Show a phone on the room Wi-Fi reaching the dashboard | [MEASURED host] | live: dotnet test tests/DigitalTwin.Backend.Tests
C6 | Enclosure from UV-stabilized weather-resistant polymer (ABS/PETG) | ME | NOT EVIDENCED | MET (physical, PPR Rank 9) [OWNER-SUPPLIED: ME] | MET (physical, PPR Rank 9) | physical enclosure, tested; shown at the PPR (Rank 9) | UV-stabilized ABS/PETG enclosure | ME evidence: physical prototype shown at the PPR (Rank 9); ME presents it | - | - | yes | 9 (PPR, ME) | 9 | bring the enclosure to UP2 | [OWNER-SUPPLIED: ME] | ME member, PPR (not in repo)
S1 | 2x biaxial IEPE sets (4 ch): 100 mV/g, +-50 g, flat 2-10 kHz (off-the-shelf) | ME | NOT EVIDENCED | MET (physical, PPR Rank 9) [OWNER-SUPPLIED: ME] | MET (physical, PPR Rank 9) | physical IEPE sets, tested; shown at the PPR (Rank 9) | 2x biaxial IEPE, 100 mV/g, +-50 g, flat 2-10 kHz | ME evidence: physical prototype shown at the PPR (Rank 9); ME presents it | - | - | yes | 9 (PPR, ME) | 9 | bring the sensors + datasheet to UP2 | [OWNER-SUPPLIED: ME] | ME member, PPR (not in repo)
S2 | FE digital twin identifies bearing stiffness K, <=10 % error vs known-stiffness reference | ME | NOT EVIDENCED | PARTIAL (50 %) [OWNER-SUPPLIED: ME] | - | reported 50 % complete by ME | K identified, <=10 % error | 50 % complete per ME | - | - | no | per ME artifact | 9 | finish the FE identification vs a known-stiffness case | [OWNER-SUPPLIED: ME] | ME member (not in repo)
S3 | Enclosure IP54 (IEC 60529), 85 C ambient, UV | ME | NOT EVIDENCED | PARTIAL (50 %) [OWNER-SUPPLIED: ME] | - | reported 50 % complete by ME | IP54 (IEC 60529), 85 C, UV | 50 % complete per ME | - | - | no | per ME artifact | 9 | complete the IP54 / temperature evidence | [OWNER-SUPPLIED: ME] | ME member (not in repo)
S4 | Sample rate >=25 kS/s per channel, 4 channels | COE | NOT EVIDENCED | MET [SIMULATION+CALCULATED] | MET (simulation + calculation) | 30 kS/s/ch x 4 ch, gap-free sim, 16.3 us slack | >= 25 kS/s/ch | 30 kS/s per channel from the AD7606 datasheet timing in the COE design [CALCULATED]; 4-channel DMA stream gap-free in the COE simulator | - | - | no | 3 | 9 | AD7606 bench capture on hardware day | [CALCULATED] + [SIMULATION] | live: aiengine.coe.verify.coe1; coe_verification.json (file mtime 2026-10-24 04:38)
S5 | 20-rev window processed, payload available within 333 ms | COE | NOT EVIDENCED | MET [MEASURED host + CALCULATED] | MET (simulation + calculation) | host worst 11.83 ms; STM32 pessimistic calc 28.4 ms | <= 333 ms | pipeline time on this PC [MEASURED host]; STM32 time calculated at 10 cycles/flop, 480 MHz [CALCULATED] | - | - | no | 3 | 9 | Time t20 -> payload on the STM32H755 on hardware day | [MEASURED host] + [CALCULATED] | live: aiengine.coe.verify.coe2; coe_verification.json (file mtime 2026-10-24 04:38)
S6 | AI-ready representation, fixed dimensionality and ordering, independent of speed over 1000-3600 rpm | COE | PARTIAL | MET [SIMULATION] | MET (live / measured) | 28 speeds 1000-3600 rpm -> all (32,) features / 152 B, finite | fixed dimension and ordering | below ~1465 rpm the first 4096 envelope points of the 20-rev window feed the FFT (5 of 28 swept speeds); the 1750/3600 rpm modes use the full window | - | - | yes | 6 | 9 | Same pipeline on real accelerometer data at several VFD speeds | [SIMULATION] | live: aiengine.coe.verify.coe3; coe_verification.json (file mtime 2026-10-24 04:38)
S7 | Pump-bearing RUL MAPE <=15 % on held-out degradation window (N-HiTS) | ICS | NOT MET | MET [SYNTHETIC] | MET (live / measured) | 12.64 % MAPE (strict-onset variant 14.72 %) | <= 15 % | fresh test2 predictions re-scored (Rank 6) + live ONNX subset run in 7b (Rank 9). Pre-registered window [detected onset, T_fail - 10 % of span]; true-onset variant 14.72 % | live ONNX subset (16 bearings): MAPE 13.17 % recomputed from live model outputs (Rank 9 for the subset; the 80-bearing figure is Rank 6). | 2nd fresh set synth_v3_test3 (stored report up2c_spec_check_20261024T175404Z.json, seen once): S7 10.75 %, F1 0.962, stage max 1, caught 80/80 (confirms) | gradient-boosted heads (approved change from N-HiTS/TFT for accuracy): LightGBM RUL head + causal post-process in the N-HiTS ONNX slot | N-HiTS on the same data: S7 46.9 % | yes | 9 | 9 | Fine-tune on rig run-to-failure data on hardware day | [SYNTHETIC] synth_v3_test2 | up2_v3b_gbm_20261024T114647Z.index.json re-scored live; up2_spec_check_20261024T114947Z.json (file mtime 2026-10-24 14:49)
S8 | Fault-classification inference <200 ms/window (TFT) | ICS | MET | MET [MEASURED host] | MET (live / measured) | p95 0.380 ms (engine step p95 5.20 ms) | < 200 ms | gradient-boosted classifier in the TFT ONNX contract slot; a TFT ONNX in the same slot runs in about 1.5-12 ms (PPR 11.1 ms), also < 200 ms | gradient-boosted heads (approved change from N-HiTS/TFT for accuracy) | TFT ONNX p95 1.54 ms (also < 200 ms) | yes | 9 | 9 | Repeat on the final server (laptop or Raspberry Pi 5) | [MEASURED host] latency, [SYNTHETIC] inputs | live: up2_helpers.s8_latency_live; up2_spec_check_20261024T114947Z.json (file mtime 2026-10-24 14:49)
S9 | Dashboard refresh >=10 Hz; physics RUL + AI RUL + fault ID updated together within IS1 budget | ICS | MET | MET [MEASURED host] | MET (live / measured) | 30.0 Hz client rate; worst 1-s window 29 | >= 10 Hz | SignalR client receives ~30 snapshots/s (50 ms re-broadcast timer); new data arrive at the 10 Hz replay rate; localhost, [SYNTHETIC] stream | - | - | yes | 6 | 9 | Show the dashboard on a second device on the LAN | [MEASURED host], [SYNTHETIC] stream | live: DemoMeasure rate
IS1 | Sensor -> classify+RUL -> dashboard < 500 ms | Integrated | PARTIAL | MET [SIMULATION] | MET (simulation + calculation) | p95 101.5 ms, max 105.4 ms (backend measured + Wi-Fi hop emulated 10-60 ms + STM32 leg 28.4 ms calculated) | < 500 ms | live end-to-end run (Rank 9 demo): backend [MEASURED host], Wi-Fi hop emulated at 10-60 ms [SIMULATION], STM32 leg [CALCULATED]; budget holds up to a ~456 ms hop | - | - | no | 9 | 9 | Repeat with the ESP32-C6 node on the room Wi-Fi on hardware day | [MEASURED host] + [SIMULATION] Wi-Fi + [CALCULATED] STM32 | live: DemoMeasure is1; integration_measurements_up2_v3b_20261024.md (file mtime 2026-10-24 16:32)
IS2 | Physics-AI RUL agreement (wording v2): |RUL_phys - RUL_AI| / L_ref, stages 1->3; median <=18 %, p95 <=63 % of L_ref (v1: max <=5 %) | Integrated | NOT MET | MET [SYNTHETIC]+[SIMULATION] (clarified wording v2) | MET (simulation + calculation) | median 16.3 % (<=18), p95 49.2 % (<=63) of L_ref on fresh test4 | v2: median <= 18 %, p95 <= 63 % of L_ref | clarified wording v2 (coach requested clarification); thresholds frozen on validation before test4 (scored once); six wrong-AI controls all fall outside. Method details: reports/up2d_is2_*.md | deployed v3b heads | - | no | 9 | 9 | Team updates the xlsx with wording v2; on the rig L_ref = ISO 281 rated life | [SYNTHETIC] synth_v3_test4 + [SIMULATION] FE twin | up2d_is2_20261024T225605Z.json (file mtime 2026-10-25 01:56); IS2 rank: 9 for the live subset run (deployed engine + twin), 6 for the full 80-bearing re-score of saved AI predictions
IS3 | macro-F1 >=85 % over {Healthy,OD,ID,BD,CF}; stage error <=1; any injected fault caught by stage 3 | Integrated | NOT MET | MET [SYNTHETIC] | MET (live / measured) | F1 0.959; stage max 1; caught 80/80 | F1>=0.85; stage err<=1; caught by stage 3 | fresh test2 predictions re-scored (Rank 6) + live ONNX subset run in 7b (Rank 9) | live ONNX subset (16 bearings): F1 0.963, stage max 1, caught 16/16 from live model outputs (Rank 9 for the subset). | 2nd fresh set synth_v3_test3 (stored report up2c_spec_check_20261024T175404Z.json, seen once): S7 10.75 %, F1 0.962, stage max 1, caught 80/80 (confirms) | gradient-boosted heads (approved change from N-HiTS/TFT for accuracy): XGBoost classifier + LightGBM stage head + post-process in the TFT ONNX slot | TFT on the same data: F1 0.924, stage max error 3, caught 40/40 | yes | 9 | 9 | Fine-tune on rig seeded-fault data on hardware day | [SYNTHETIC] synth_v3_test2 | up2_v3b_gbm_20261024T114647Z.index.json re-scored live; up2_spec_check_20261024T114947Z.json (file mtime 2026-10-24 14:49)
