amussab/Digital-Twin-Senior-Proj/Project architecture/ME/Enclosure CAD/out/asm_gland_cable_KPH.stl

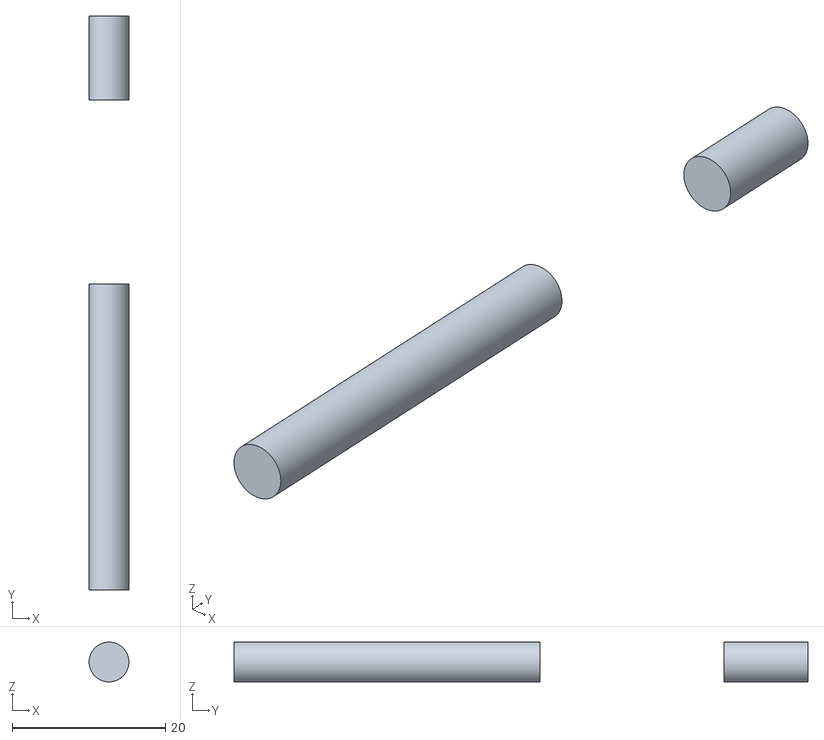
[picture p27: CAD file, 2026-11-05]
Project architecture/ME/Enclosure CAD/out/asm_gland_cable_KPH.stl
5.20 x 75.0 x 5.20
