amussab/Digital-Twin-Senior-Proj/Project architecture/ME/Enclosure CAD/out/asm_carrier_BUCK_24V_5V.stl

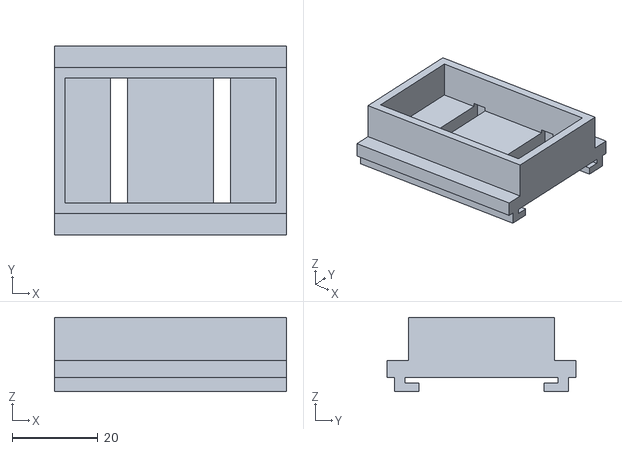
[picture p28: CAD file, 2026-11-05]
Project architecture/ME/Enclosure CAD/out/asm_carrier_BUCK_24V_5V.stl
54.0 x 44.0 x 17.3
