amussab/Digital-Twin-Senior-Proj/Project architecture/ME/Enclosure CAD/out/asm_carrier_SRD1104.stl

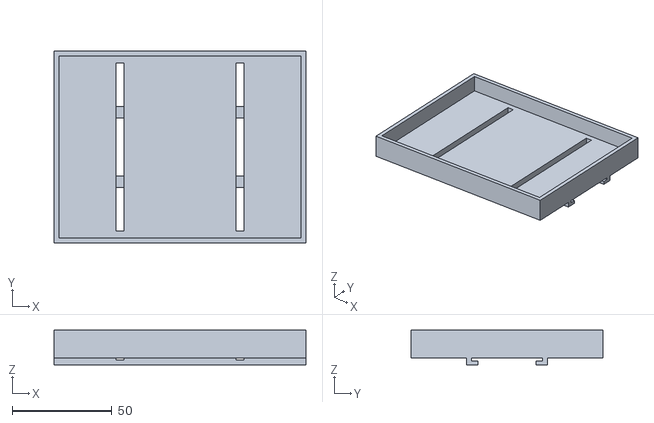
[picture p29: CAD file, 2026-11-05]
Project architecture/ME/Enclosure CAD/out/asm_carrier_SRD1104.stl
126.0 x 96.0 x 17.3
