amussab/Digital-Twin-Senior-Proj/Project architecture/ME/Enclosure CAD/out/asm_gland_ACC3.stl

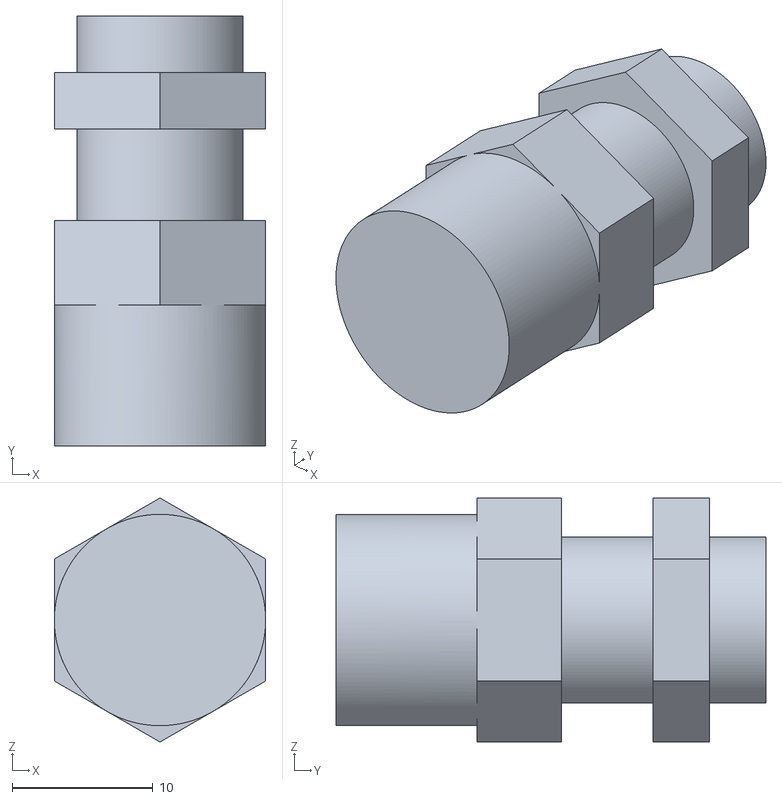
[picture p30: CAD file, 2026-11-05]
Project architecture/ME/Enclosure CAD/out/asm_gland_ACC3.stl
15.0 x 30.5 x 17.3
