amussab/Digital-Twin-Senior-Proj/Project architecture/ME/Enclosure CAD/out/asm_gland_cable_PWR24V.stl

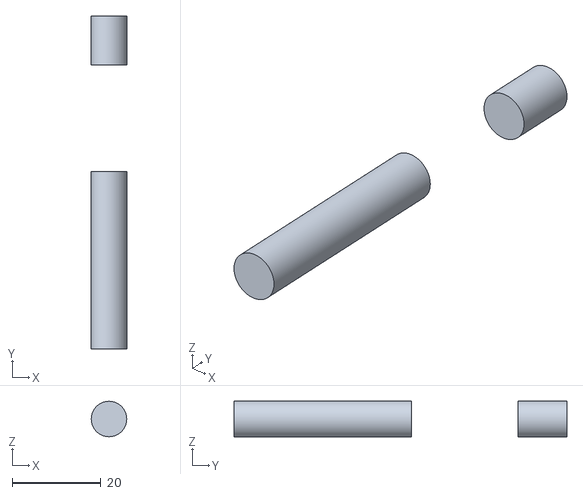
[picture p31: CAD file, 2026-11-05]
Project architecture/ME/Enclosure CAD/out/asm_gland_cable_PWR24V.stl
8.00 x 75.0 x 8.00
