amussab/Digital-Twin-Senior-Proj/Project architecture/ME/Enclosure CAD/out/asm_din_rail_A.stl

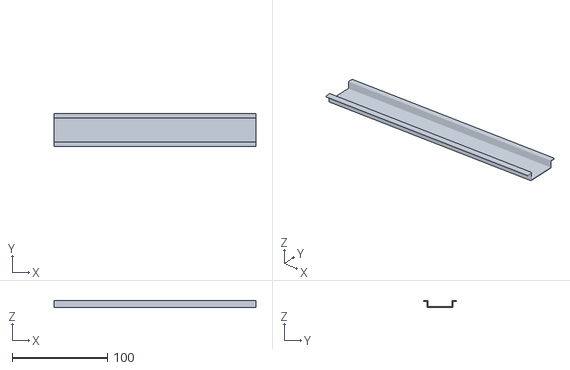
[picture p32: CAD file, 2026-11-05]
Project architecture/ME/Enclosure CAD/out/asm_din_rail_A.stl
212.0 x 35.0 x 7.50
