amussab/Digital-Twin-Senior-Proj/Project architecture/ME/Enclosure CAD/out/asm_gland_oring_ACC3.stl

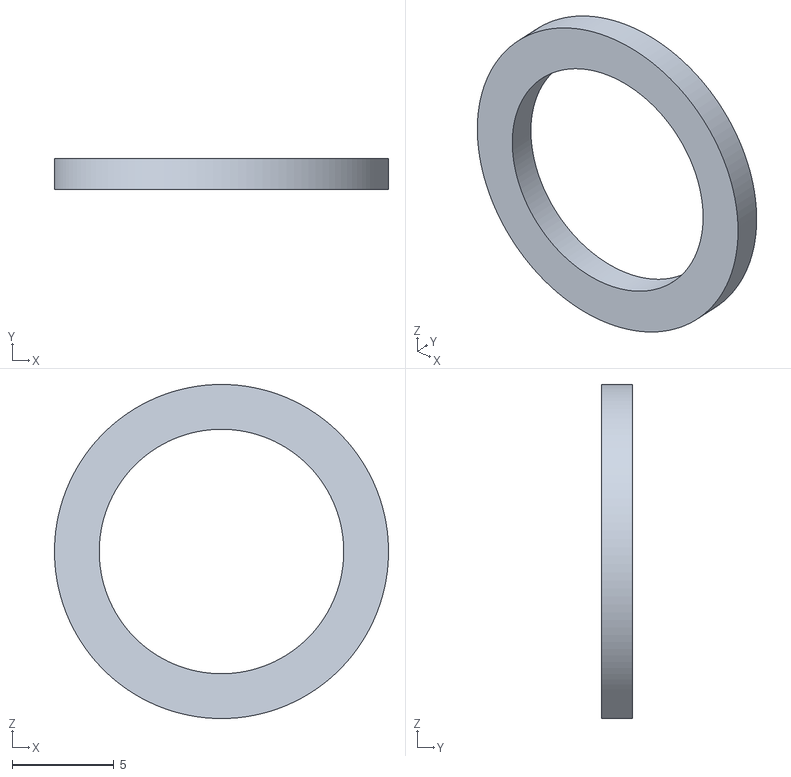
[picture p33: CAD file, 2026-11-05]
Project architecture/ME/Enclosure CAD/out/asm_gland_oring_ACC3.stl
16.4 x 1.50 x 16.4
