amussab/Digital-Twin-Senior-Proj/Project architecture/ME/Enclosure CAD/out/asm_din_rail_B.stl

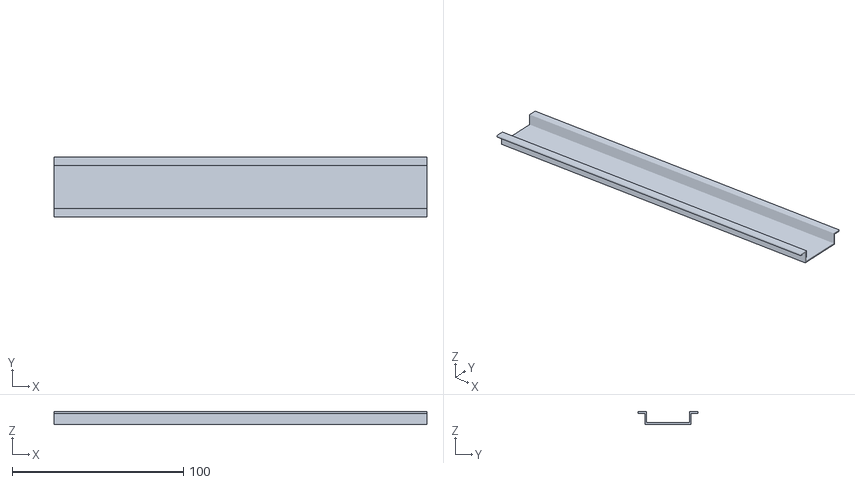
[picture p34: CAD file, 2026-11-05]
Project architecture/ME/Enclosure CAD/out/asm_din_rail_B.stl
218.0 x 35.0 x 7.50
