amussab/Digital-Twin-Senior-Proj/Project architecture/ME/Enclosure CAD/out/asm_carrier_NUCLEO_H755ZI.stl

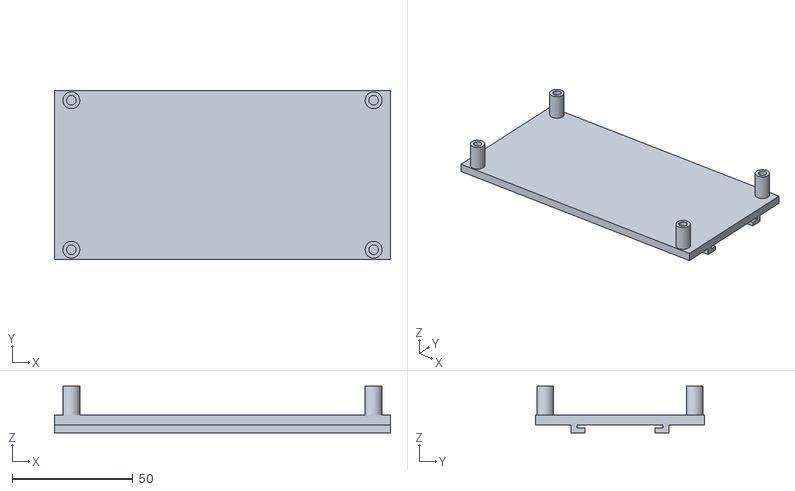
[picture p36: CAD file, 2026-11-05]
Project architecture/ME/Enclosure CAD/out/asm_carrier_NUCLEO_H755ZI.stl
139.4 x 70.0 x 19.3
