amussab/Digital-Twin-Senior-Proj/Project architecture/ME/Enclosure CAD/out/asm_io_shield.stl

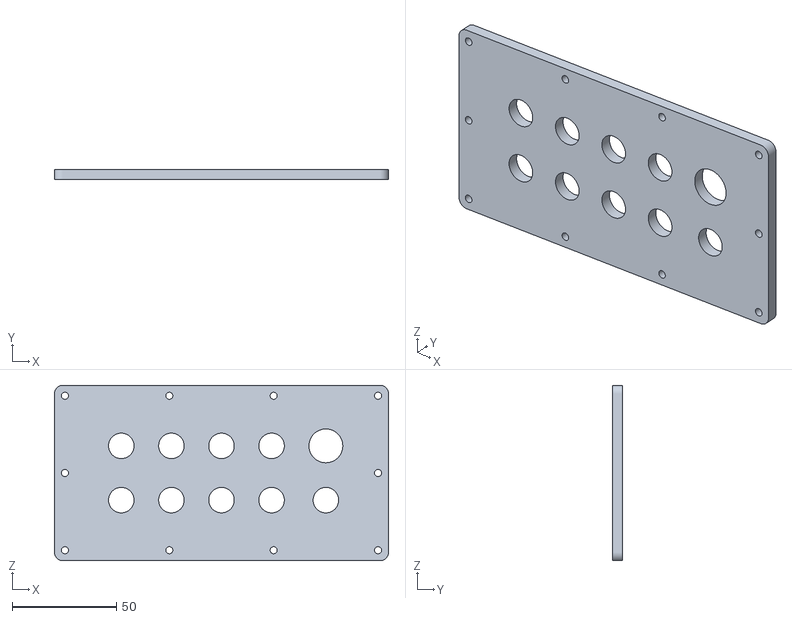
[picture p37: CAD file, 2026-11-05]
Project architecture/ME/Enclosure CAD/out/asm_io_shield.stl
160.0 x 5.00 x 84.0
