amussab/Digital-Twin-Senior-Proj/Project architecture/ME/Enclosure CAD/out/asm_av_mount_1.stl

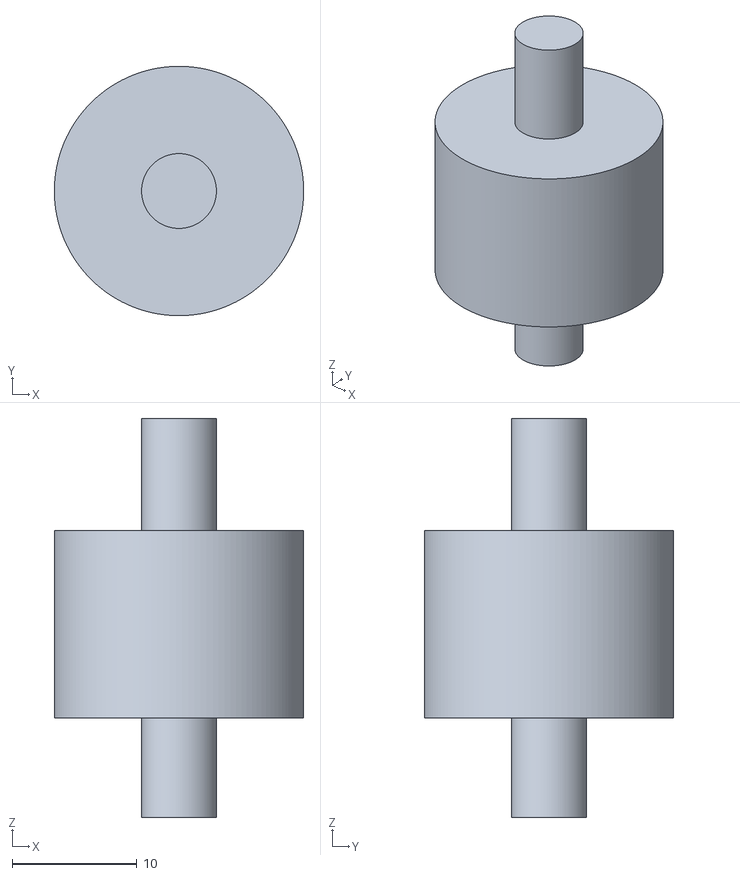
[picture p38: CAD file, 2026-11-05]
Project architecture/ME/Enclosure CAD/out/asm_av_mount_1.stl
20.0 x 20.0 x 32.0
