amussab/Digital-Twin-Senior-Proj/Project architecture/ME/Enclosure CAD/out/asm_gland_oring_PWR24V.stl

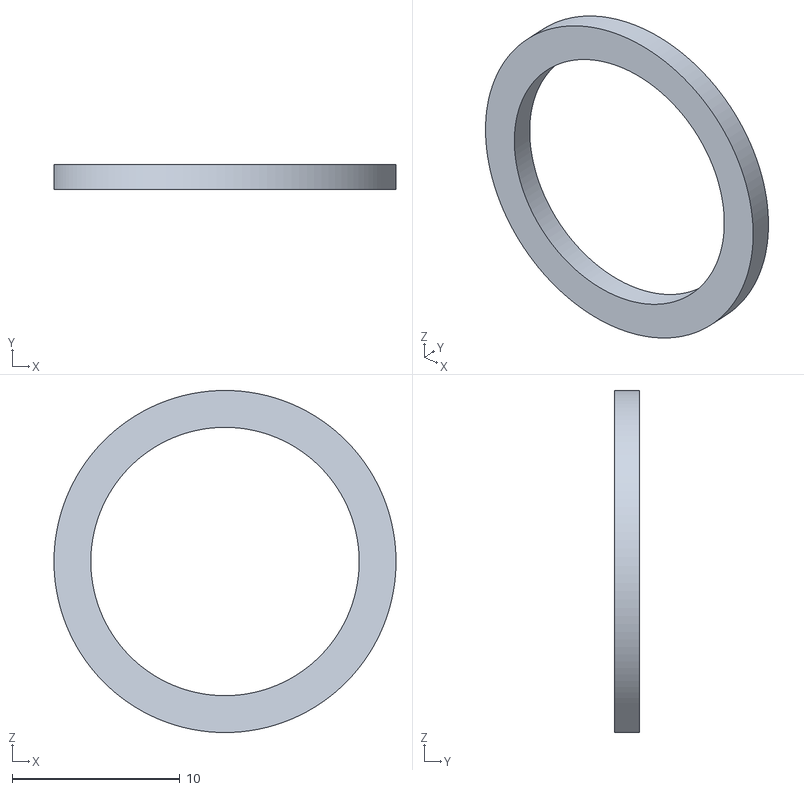
[picture p39: CAD file, 2026-11-05]
Project architecture/ME/Enclosure CAD/out/asm_gland_oring_PWR24V.stl
20.4 x 1.50 x 20.4
