amussab/Digital-Twin-Senior-Proj/Project architecture/ME/Enclosure CAD/out/asm_board_LPF_PERFBOARD.stl

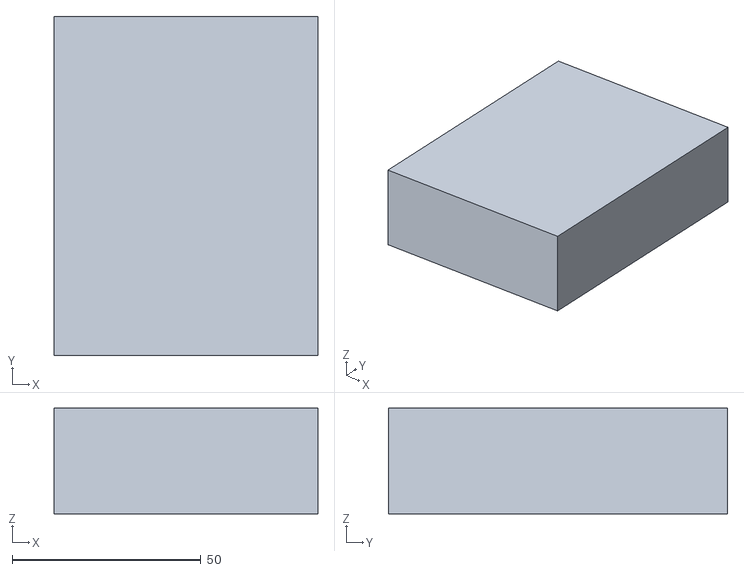
[picture p40: CAD file, 2026-11-05]
Project architecture/ME/Enclosure CAD/out/asm_board_LPF_PERFBOARD.stl
70.0 x 90.0 x 28.0
