amussab/Digital-Twin-Senior-Proj/Project architecture/ME/Enclosure CAD/out/asm_terminal_blocks.stl

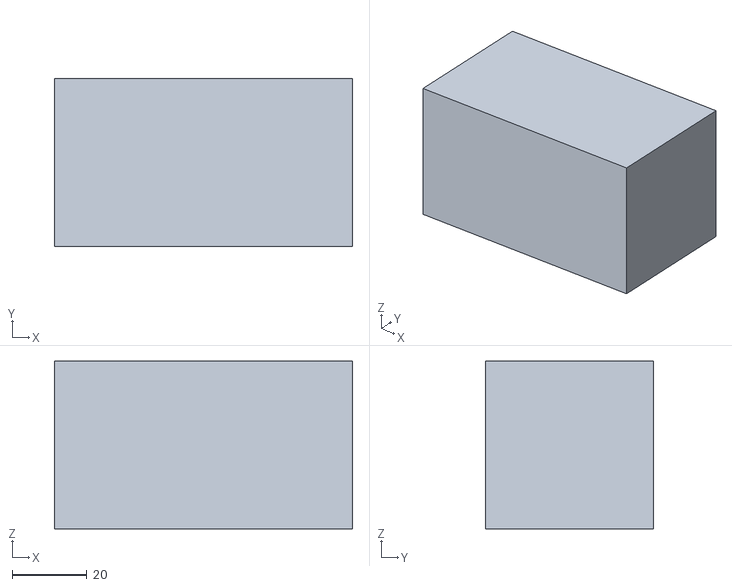
[picture p41: CAD file, 2026-11-05]
Project architecture/ME/Enclosure CAD/out/asm_terminal_blocks.stl
80.0 x 45.0 x 45.0
