amussab/Digital-Twin-Senior-Proj/Project architecture/ME/Enclosure CAD/out/carrier_AD7606.step

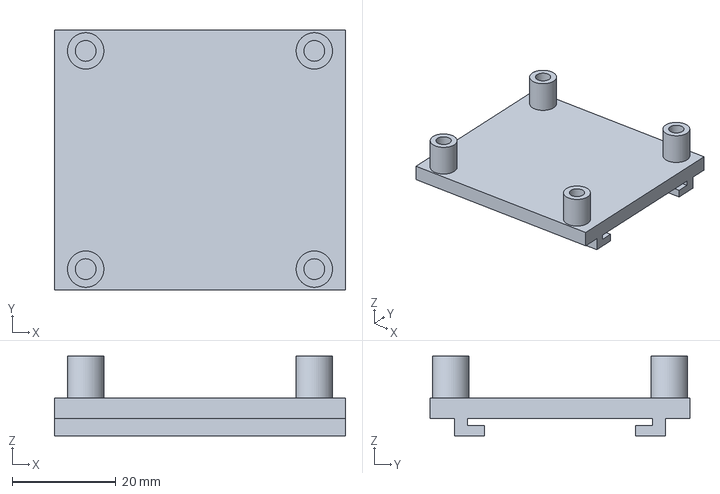
[picture p42: CAD file, 2026-11-05]
Project architecture/ME/Enclosure CAD/out/carrier_AD7606.step
56.0 x 50.0 x 15.3 mm
