amussab/Digital-Twin-Senior-Proj/Project architecture/ME/Enclosure CAD/out/carrier_LPF_PERFBOARD.step

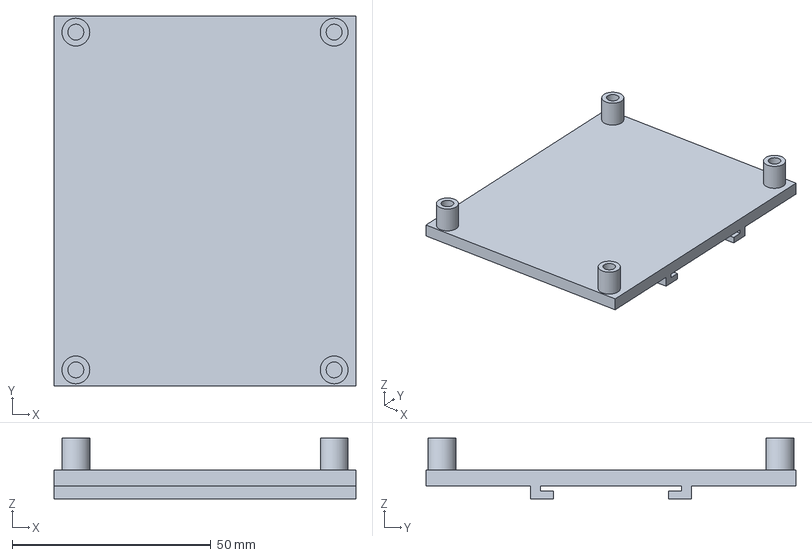
[picture p43: CAD file, 2026-11-05]
Project architecture/ME/Enclosure CAD/out/carrier_LPF_PERFBOARD.step
76.0 x 93.0 x 15.3 mm
