amussab/Digital-Twin-Senior-Proj/Project architecture/ME/Enclosure CAD/out/sec_gland_oring_KPH.stl

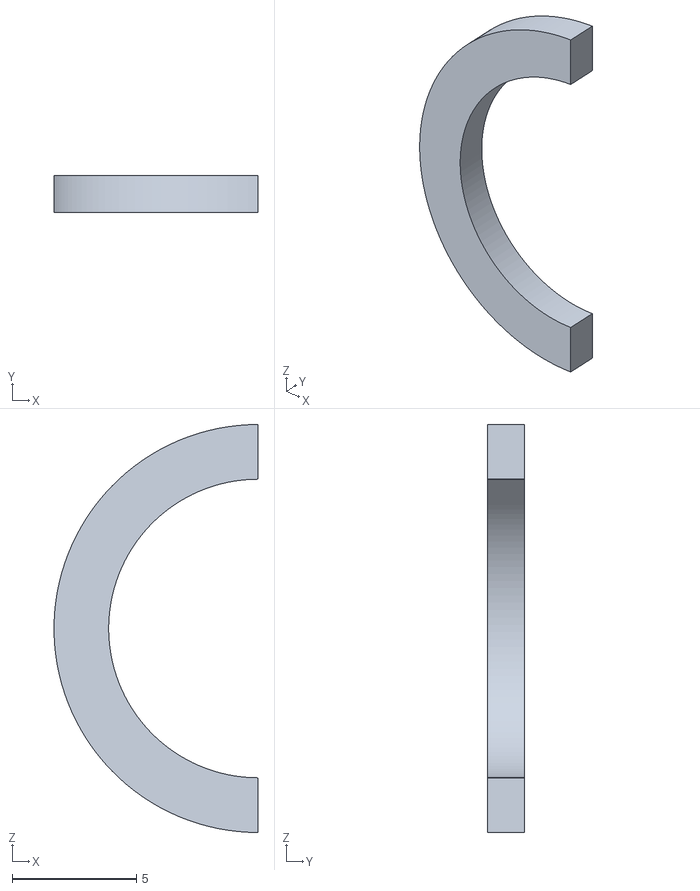
[picture p44: CAD file, 2026-11-05]
Project architecture/ME/Enclosure CAD/out/sec_gland_oring_KPH.stl
8.20 x 1.50 x 16.4
