amussab/Digital-Twin-Senior-Proj/Project architecture/ME/Enclosure CAD/out/sec_gland_cable_PROX1.stl

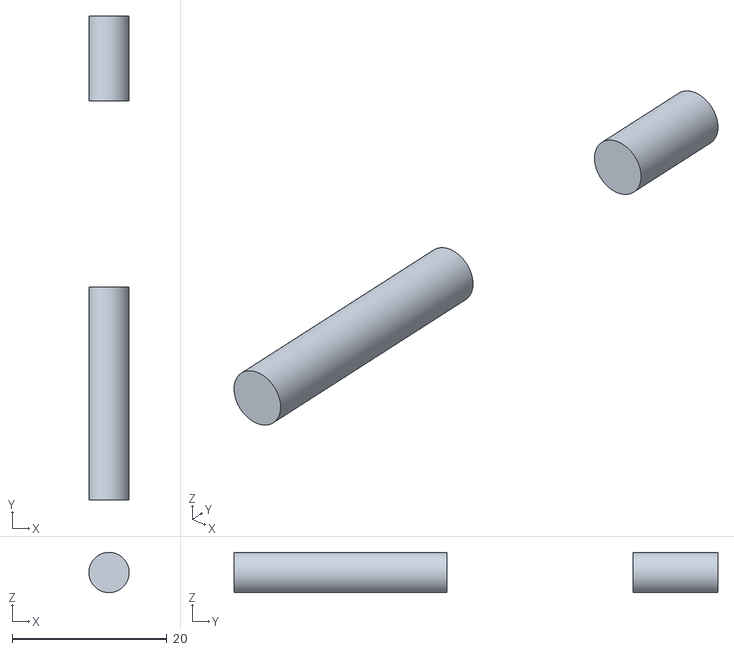
[picture p45: CAD file, 2026-11-05]
Project architecture/ME/Enclosure CAD/out/sec_gland_cable_PROX1.stl
5.20 x 62.5 x 5.20
