amussab/Digital-Twin-Senior-Proj/Project architecture/ME/Enclosure CAD/out/sec_gland_ACC3.stl

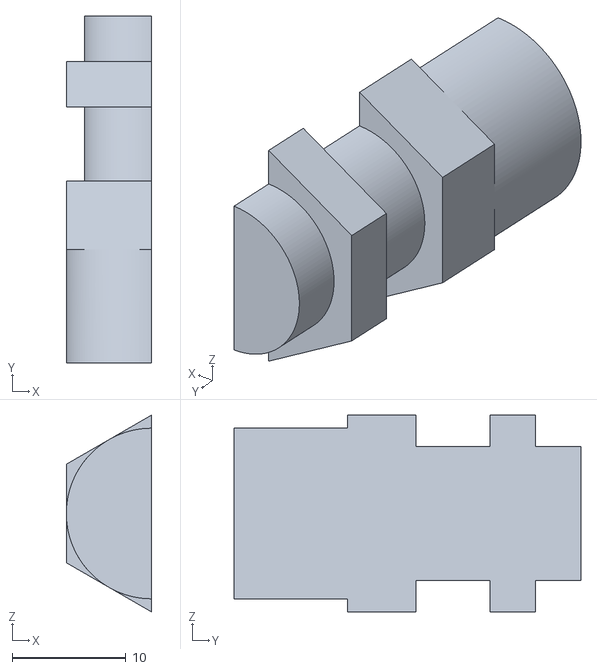
[picture p46: CAD file, 2026-11-05]
Project architecture/ME/Enclosure CAD/out/sec_gland_ACC3.stl
7.50 x 30.5 x 17.3
