amussab/Digital-Twin-Senior-Proj/Project architecture/ME/Enclosure CAD/out/sec_board_NUCLEO_H755ZI.stl

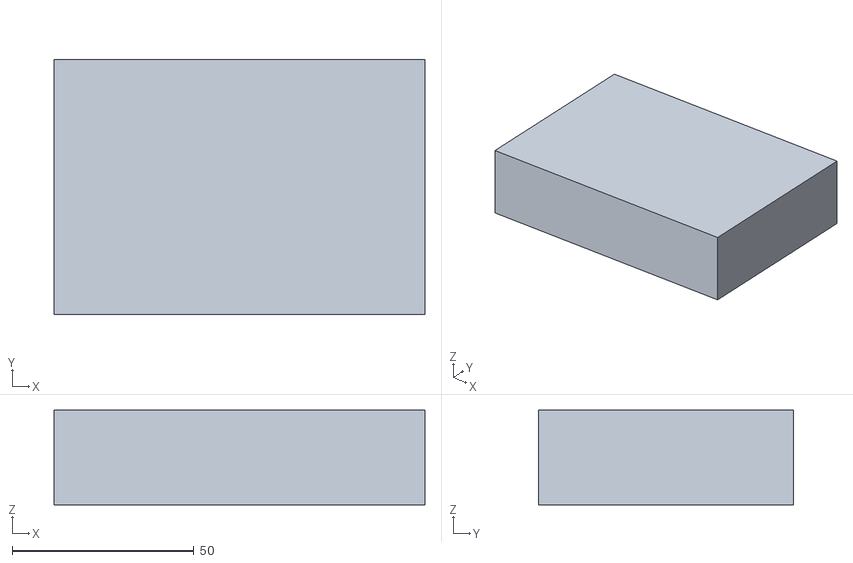
[picture p47: CAD file, 2026-11-05]
Project architecture/ME/Enclosure CAD/out/sec_board_NUCLEO_H755ZI.stl
102.0 x 70.0 x 26.0
