amussab/Digital-Twin-Senior-Proj/Project architecture/ME/Enclosure CAD/out/sec_board_BUCK_24V_5V.stl

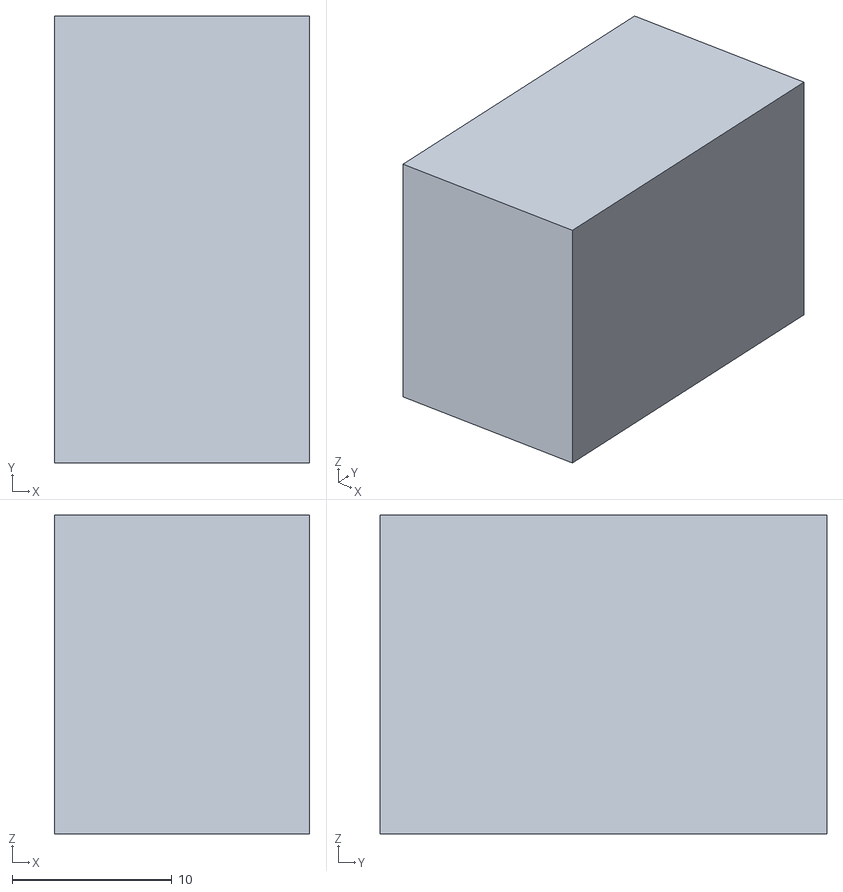
[picture p48: CAD file, 2026-11-05]
Project architecture/ME/Enclosure CAD/out/sec_board_BUCK_24V_5V.stl
16.0 x 28.0 x 20.0
