amussab/Digital-Twin-Senior-Proj/Project architecture/ME/Enclosure CAD/out/carrier_ESP32C6.step

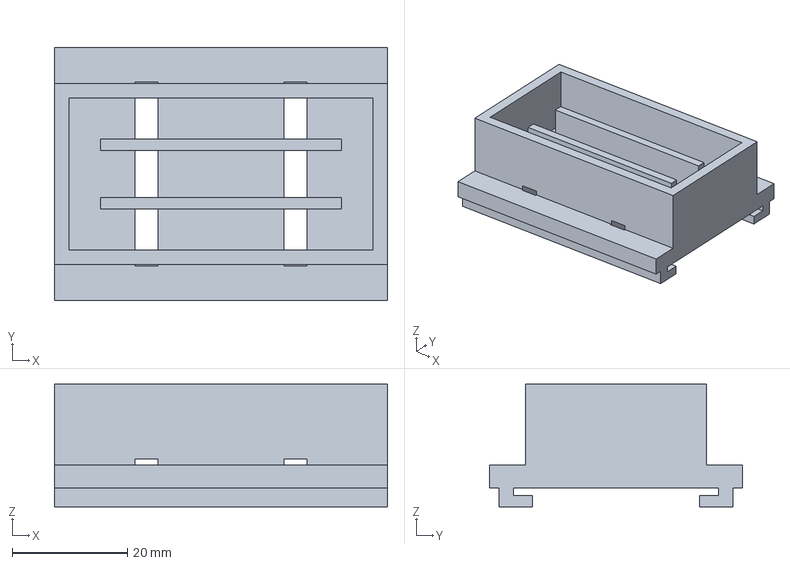
[picture p49: CAD file, 2026-11-05]
Project architecture/ME/Enclosure CAD/out/carrier_ESP32C6.step
57.8 x 44.0 x 21.3 mm
