amussab/Digital-Twin-Senior-Proj/Project architecture/ME/Enclosure CAD/out/sec_din_rail_C.stl

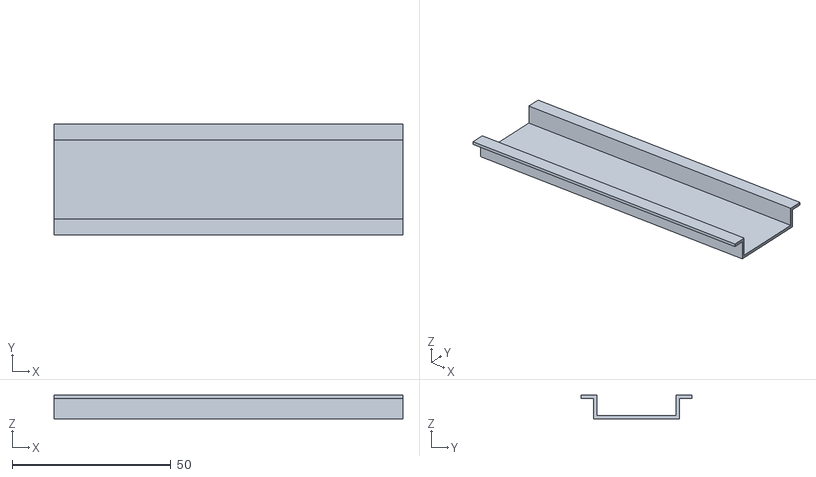
[picture p50: CAD file, 2026-11-05]
Project architecture/ME/Enclosure CAD/out/sec_din_rail_C.stl
110.0 x 35.0 x 7.50
