amussab/Digital-Twin-Senior-Proj/Project architecture/ME/Enclosure CAD/out/lid.step

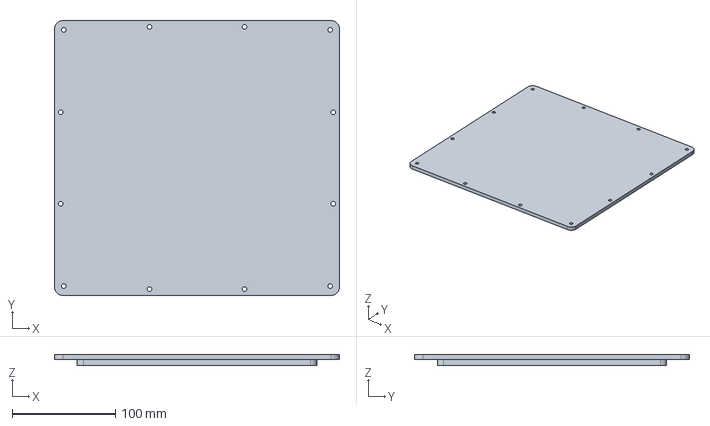
[picture p51: CAD file, 2026-11-05]
Project architecture/ME/Enclosure CAD/out/lid.step
276.0 x 266.0 x 11.0 mm
