amussab/Digital-Twin-Senior-Proj/Project architecture/ME/Enclosure CAD/out/sec_din_rail_A.stl

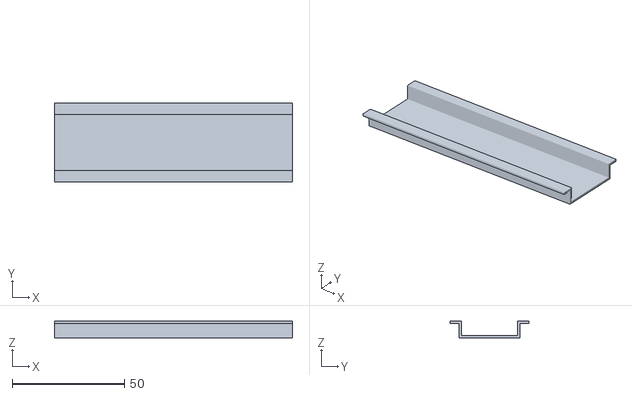
[picture p52: CAD file, 2026-11-05]
Project architecture/ME/Enclosure CAD/out/sec_din_rail_A.stl
106.0 x 35.0 x 7.50
