amussab/Digital-Twin-Senior-Proj/Project architecture/ME/Enclosure CAD/out/sec_lid.stl

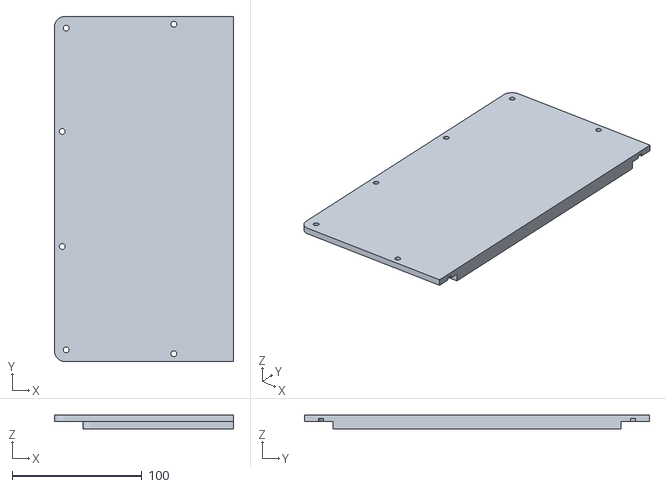
[picture p54: CAD file, 2026-11-05]
Project architecture/ME/Enclosure CAD/out/sec_lid.stl
138.0 x 266.0 x 11.0
