amussab/Digital-Twin-Senior-Proj/(list of files, cad)

Other CAD files:
Project architecture/ME/Enclosure CAD/out/asm_gland_cable_ACC2.stl
Project architecture/ME/Enclosure CAD/out/asm_gland_oring_VENT.stl
Project architecture/ME/Enclosure CAD/out/asm_gland_oring_ACC2.stl
Project architecture/ME/Enclosure CAD/out/asm_gland_oring_KPH.stl
Project architecture/ME/Enclosure CAD/out/sec_gland_ACC1.stl
Project architecture/ME/Enclosure CAD/out/sec_av_mount_4.stl
Project architecture/ME/Enclosure CAD/out/sec_gland_oring_ACC3.stl
Project architecture/ME/Enclosure CAD/out/carrier_NUCLEO_H755ZI.stl
Project architecture/ME/Enclosure CAD/out/carrier_BUCK_24V_5V.stl
Project architecture/ME/Enclosure CAD/out/sec_gland_cable_PROX2.stl
Project architecture/ME/Enclosure CAD/out/carrier_SRD1104.step
Project architecture/ME/Enclosure CAD/out/sec_gland_cable_ACC1.stl
Project architecture/ME/Enclosure CAD/out/io_shield.step
Project architecture/ME/Enclosure CAD/out/carrier_AD7606.stl
Project architecture/ME/Enclosure CAD/out/carrier_LPF_PERFBOARD.stl
Project architecture/ME/Enclosure CAD/out/io_shield.stl
Project architecture/ME/Enclosure CAD/out/lid.stl
