amussab/Digital-Twin-Senior-Proj/Project architecture/ME/Enclosure CAD/out/install.gif

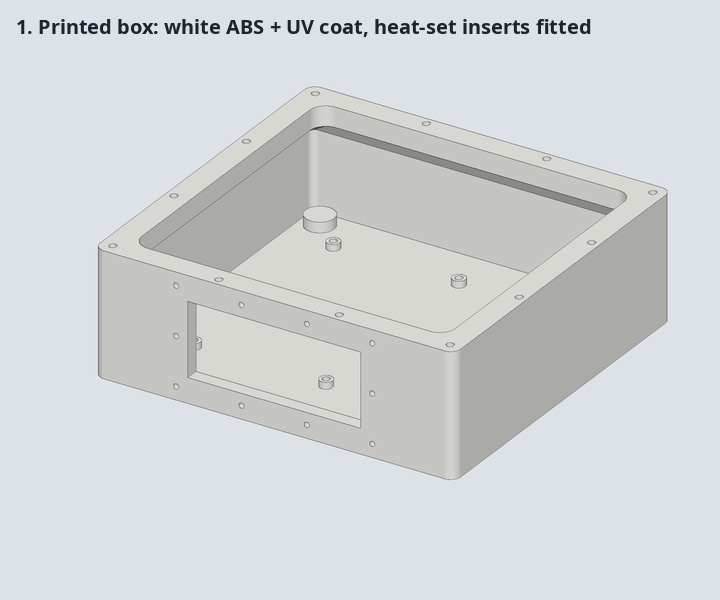
Project architecture/ME/Enclosure CAD/out/install.gif
