amussab/Digital-Twin-Senior-Proj/Project architecture/ME/Enclosure CAD/out/install_steps.png

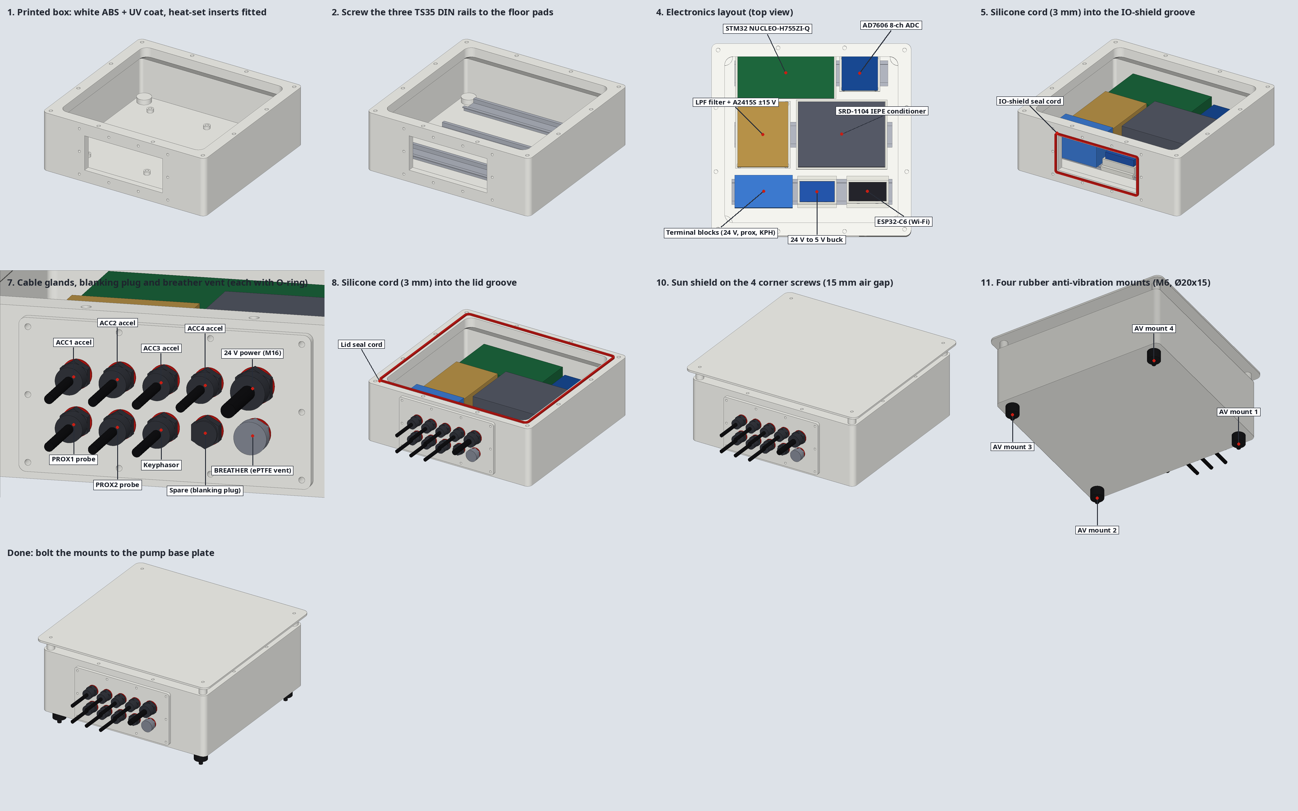
Project architecture/ME/Enclosure CAD/out/install_steps.png
