amussab/Digital-Twin-Senior-Proj/COE/firmware/stm32/CM7/TestData/results/live/filter_response.png

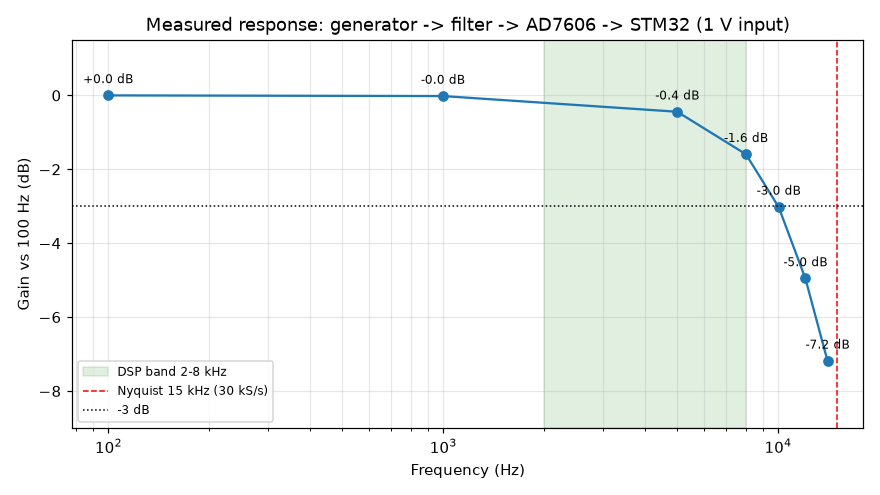
COE/firmware/stm32/CM7/TestData/results/live/filter_response.png
