amussab/Digital-Twin-Senior-Proj/evidence/up2_figures/tests.png

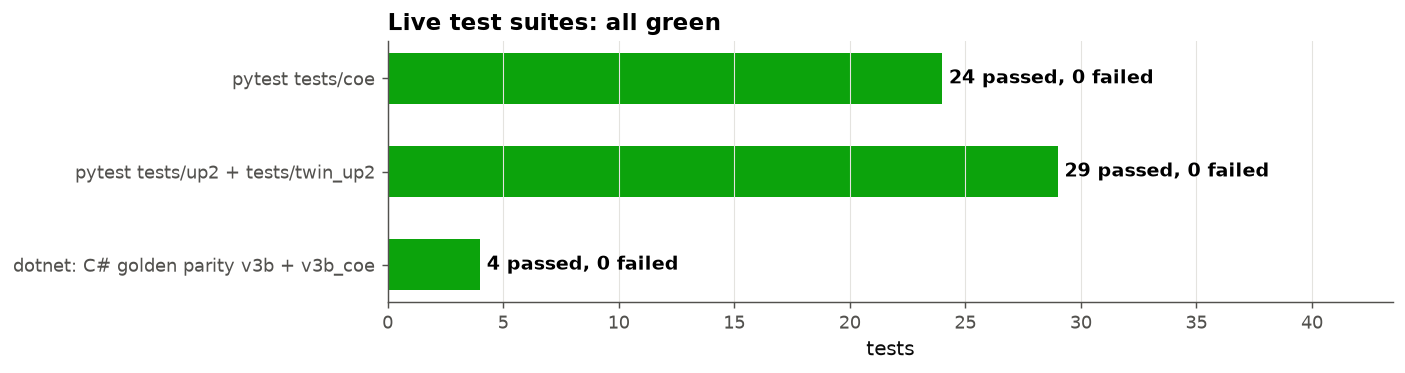
evidence/up2_figures/tests.png
