amussab/Digital-Twin-Senior-Proj/COE/firmware/stm32/CM7/Core/Src/main.c

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
/* Includes ------------------------------------------------------------------*/
#include "main.h"

/* USER CODE BEGIN Includes */
#include "firmware_mode.h"
#include "processing_clock.h"
#include "ad7606_pins.h"
#if COE_FIRMWARE_MODE == COE_MODE_REPLAY
#include "time_features_demo.h"
#include "bandpass_demo.h"
#include "envelope_demo.h"
#include "final_features_demo.h"
#include "pipeline_demo.h"
#include "pipeline_batch_demo.h"
#include "feature_uart.h"
#include "communication_demo.h"
#elif COE_FIRMWARE_MODE == COE_MODE_LIVE_RAW
#include "raw_monitor.h"
#elif COE_FIRMWARE_MODE == COE_MODE_LIVE
#include "feature_uart.h"
#include "live_stream.h"
#endif

/* USER CODE END Includes */

/* USER CODE BEGIN PD */

/* DUAL_CORE_BOOT_SYNC_SEQUENCE: Define for dual core boot synchronization    */
/*                             demonstration code based on hardware semaphore */
/* This define is present in both CM7/CM4 projects                            */
/* To comment when developping/debugging on a single core                     */
#define DUAL_CORE_BOOT_SYNC_SEQUENCE

#if defined(DUAL_CORE_BOOT_SYNC_SEQUENCE)
#ifndef HSEM_ID_0
#define HSEM_ID_0 (0U) /* HW semaphore 0*/
#endif
#endif /* DUAL_CORE_BOOT_SYNC_SEQUENCE */

/* USER CODE END PD */


COM_InitTypeDef BspCOMInit;

void SystemClock_Config(void);
static void MX_GPIO_Init(void);
/**
  * @brief  The application entry point.
  * @retval int
  */
int main(void)
{

/* USER CODE BEGIN Boot_Mode_Sequence_0 */
#if defined(DUAL_CORE_BOOT_SYNC_SEQUENCE)
  int32_t timeout;
#endif /* DUAL_CORE_BOOT_SYNC_SEQUENCE */
/* USER CODE END Boot_Mode_Sequence_0 */

/* USER CODE BEGIN Boot_Mode_Sequence_1 */
#if defined(DUAL_CORE_BOOT_SYNC_SEQUENCE)
  /* Wait until CPU2 boots and enters in stop mode or timeout*/
  timeout = 0xFFFF;

  while((__HAL_RCC_GET_FLAG(RCC_FLAG_D2CKRDY) != RESET) && (timeout-- > 0));
  if ( timeout < 0 )
  {
  Error_Handler();
  }
#endif /* DUAL_CORE_BOOT_SYNC_SEQUENCE */ 
/* USER CODE END Boot_Mode_Sequence_1 */
  /* MCU Configuration--------------------------------------------------------*/

  /* Reset of all peripherals, Initializes the Flash interface and the Systick. */
  HAL_Init();

  /* USER CODE BEGIN Init */
  /* Keep frequently executed instructions in the Cortex-M7 instruction cache. */
  SCB_EnableICache();
  /* Reset leaves the ADC pins in analog mode: make them safe at once. */
  ad7606_pins_hold_safe();
  /* USER CODE END Init */

  /* Configure the system clock */
  SystemClock_Config();
/* USER CODE BEGIN Boot_Mode_Sequence_2 */
/* Raise the processing clock before releasing the second core. */
if (!configure_processing_clock())
{
  Error_Handler();
}
#if defined(DUAL_CORE_BOOT_SYNC_SEQUENCE)
/* When system initialization is finished, Cortex-M7 will release Cortex-M4 by means of
HSEM notification */
/*HW semaphore Clock enable*/
__HAL_RCC_HSEM_CLK_ENABLE();
/*Take HSEM */
HAL_HSEM_FastTake(HSEM_ID_0);
/*Release HSEM in order to notify the CPU2(CM4)*/
HAL_HSEM_Release(HSEM_ID_0,0);
/* wait until CPU2 wakes up from stop mode */
timeout = 0xFFFF;
while((__HAL_RCC_GET_FLAG(RCC_FLAG_D2CKRDY) == RESET) && (timeout-- > 0));
if ( timeout < 0 )
{
Error_Handler();
}
#endif /* DUAL_CORE_BOOT_SYNC_SEQUENCE */
/* USER CODE END Boot_Mode_Sequence_2 */

  /* Initialize all configured peripherals */
  MX_GPIO_Init();
  /* Initialize leds */
  BSP_LED_Init(LED_GREEN);
  BSP_LED_Init(LED_YELLOW);
  BSP_LED_Init(LED_RED);

  /* Initialize USER push-button, will be used to trigger an interrupt each time it's pressed.*/
  BSP_PB_Init(BUTTON_USER, BUTTON_MODE_EXTI);

  /* Initialize COM1 port (115200, 8 bits (7-bit data + 1 stop bit), no parity */
  BspCOMInit.BaudRate   = 115200;
  BspCOMInit.WordLength = COM_WORDLENGTH_8B;
  BspCOMInit.StopBits   = COM_STOPBITS_1;
  BspCOMInit.Parity     = COM_PARITY_NONE;
  BspCOMInit.HwFlowCtl  = COM_HWCONTROL_NONE;
  if (BSP_COM_Init(COM1, &BspCOMInit) != BSP_ERROR_NONE)
  {
    Error_Handler();
  }

  /* Infinite loop */
  /* USER CODE BEGIN WHILE */
#if COE_FIRMWARE_MODE == COE_MODE_REPLAY
  if (!feature_uart_init())
    Error_Handler();
  run_communication_demo();
  run_time_features_demo(); /* Runs once, after board initialization. */
  run_bandpass_demo();
  run_envelope_demo();
  run_final_features_demo();
  run_pipeline_demo();
  run_pipeline_batch_demo();
  uint32_t led_tick = HAL_GetTick();
#elif COE_FIRMWARE_MODE == COE_MODE_LIVE_RAW
  raw_monitor_init(); /* B1 starts acquisition once the ADC is powered. */
#elif COE_FIRMWARE_MODE == COE_MODE_LIVE
  if (!feature_uart_init() || !live_stream_init())
    Error_Handler();
#endif
  while (1)
  {

    /* USER CODE END WHILE */

    /* USER CODE BEGIN 3 */
#if COE_FIRMWARE_MODE == COE_MODE_REPLAY
    feature_uart_process();
    poll_communication_replay();
    if ((uint32_t)(HAL_GetTick() - led_tick) >= 100U)
    {
      BSP_LED_Toggle(LED_GREEN);
      led_tick = HAL_GetTick();
    }
    HAL_Delay(1);
#elif COE_FIRMWARE_MODE == COE_MODE_LIVE_RAW
    raw_monitor_poll();
#elif COE_FIRMWARE_MODE == COE_MODE_LIVE
    feature_uart_process();
    live_stream_poll();
#endif
  }
  /* USER CODE END 3 */
}





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
