amussab/Digital-Twin-Senior-Proj/COE/firmware/stm32/coe_firmware.ioc

Mcu.UserName=STM32H755ZITx
PA1.Signal=ETH_REF_CLK
PA11.Signal=USB_OTG_FS_DM
PA12.Signal=USB_OTG_FS_DP
PA2.Signal=ETH_MDIO
PA7.Signal=ETH_CRS_DV
PA8.Signal=USB_OTG_FS_SOF
PA9.Signal=USB_OTG_FS_VBUS
PB13.Signal=ETH_TXD1
PC1.Signal=ETH_MDC
PC4.Signal=ETH_RXD0
PC5.Signal=ETH_RXD1
PD10.GPIO_Label=USB_OTG_FS_PWR_EN
PD10.Signal=GPIO_Output
PD8.Signal=USART3_TX
PD9.Signal=USART3_RX
PG11.Signal=ETH_TX_EN
PG13.Signal=ETH_TXD0
PG7.GPIO_Label=USB_OTG_FS_OVCR
PG7.Signal=GPXTI7
