amussab/Digital-Twin-Senior-Proj/COE/firmware/stm32/CM7/Core/Inc/main.h

#define USB_OTG_FS_PWR_EN_Pin GPIO_PIN_10
#define USB_OTG_FS_PWR_EN_GPIO_Port GPIOD
#define USB_OTG_FS_OVCR_Pin GPIO_PIN_7
#define USB_OTG_FS_OVCR_GPIO_Port GPIOG
