amussab/Digital-Twin-Senior-Proj/COE/firmware/stm32/CM7/App/acquisition/live_stream.h

/**
 * @file live_stream.h
 * LIVE mode: AD7606 blocks -> scaling -> pipeline -> 160-byte packets on
 * USART2 to the ESP32. DSP runs in the main loop, never in an interrupt.
 * Any acquisition gap discards the window in progress and restarts the
 * pipeline, so a window never spans missing samples.
 */
#ifndef COE_LIVE_STREAM_H
#define COE_LIVE_STREAM_H

#include <stdbool.h>
#include <stdint.h>
#include "pipeline_config.h"

/* Watch variables (counters restart at each B1 start). */
extern volatile bool live_calibrated;          /* All four volts-per-g values set. */
extern volatile uint32_t live_windows;         /* Completed windows. */
extern volatile uint32_t live_packets_queued;  /* Accepted by feature_uart_send. */
extern volatile uint32_t live_packets_withheld; /* Not sent: uncalibrated. */
extern volatile uint32_t live_packet_failures; /* Refused by the UART queue. */
extern volatile uint32_t live_discarded_blocks; /* Dropped around acquisition gaps. */
extern volatile uint32_t live_restarts;        /* Pipeline restarts after gaps/errors. */
extern volatile uint32_t live_pipeline_errors;
extern volatile float live_max_block_ms;       /* Longest pipeline_process_block call. */
extern volatile float live_dsp_load_percent;   /* DSP time / real time, latest second. */
extern volatile float live_last_rms[COE_CHANNEL_COUNT]; /* Band-pass RMS, latest window. */
/* S2: ms from the newest sample of the window's last block to features ready. */
extern volatile float live_last_window_latency_ms;
extern volatile float live_max_window_latency_ms;

/** Initialize the pipeline and print the banner. feature_uart_init() first. */
bool live_stream_init(void);

/** Call continuously from the main loop. */
void live_stream_poll(void);

#endif
