amussab/Digital-Twin-Senior-Proj/COE/firmware/stm32/CM7/TestData/communication/host/feature_payload.h

/* Host-test stand-in for payload sizes; DSP headers are unnecessary here. */
#ifndef HOST_FEATURE_PAYLOAD_H
#define HOST_FEATURE_PAYLOAD_H
#include <stdbool.h>
#include <stdint.h>
#define COE_PAYLOAD_BYTES 160U
#define COE_FEATURE_COUNT 32U
#endif
