amussab/Digital-Twin-Senior-Proj/(commit log)

2026-09-14 feat: add AI models test application to check spec results
    [detection_per_run.csv]
2026-09-14 Add initial Blazor dashboard with pump visualization
2026-10-04 chore: add coordinator context, spec sheet copy, rules, agents, AI-engine design contract
    - Project architecture/overview/Specifications.md: markdown copy of the team spec xlsx
    - .claude/FACTS.md fact block, evidence-strength ladder rule (PPR 0-9), path-scoped rules
    - .claude/agents: data, ml, backend, digital-twin engineers + evidence reviewer
    - AI-engine/DESIGN.md: interface contract, schema, pre-registered S7 metric
    - ICS External Datasets §5: dataset selection (XJTU-SY, IMS, MaFaulDa)
    [252-Specifications-TEAM M001.xlsx]
2026-10-04 fix(backend): broadcast at 20 Hz nominal so measured rate clears S9 10 Hz floor
    Windows timer granularity stretched the 100 ms PeriodicTimer to 9.97 Hz
    measured, failing the rate test intermittently.
2026-10-04 feat(ai-engine): hybrid N-HiTS + TFT engine pipeline (per-bearing), synthetic smoke run
    Data adapters (XJTU-SY, IMS, MaFaulDa, synthetic rig), per-bearing features,
    causal onset/stage labels, frozen bearing-level splits, LOBO model selection,
    RUL estimators, spec evaluation with pre-registered S7 metric, ONNX export with
    parity checks + contract + golden vectors, HybridEngine runtime, CLI.
    All reported numbers so far are SYNTHETIC; real-data training pending.
2026-10-04 Add interactive 3D pump and bearing fault alerts
2026-10-04 feat(ai-engine): real-data training on XJTU-SY + IMS, frozen splits, LOBO robustness, real export
    MEASURED on public bearings (not rig): S8 11.4 ms PASS, IS1 ICS leg 14.8 ms PASS,
    S7 259.5% FAIL, IS3a macro-F1 0.566 FAIL. Onset rule tuned on XJTU train+val only.
    demo_payloads.bin replays held-out Bearing2_5 run-to-failure.
    [app.py, evaluate.py, train.py]
2026-10-04 wip(integration): partial wiring of twin + SignalR data source (unverified)
2026-10-04 feat(backend): real per-bearing ONNX engine (contract v2), golden parity, replay source switch, per-bearing alerts
    Port features.py/labels.py/rul.py to C#, drive TFT + N-HiTS from model_contract.json,
    golden_vectors parity test runs and passes. Replay defaults to demo_payloads.bin.
    Snapshot gains Bearing1Fault/Bearing2Fault (null = healthy) to match the dashboard record.
2026-10-05 feat(ai-engine): MaFaulDa adapter rpm fallback; IS3 v2 hierarchical/class-weight LOBO study
    MaFaulDa: tach crossing count over-counts on noisy faulted records; use the
    dataset's filename rotation frequency when they disagree by >5% (89 records).
    LOBO over XJTU train+val (7 variants, 10 folds each): best flat_p025 macro-F1
    0.581 vs v1 config; cage F1 0 in all variants (only 2 cage bearings in XJTU).
    Claude-Session: https://claude.ai/code/session_01Lr85vREePLJ8pYyLjwoEaj
2026-10-05 feat(ai-engine): classification v2 with MaFaulDa (seeded ball/cage/outer)
    Frozen MaFaulDa splits (26 groups x 5 contiguous speed blocks), selection on
    validation only (enc 4, class-weight power 0.5, onset gate on RTF units;
    val macro-F1 0.917). Test scored once as real_v2 (second look at XJTU/IMS
    test bearings, disclosed): 5-class macro-F1 0.581 (MaFaulDa 0.848, XJTU
    0.450, IMS 0.679) FAIL; S8 11.1 ms PASS; IS1 ICS leg 14.4 ms PASS.
    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
    [app.py, evaluate.py, train.py]
2026-10-05 feat(integration): port v2 onset-gate decision to C#, merge v2 models, re-measure S9/IS1
    Golden parity passes with the v2 contract (rtf_onset_gate). Measured loopback:
    30 Hz snapshots (S9), UDP->client p95 31.8 ms (IS1), TFT p95 31.7 ms (S8).
    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
2026-10-05 feat(ai-engine): PPR ICS evidence notebook, executed, with HTML export
    Live, recomputed scorecard for the PPR (Rank 9 when run; saved outputs = Rank 7):
    C4 offline AI path under a socket block, C5 LanOnlyTests + bind/guard excerpt + live
    loopback 200, S8 TFT ONNX timing, raw XJTU-SY CSV -> DSP -> payload (byte-identical to
    demo_payloads.bin) -> HybridEngine, independent S7/IS3 re-scoring asserted against the
    stored reports, live backend S9/IS1 via DemoMeasure, IS2 twin-sim residual, C#/Python/
    PyTorch parity. Run-All about 3.7 min. No model code, models or report numbers changed.
    Claude-Session: https://claude.ai/code/session_01Lr85vRE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
2026-10-05 perf(backend): warm up ONNX sessions at startup; re-measure IS1 host leg
    First-call ONNX initialisation removed (warm-up 18 ms). UDP->client latency with ONNX
    active: p95 30 ms, max 39.8 ms (was 49-178 ms max). 32/32 tests pass.
    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
2026-10-05 docs: report IS1 host-leg max as the observed range (36-61 ms), budget on the worst case
    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
2026-10-05 docs(evidence): time N-HiTS and the full hybrid per window live; README rows
    S8 stays TFT (spec wording). Added supporting evidence for the hybrid:
    N-HiTS ONNX p95 0.6-0.8 ms; full per-window features+TFT+N-HiTS+RUL (Python
    reference) p95 15-16 ms, 99.8% of windows < 200 ms, one 240-260 ms stall
    outside the model calls, reported as-is. Deployed C# host leg incl. both
    models max 36-61 ms.
    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
2026-10-05 docs(evidence): dataset section (sources, sizes, classes, splits, lifetimes) and metric tables
    Reviewer request: §1b datasets computed live from disk (37.6 GB raw, 27,580
    windows, 1,188 units); §6b per-bearing values behind S7 (reproduces 281.8 %);
    §7b metric definitions + per-class TP/FP/FN/TN, precision, recall, F1
    (reproduces macro-F1 0.581; MaFaulDa 0.848), stage-error distribution.
    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
2026-10-06 WELCOME YOUR MASTER, KIDS
    [asm_av_mount_1.stl, asm_av_mount_2.stl, asm_av_mount_3.stl, asm_av_mount_4.stl, asm_board_AD7606.stl, asm_board_BUCK_24V_5V.stl, asm_board_ESP32C6.stl, asm_board_LPF_PERFBOARD.stl]
2026-10-24 chore(up2): UP2 rules, fact block, resume ledger
2026-10-24 feat(coe): streaming COE pipeline, sample sources, UDP sender CLI
2026-10-24 feat(up2): synth_v3 SYNTHETIC run-to-failure generator, run-level splits frozen (splits.json synth_v3)
    Physics-informed 2-bearing x biaxial generator at the 32-feature payload level; magnitudes
    calibrated to XJTU-SY end-of-life envelope ratio. AIENGINE_DATA_DIR read-only data override.
2026-10-24 docs(up2): COE step 1 verification reports and ledger
2026-10-24 docs(up2): ledger log for ML steps 2-3 (not ticked: S7, IS3b fail on synthetic test)
2026-10-24 docs(up2): ledger log after first v3 pass
2026-10-24 feat(up2): v3b stage head re-selected on validation only (z_cut -0.25, k=1; val max err 1) [SYNTHETIC]
    Validation runs only (synth_v3 val + synth_v3_val2); test2 untouched. Val stage MAE rises
    0.125 -> 0.380 in exchange for 0 windows with error >= 2 (was 10).
2026-10-24 feat(up2): v3b RUL post-process re-selected on validation after stage change; contract postprocess gets a type key [SYNTHETIC]
    Selected: log_l2 x1, alpha 0.5, scale 1.00 (stage<=2) / 0.97 (stage>=3); val S7 12.10 %.
2026-10-24 feat(up2): v3b single scoring pass; fresh test2 S7 12.64 %, F1 0.959, stage max 1, caught 80/80 [SYNTHETIC]
    test2 (synth_v3_test2, 100 fresh runs) first and only look; old synth_v3 test second look
    (S7 14.73, F1 0.961, stage max 1, 40/40). Heads selected on validation runs only.
2026-10-24 feat(up2): export v3b ONNX + model_contract_v3b.json (postprocess block) + golden with inputs_full; tests [SYNTHETIC]
    Parity on test2 units: cls prob diff 3.9e-7, 0 argmax mismatch; RUL rel diff 2.4e-3 (float32 tree
    thresholds), z 1.1e-3, 0 stage mismatch. Engine vs offline: 1.3e-5, 0 stage mismatch.
    v3b_rul.onnx is 10.2 MB (above the 2 MB guideline; v3_rul.onnx 6.0 MB was already tracked).
    tests/up2: 21 pass.
2026-10-24 feat(up2): C# v3b post-process (stage median + RUL log-EMA + stage scale) driven by contract; golden parity 28 cases [SYNTHETIC]
2026-10-24 feat(up2): dashboard health stage (1-6) in snapshot + UI; demo scripts default to v3b contract [SYNTHETIC]
2026-10-24 docs(up2): v3b IS1/S9 re-measurement, dashboard screenshot with stage, ledger step 5 [SYNTHETIC]
2026-10-24 docs(up2): ledger resume notes before shutdown
2026-10-24 feat(up2c): export v3c ONNX + contract (physics_features, postprocess) + golden; spec check on fresh test3; ledger [SYNTHETIC]
2026-10-24 docs(up2): ledger ticks after verified S7/IS3, review and push
2026-10-24 wip(coe-adapt): fix map eligibility check (map also applies to synth inputs); run-1 val selection record; ledger resume notes (paused) [SIMULATION]
2026-10-24 feat(coe-adapt): COE-val selection (mix_w0.6 + cross-bearing gate), single COE-test pass, v3b_coe classifier ONNX + contract 3b-coe + golden (rig_stream) [SIMULATION]
    COE-test macro-F1 0.584 -> 0.875, bearing-2 false-fault 82.1 % -> 0.6 %; stage head unchanged and not usable on COE features (documented).
2026-10-24 docs(up2): final evidence notebook re-execution (0 errors), ledger
2026-10-24 docs(up2): ledger - IS2 wording v2 passes on fresh test4 (step 4)
2026-10-24 docs(up2): ledger final
2026-11-05 docs(coe): update COE docs to the built system
    - LPF: replace the 4th-order MFB design with the built 2nd-order
    unity-gain Sallen-Key (10k/10k, 2 nF/1 nF, f0 11.25 kHz, Q 0.707),
    measured response, anti-aliasing table, 4-channel TL074 pinout,
    +/-15 V isolated supply and the grounding rule. New schematic,
    frequency-response plot and breadboard layout figures.
    - Edge node layer: map to S1-S3 / C1-C2, current hardware, sampling
    (29,998.5 S/s), windowing, 160-byte packet, link, verification and
    open items. Keyphasor, proximity and angular resampling moved to
    optional future work.
    - Pipeline details: the 8 implemented components, firmware structure,
    worked example at 3600 RPM and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
2026-11-05 docs(overview): update COE status (filter built, Keyphasor optional, 160-byte packet)
2026-11-05 docs(claude): main is the reference branch; record the built COE system
    - git-workflow/up2 rules and CLAUDE.md: main is the reference branch,
    feature branches merge into main; dev/stage no longer used.
    - FACTS.md and CLAUDE.md: built COE chain (2nd-order Sallen-Key LPF,
    29,998.5 S/s, 160-byte packet). The old 152-byte and 4th-order MFB
    facts are struck through, not deleted. The host decoder still
    expects 152 bytes and needs updating.
2026-11-11 docs: explain the node's LED colours in the recorder README
2026-11-12 feat: COE folder with separate training and inference receivers
    All COE code now lives in COE/, apart from the AI code:
    - COE/training: the labelled-data recorder (moved from tools/training_recorder)
    - COE/inference: new live receiver; each window goes to model_hook.predict(),
    run in a worker so a slow model never delays the node
    - COE/README.md: connecting to the node, LED colours, window format
2026-11-12 feat: add the COE node firmware (STM32 + ESP32) under COE/firmware
    COE/firmware/stm32: STM32H755 acquisition + DSP (from coe_firmware d61e2f6-era HEAD)
    COE/firmware/esp32: ESP32-C6 Wi-Fi COE-NODE + forwarding (from coe_esp32 HEAD)
    Both build from this folder as cloned (checked: STM32 LIVE and REPLAY,
    ESP32 idf.py build). No private settings: the ESP builds as COE-NODE only;
    a hotspot goes in the git-ignored connection_settings.local.h.
