amussab/Digital-Twin-Senior-Proj/(notices)

Notices in the files:
COE/firmware/stm32/CM7/Core/Inc/main.h:
Copyright (c) 2026 STMicroelectronics.
All rights reserved.
This software is licensed under terms that can be found in the LICENSE file
